maltanar/equine-health-monitor-gdp12/report/Images/pcb_mic.pdf

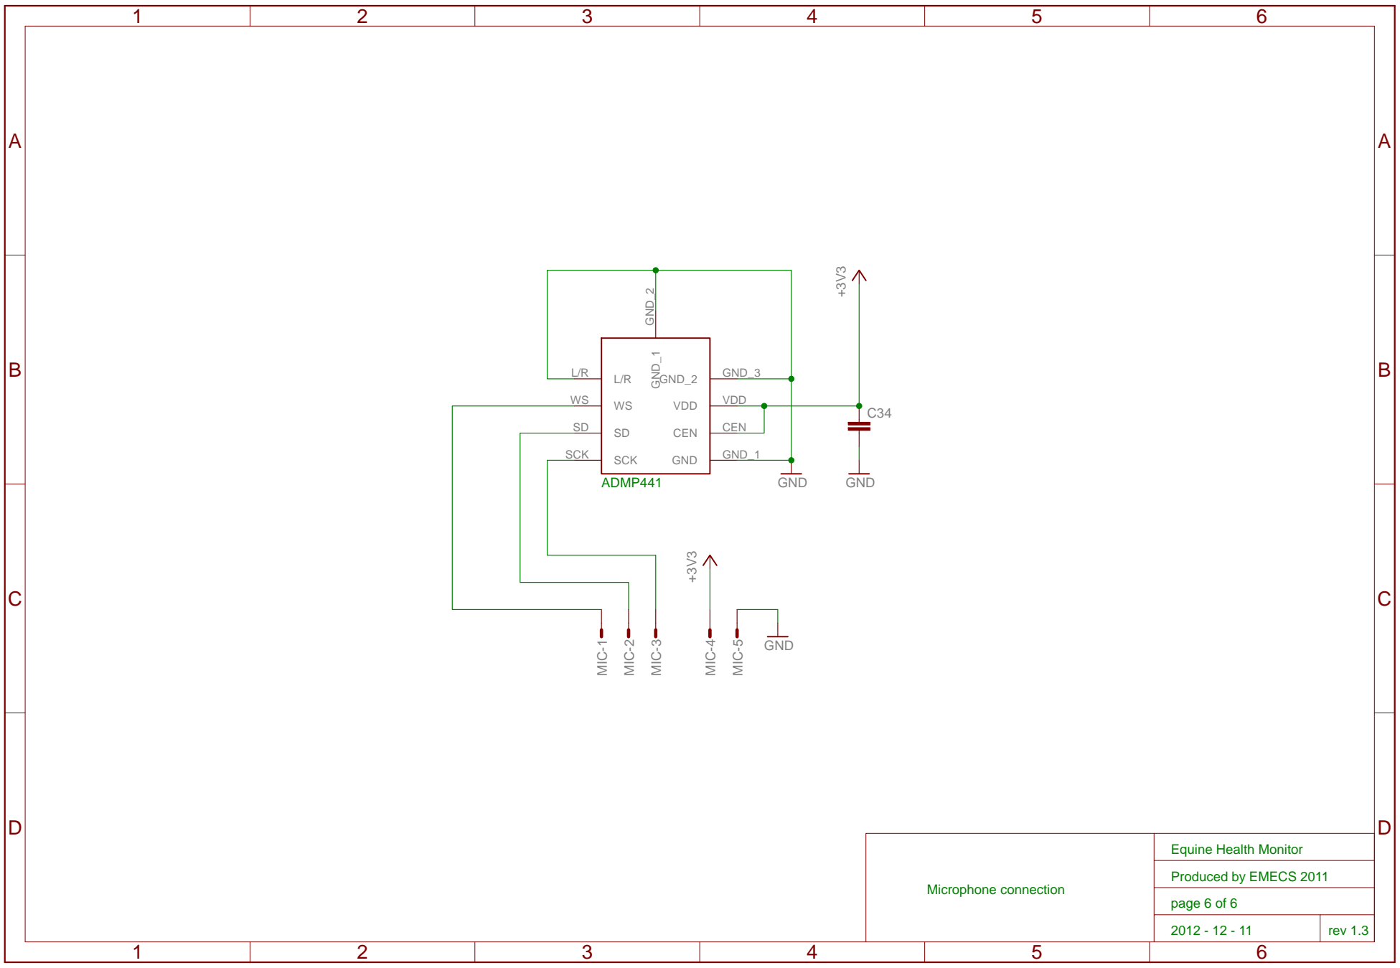
[picture p48: figure]
GND; SCK SCK; GND_1 GND_2 GND_2 GND_3; VDD; CEN; GND_1; MIC-1; MIC-2; MIC-3; MIC-4; MIC-5; ADMP441; Equine Health Monitor; Produced by EMECS 2011; page 6 of 6; rev 1.3; Microphone connection
