maltanar/equine-health-monitor-gdp12/report/Images/battery_charging.pdf

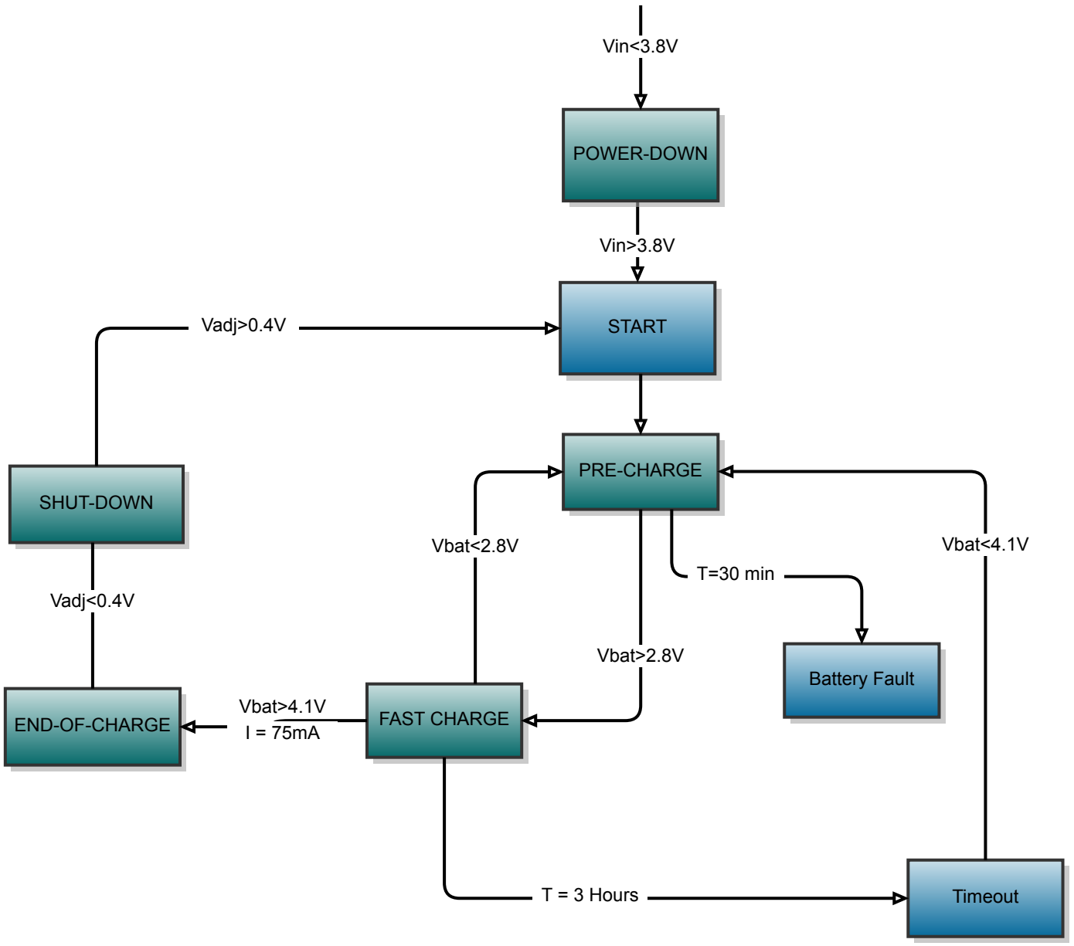
[picture p49: figure]
START; PRE-CHARGE; FAST CHARGE END-OF-CHARGE; Battery Fault; T=30 min; Vin<3.8V Vin>3.8V; SHUT-DOWN; Vbat>2.8V; Vbat>4.1V I = 75mA; Vadj<0.4V; Vbat<2.8V; T = 3 Hours; Timeout; Vbat<4.1V; Vadj>0.4V; POWER-DOWN; Vin<3.8V
