maltanar/equine-health-monitor-gdp12/report/Images/temp_barrier.pdf

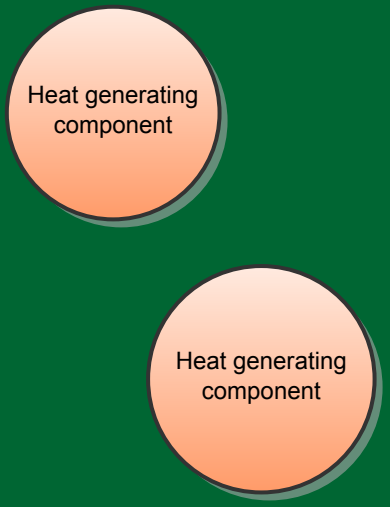
[picture p50: figure]
Heat generating component
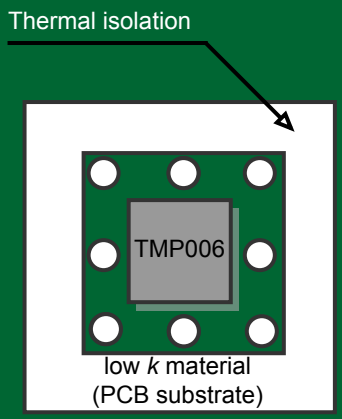
[picture p51: figure]
TMP006; Thermal isolation; low k material (PCB substrate)

high k material (Copper)
