maltanar/equine-health-monitor-gdp12/report/Images/monitoringdevice_dataflow.pdf

configuration messages from base station (set sensor period, turn on/off, configure and read parameters...)

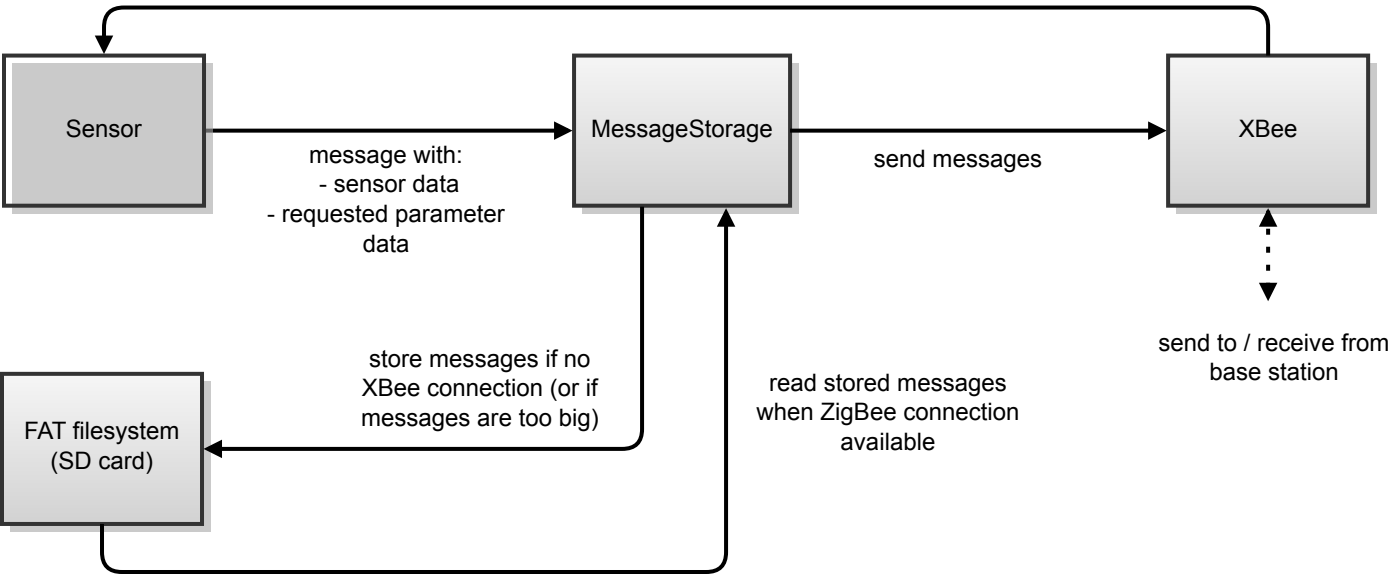
[picture p52: figure]
MessageStorage; FAT filesystem (SD card); Sensor; XBee; message with: - sensor data - requested parameter data; read stored messages when ZigBee connection available; store messages if no XBee connection (or if messages are too big); send to / receive from base station; send messages
