maltanar/equine-health-monitor-gdp12/report/Images/sampling_comparison.pdf

Polling sensor for data | Low energy periodic sampling

while(1)
{
c = readSensor();
if(c != DATA_NOT_READY)
processData(c);
}

while(1)
{
sleepUntilPeriod();
enablePeripheral();
sleepUntilDataReady();
readPeripheral();
}

MCU current

sensor current

phase | A | B | C | D
A
MCU current

sensor current
