maltanar/equine-health-monitor-gdp12/report/Images/Thermal_profile_for_ADXL350.pdf

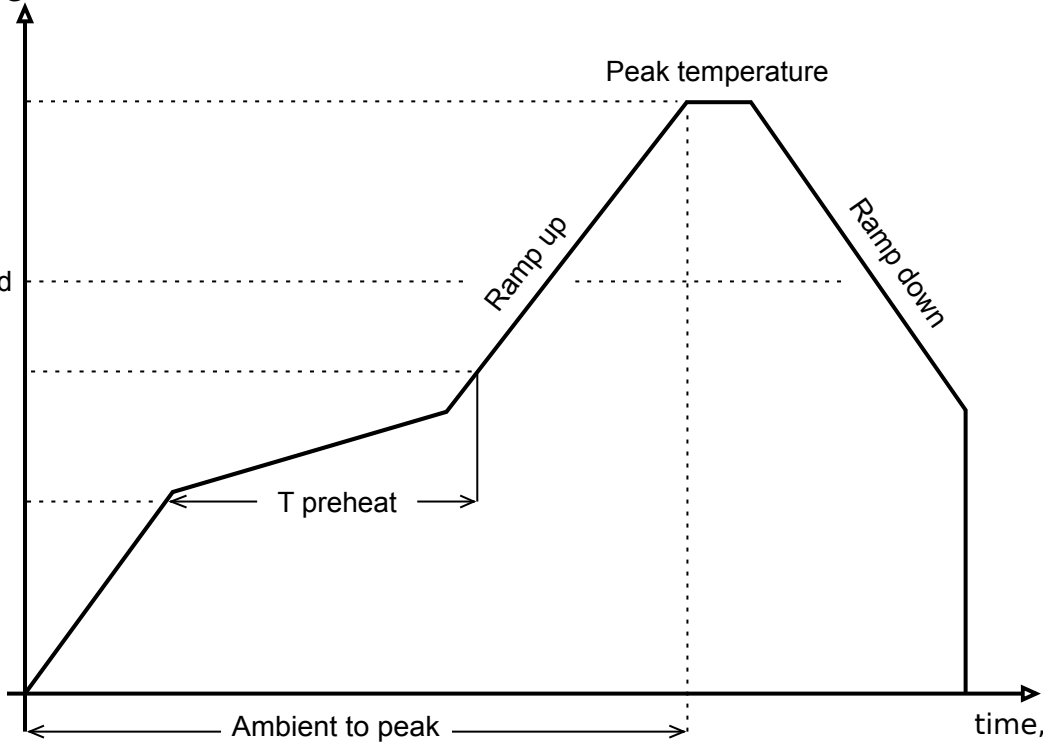
[picture p53: figure]
T preheat; Peak temperature; Ambient to peak; Ramp up; Ramp down

260C

T liquid

150C

100C

8 mins

20C

temp, C

time, min
