maltanar/equine-health-monitor-gdp12/report/Images/Thermal_profile_used.pdf

260C

Peak temperature

# Ambient to peak Ramp up

Cool down

20C

50C

13 mins

temp, C

time, min
