maltanar/equine-health-monitor-gdp12/report/dsl.tex

% redefine the icon used within the itemize environment
\renewcommand{\labelitemi}{$\diamond$}

% a custom environment that can be used to add all kinds of content
% in a centered minipage
\newenvironment{minicenter}[1][0.9]
{\begin{center}\begin{minipage}{#1\textwidth}}
{\end{minipage}\end{center}}

% define custom  environment for embedding LaTeX sourcecode
\lstnewenvironment{lx}[1][numbers=none]
{\hfill\lstset{style=myLaTeX,tabsize=2, #1}\minipage{0.9\textwidth}}
{\endminipage\hfill\null}

% command to print the text in bold and white  
% used for row / column descriptors of tables
\newcommand{\tbldescr}[1]{\textcolor{White}{\textbf{#1}}}

% command to insert a TODO marker
\newcommand{\TODO}[1]{\fcolorbox{Red}{Yellow}{
\texttt{\large
\textbf{\#TODO: #1}
}}}

\newenvironment{myacknowledgements}{%
  \renewcommand*{\abstractname}{Acknowledgments} \abstract}{%
  \endabstract
}

% custom design of the abstract section
\newenvironment{ecsabstract}
{
	\thispagestyle{empty}
	\null\vfil
	\begin{center}
		\setlength{\parskip}{0pt}
		{\normalsize \UNIVERSITY \par}
		\bigskip
		{\underline{ABSTRACT} \par}
		\bigskip
		{\normalsize \faculty \par}
		\bigskip
		{\normalsize {A Group Design Project report submitted as part of}\par
		{the European Masters on Embedded Computing Systems (EMECS)}\par}
		\bigskip
		{\normalsize\bf \mytitle \par}
		\medskip
		{\normalsize by \myauthor, \myauthori, \myauthorii, \myauthoriii \myauthoriv \par}
		\bigskip
	  \end{center}
}{\clearpage}

\newenvironment{test}{\bfseries}{}
