maltanar/equine-health-monitor-gdp12/report/Images/design_challenges.pdf

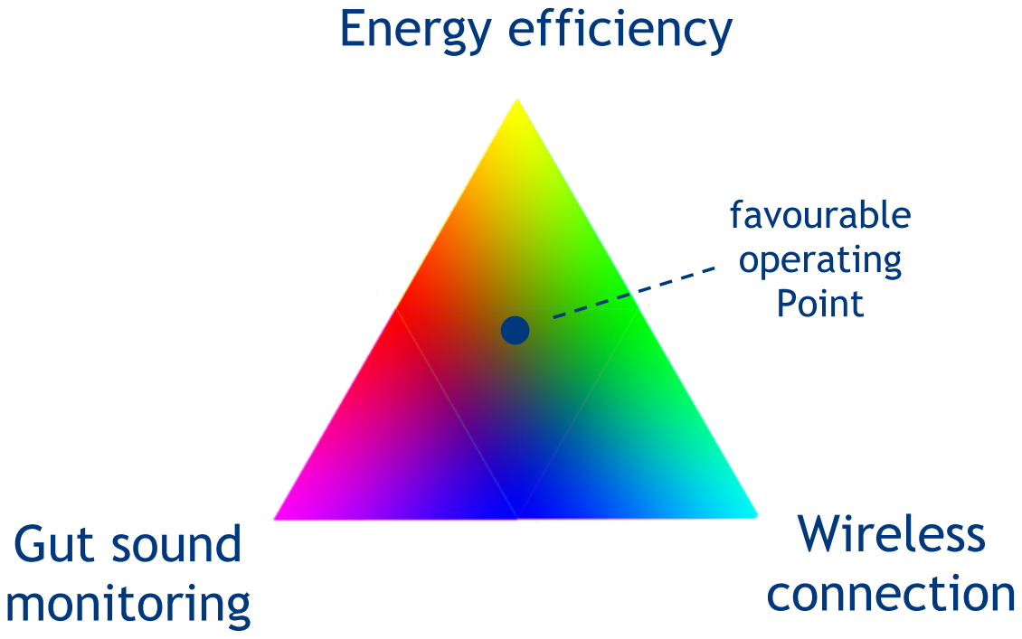
[picture p54: page 1]
