maltanar/equine-health-monitor-gdp12/report/Images/integration.jpg

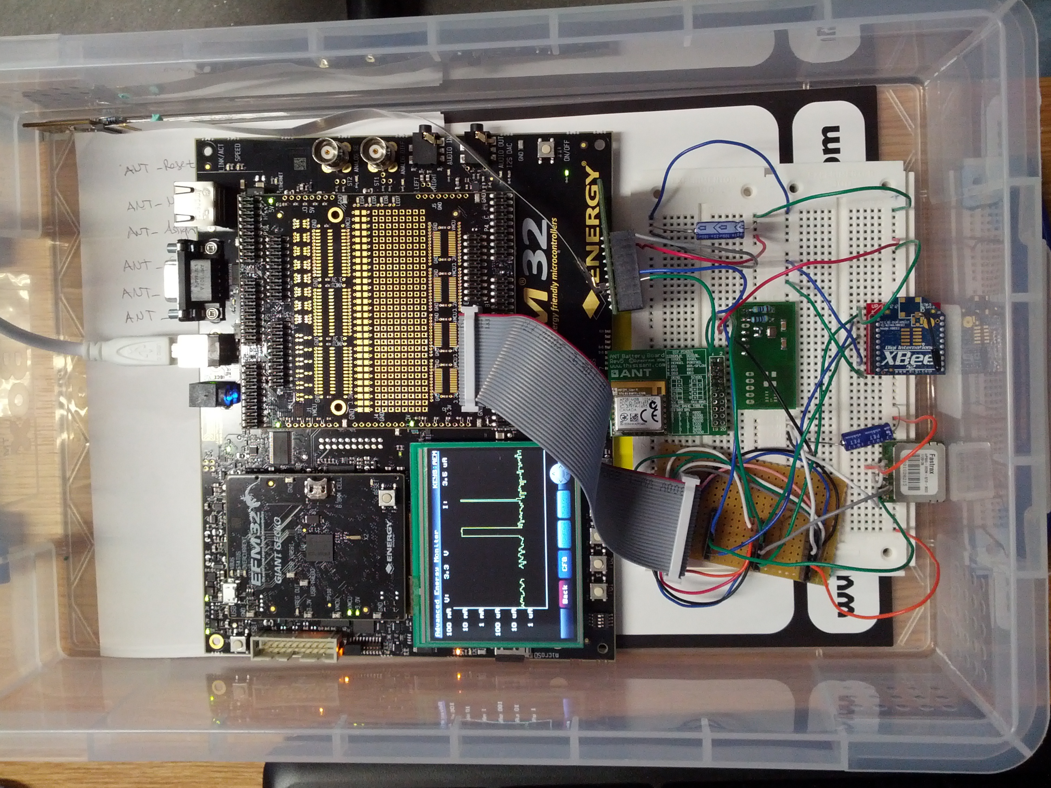
report/Images/integration.jpg
