maltanar/equine-health-monitor-gdp12/report/Images/message_storage_lifecycle.png

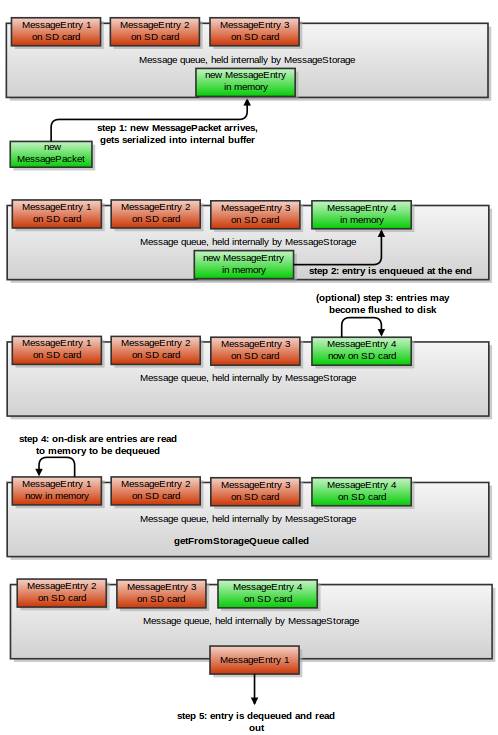
report/Images/message_storage_lifecycle.png
