maltanar/equine-health-monitor-gdp12/report/Images/mic_profile_merged.png

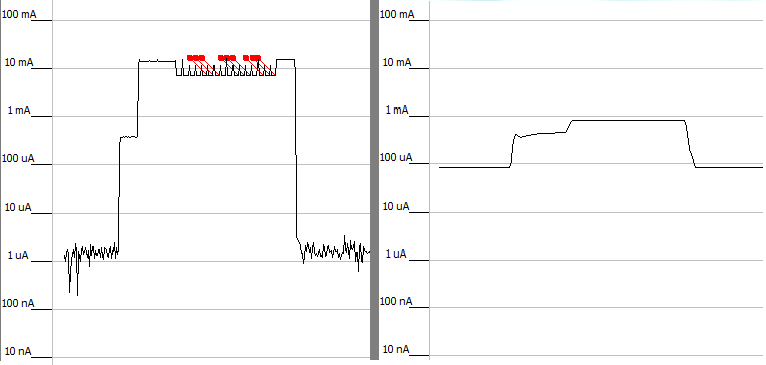
report/Images/mic_profile_merged.png
