maltanar/equine-health-monitor-gdp12/report/Content/results.tex

\chapter{Results}
\label{chap:results}
\TODO{}
