maltanar/equine-health-monitor-gdp12/report/Images/gdp_system_block.pdf

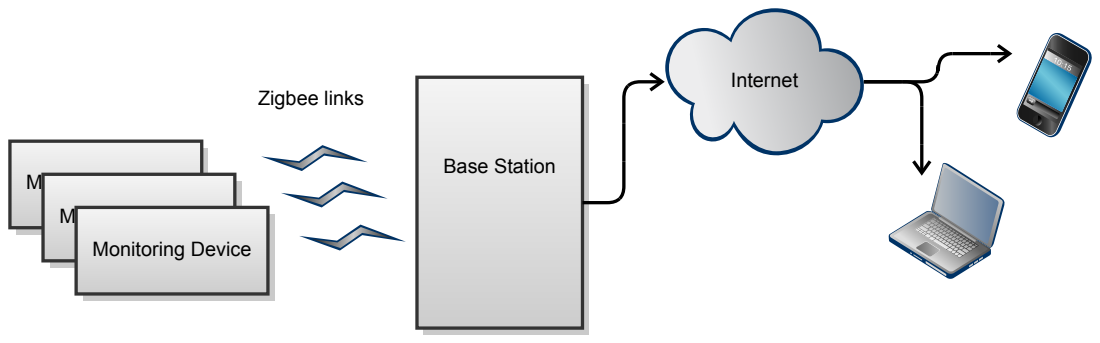
[picture p63: page 1]
Base Station; Internet; Zigbee links; Monitoring Device
