maltanar/equine-health-monitor-gdp12/report/Images/pcb_power_ldo.pdf

A

A

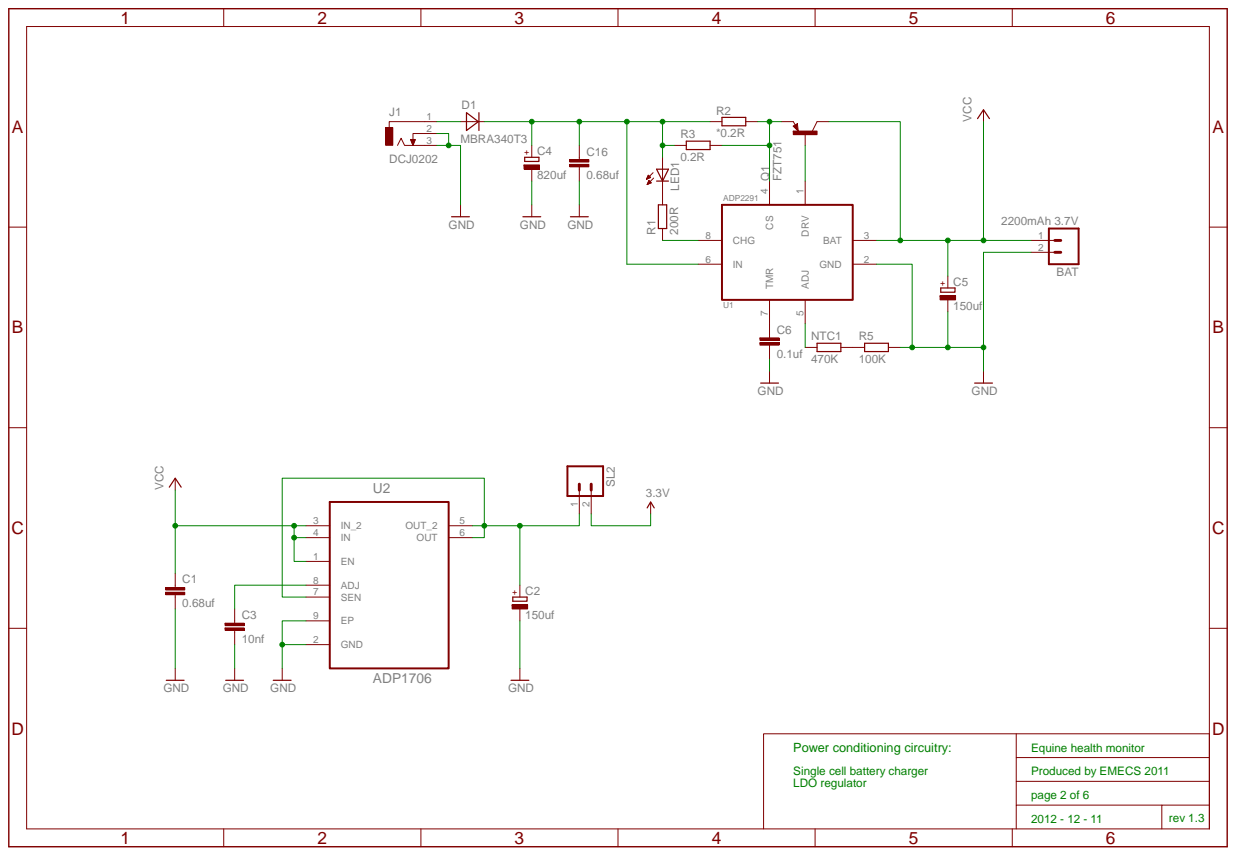
[picture p64: page 1]

Power conditioning circuitry:
Single cell battery charger
LDO regulator
