maltanar/equine-health-monitor-gdp12/report/Images/BaseStationBlockDiagram.pdf

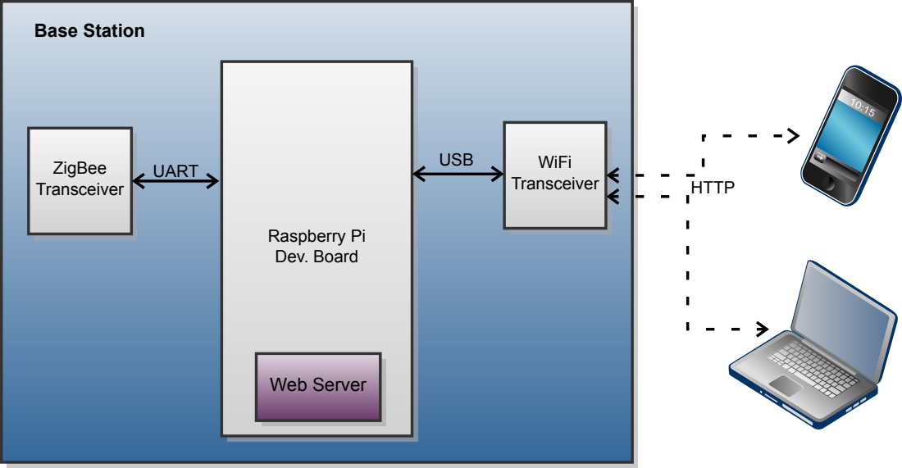
[picture p67: page 1]
Raspberry Pi Dev. Board; ZigBee Transceiver; WiFi Transceiver; UART; USB; HTTP; Base Station; Web Server
