maltanar/equine-health-monitor-gdp12/report/Images/pcb_debug_mic.pdf

A

A

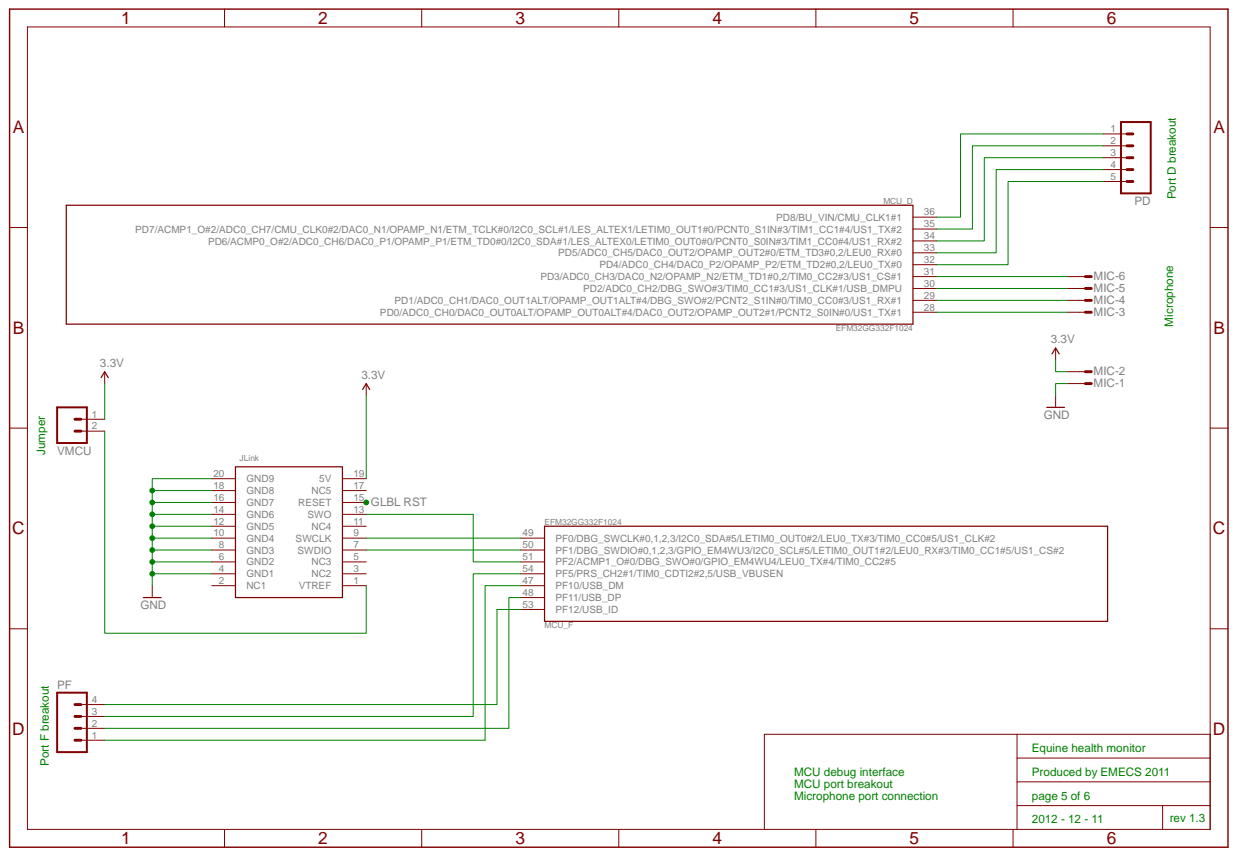
[picture p68: page 1]
GLBL RST; EFM32GG332F1024; GND; PD0/ADC0_CH0/DAC0_OUT0ALT/OPAMP_OUT0ALT#4/DAC0_OUT2/OPAMP_OUT2#1/PCNT2_S0IN#0/US1_TX#1; 28 PD1/ADC0_CH1/DAC0_OUT1ALT/OPAMP_OUT1ALT#4/DBG_SWO#2/PCNT2_S1IN#0/TIM0_CC0#3/US1_RX#1; 29 PD2/ADC0_CH2/DBG_SWO#3/TIM0_CC1#3/US1_CLK#1/USB_DMPU; 30 PD3/ADC0_CH3/DAC0_N2/OPAMP_N2/ETM_TD1#0,2/TIM0_CC2#3/US1_CS#1; 31 PD4/ADC0_CH4/DAC0_P2/OPAMP_P2/ETM_TD2#0,2/LEU0_TX#0; 32 PD5/ADC0_CH5/DAC0_OUT2/OPAMP_OUT2#0/ETM_TD3#0,2/LEU0_RX#0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

Port D breakout Microphone

Port F breakout Jumper

Equine health monitor
Produced by EMECS 2011
page 5 of 6

MCU debug interface
MCU port breakout
Microphone port connection
