maltanar/equine-health-monitor-gdp12/report/Images/pcb_ant.pdf

A

A

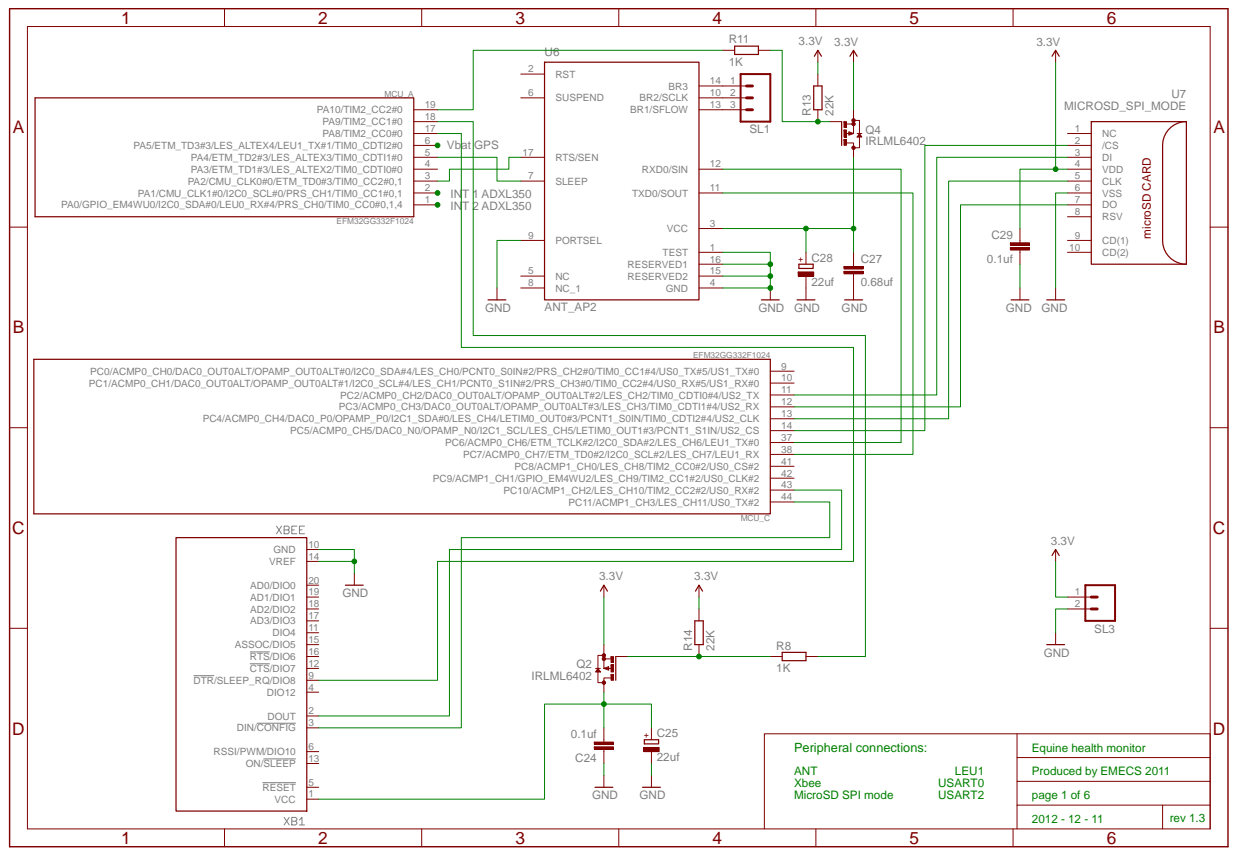
[picture p69: page 1]
