maltanar/equine-health-monitor-gdp12/report/Images/pcb_i2c_gps.pdf

A

A

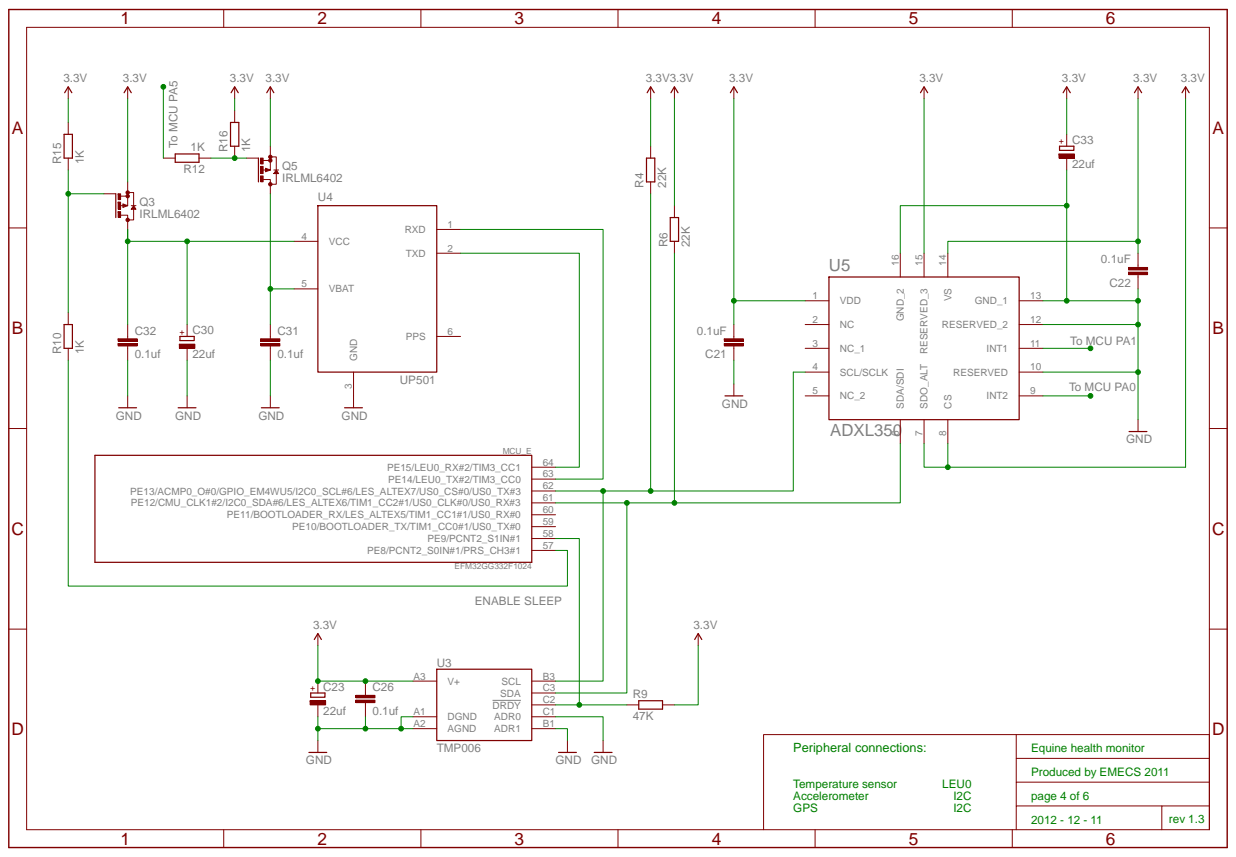
[picture p70: page 1]
