maltanar/equine-health-monitor-gdp12/report/Images/pcb_mcu_osc_reset.pdf

A

A

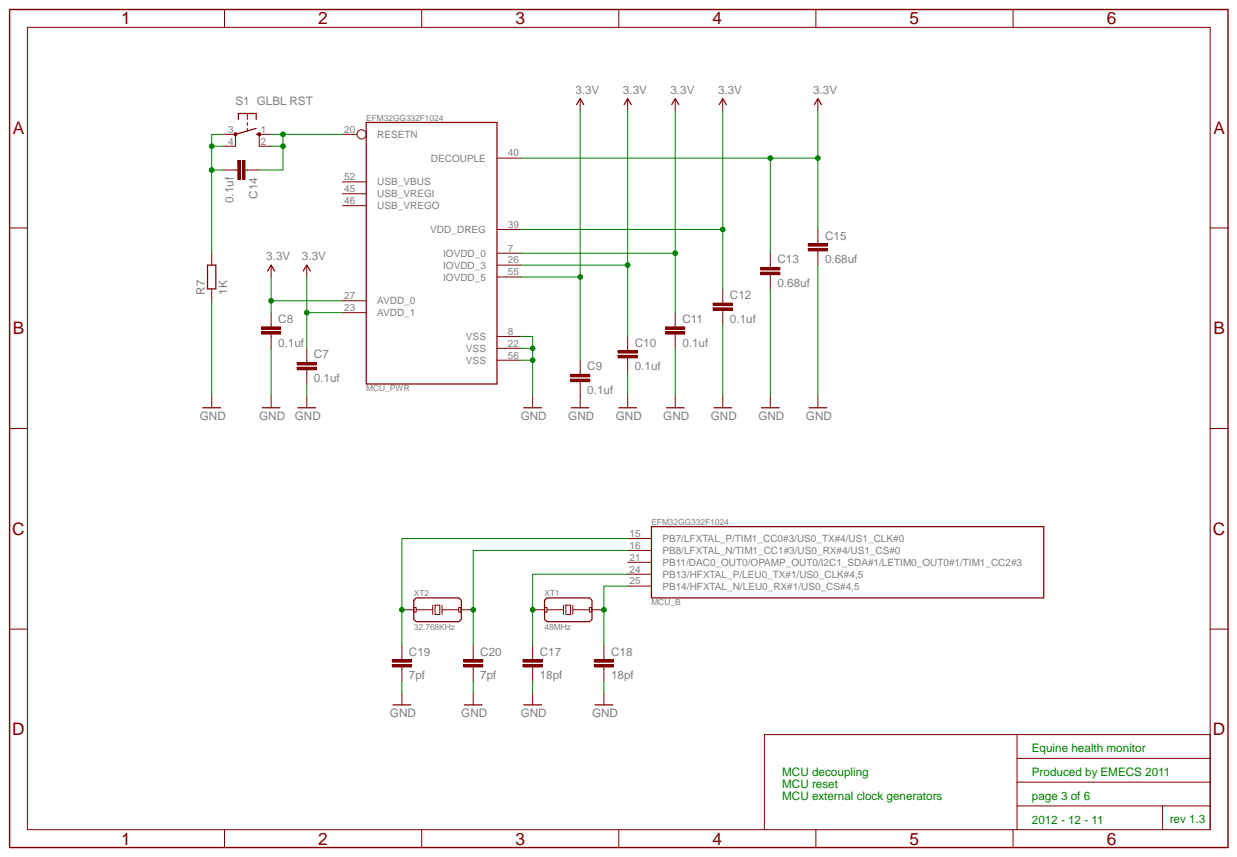
[picture p71: page 1]

MCU decoupling
MCU reset
MCU external clock generators
