maltanar/equine-health-monitor-gdp12/report/Images/dummy.pdf

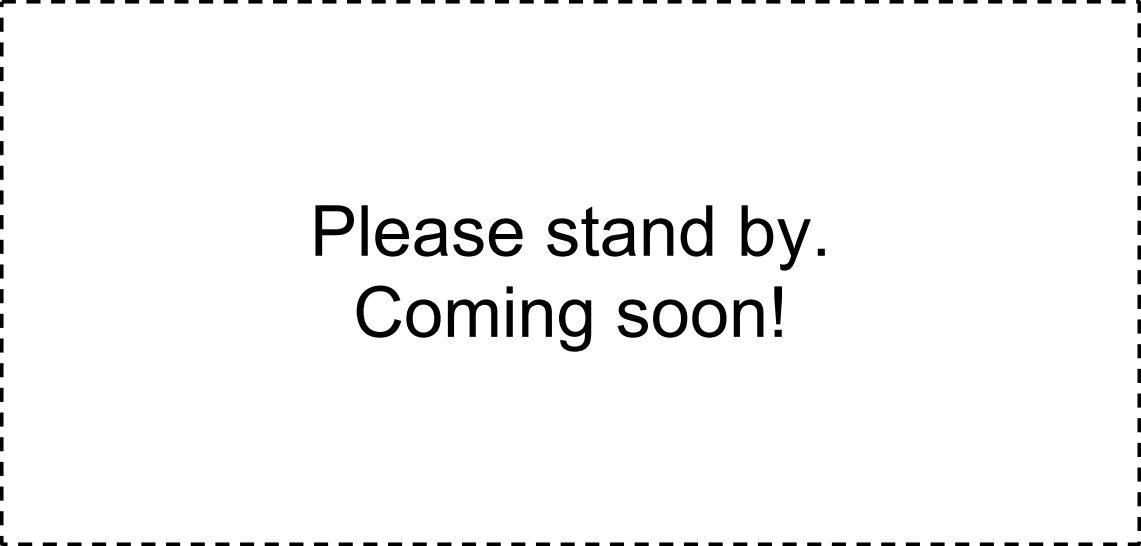
[picture p72: page 1]
