maltanar/equine-health-monitor-gdp12/pcb-monitoringdevice/common/Device/EnergyMicro/EFM32GG/Include/efm32gg_gpio.h

/**************************************************************************//**
 * @file
 * @brief efm32gg_gpio Register and Bit Field definitions
 * @author Energy Micro AS
 * @version 3.0.1
 ******************************************************************************
 * @section License
 * <b>(C) Copyright 2012 Energy Micro AS, http://www.energymicro.com</b>
 ******************************************************************************
 *
 * Permission is granted to anyone to use this software for any purpose,
 * including commercial applications, and to alter it and redistribute it
 * freely, subject to the following restrictions:
 *
 * 1. The origin of this software must not be misrepresented; you must not
 *    claim that you wrote the original software.
 * 2. Altered source versions must be plainly marked as such, and must not be
 *    misrepresented as being the original software.
 * 3. This notice may not be removed or altered from any source distribution.
 *
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
 * Energy Micro AS will not be liable for any consequential, incidental, or
 * special damages, or any other relief, or for any claim by any third party,
 * arising from your use of this Software.
 *
 *****************************************************************************/
/**************************************************************************//**
 * @defgroup EFM32GG_GPIO
 * @{
 * @brief EFM32GG_GPIO Register Declaration
 *****************************************************************************/
typedef struct
{
  GPIO_P_TypeDef P[6];          /**< Port configuration bits */

  uint32_t       RESERVED0[10]; /**< Reserved for future use **/
  __IO uint32_t  EXTIPSELL;     /**< External Interrupt Port Select Low Register  */
  __IO uint32_t  EXTIPSELH;     /**< External Interrupt Port Select High Register  */
  __IO uint32_t  EXTIRISE;      /**< External Interrupt Rising Edge Trigger Register  */
  __IO uint32_t  EXTIFALL;      /**< External Interrupt Falling Edge Trigger Register  */
  __IO uint32_t  IEN;           /**< Interrupt Enable Register  */
  __I uint32_t   IF;            /**< Interrupt Flag Register  */
  __IO uint32_t  IFS;           /**< Interrupt Flag Set Register  */
  __IO uint32_t  IFC;           /**< Interrupt Flag Clear Register  */

  __IO uint32_t  ROUTE;         /**< I/O Routing Register  */
  __IO uint32_t  INSENSE;       /**< Input Sense Register  */
  __IO uint32_t  LOCK;          /**< Configuration Lock Register  */
  __IO uint32_t  CTRL;          /**< GPIO Control Register  */
  __IO uint32_t  CMD;           /**< GPIO Command Register  */
  __IO uint32_t  EM4WUEN;       /**< EM4 Wake-up Enable Register  */
  __IO uint32_t  EM4WUPOL;      /**< EM4 Wake-up Polarity Register  */
  __I uint32_t   EM4WUCAUSE;    /**< EM4 Wake-up Cause Register  */
} GPIO_TypeDef;                 /** @} */

/**************************************************************************//**
 * @defgroup EFM32GG_GPIO_BitFields
 * @{
 *****************************************************************************/

/* Bit fields for GPIO P_CTRL */
#define _GPIO_P_CTRL_RESETVALUE                           0x00000000UL                           /**< Default value for GPIO_P_CTRL */
#define _GPIO_P_CTRL_MASK                                 0x00000003UL                           /**< Mask for GPIO_P_CTRL */
#define _GPIO_P_CTRL_DRIVEMODE_SHIFT                      0                                      /**< Shift value for GPIO_DRIVEMODE */
#define _GPIO_P_CTRL_DRIVEMODE_MASK                       0x3UL                                  /**< Bit mask for GPIO_DRIVEMODE */
#define _GPIO_P_CTRL_DRIVEMODE_DEFAULT                    0x00000000UL                           /**< Mode DEFAULT for GPIO_P_CTRL */
#define _GPIO_P_CTRL_DRIVEMODE_STANDARD                   0x00000000UL                           /**< Mode STANDARD for GPIO_P_CTRL */
#define _GPIO_P_CTRL_DRIVEMODE_LOWEST                     0x00000001UL                           /**< Mode LOWEST for GPIO_P_CTRL */
#define _GPIO_P_CTRL_DRIVEMODE_HIGH                       0x00000002UL                           /**< Mode HIGH for GPIO_P_CTRL */
#define _GPIO_P_CTRL_DRIVEMODE_LOW                        0x00000003UL                           /**< Mode LOW for GPIO_P_CTRL */
#define GPIO_P_CTRL_DRIVEMODE_DEFAULT                     (_GPIO_P_CTRL_DRIVEMODE_DEFAULT << 0)  /**< Shifted mode DEFAULT for GPIO_P_CTRL */
#define GPIO_P_CTRL_DRIVEMODE_STANDARD                    (_GPIO_P_CTRL_DRIVEMODE_STANDARD << 0) /**< Shifted mode STANDARD for GPIO_P_CTRL */
#define GPIO_P_CTRL_DRIVEMODE_LOWEST                      (_GPIO_P_CTRL_DRIVEMODE_LOWEST << 0)   /**< Shifted mode LOWEST for GPIO_P_CTRL */
#define GPIO_P_CTRL_DRIVEMODE_HIGH                        (_GPIO_P_CTRL_DRIVEMODE_HIGH << 0)     /**< Shifted mode HIGH for GPIO_P_CTRL */
#define GPIO_P_CTRL_DRIVEMODE_LOW                         (_GPIO_P_CTRL_DRIVEMODE_LOW << 0)      /**< Shifted mode LOW for GPIO_P_CTRL */

/* Bit fields for GPIO P_MODEL */
#define _GPIO_P_MODEL_RESETVALUE                          0x00000000UL                                          /**< Default value for GPIO_P_MODEL */
#define _GPIO_P_MODEL_MASK                                0xFFFFFFFFUL                                          /**< Mask for GPIO_P_MODEL */
#define _GPIO_P_MODEL_MODE0_SHIFT                         0                                                     /**< Shift value for GPIO_MODE0 */
#define _GPIO_P_MODEL_MODE0_MASK                          0xFUL                                                 /**< Bit mask for GPIO_MODE0 */
#define _GPIO_P_MODEL_MODE0_DEFAULT                       0x00000000UL                                          /**< Mode DEFAULT for GPIO_P_MODEL */
#define _GPIO_P_MODEL_MODE0_DISABLED                      0x00000000UL                                          /**< Mode DISABLED for GPIO_P_MODEL */
#define _GPIO_P_MODEL_MODE0_INPUT                         0x00000001UL                                          /**< Mode INPUT for GPIO_P_MODEL */
#define _GPIO_P_MODEL_MODE0_INPUTPULL                     0x00000002UL                                          /**< Mode INPUTPULL for GPIO_P_MODEL */
#define _GPIO_P_MODEL_MODE0_INPUTPULLFILTER               0x00000003UL                                          /**< Mode INPUTPULLFILTER for GPIO_P_MODEL */
#define _GPIO_P_MODEL_MODE0_PUSHPULL                      0x00000004UL                                          /**< Mode PUSHPULL for GPIO_P_MODEL */
#define _GPIO_P_MODEL_MODE0_PUSHPULLDRIVE                 0x00000005UL                                          /**< Mode PUSHPULLDRIVE for GPIO_P_MODEL */
#define _GPIO_P_MODEL_MODE0_WIREDOR                       0x00000006UL                                          /**< Mode WIREDOR for GPIO_P_MODEL */
#define _GPIO_P_MODEL_MODE0_WIREDORPULLDOWN               0x00000007UL                                          /**< Mode WIREDORPULLDOWN for GPIO_P_MODEL */
#define _GPIO_P_MODEL_MODE0_WIREDAND                      0x00000008UL                                          /**< Mode WIREDAND for GPIO_P_MODEL */
#define _GPIO_P_MODEL_MODE0_WIREDANDFILTER                0x00000009UL                                          /**< Mode WIREDANDFILTER for GPIO_P_MODEL */
#define _GPIO_P_MODEL_MODE0_WIREDANDPULLUP                0x0000000AUL                                          /**< Mode WIREDANDPULLUP for GPIO_P_MODEL */
#define _GPIO_P_MODEL_MODE0_WIREDANDPULLUPFILTER          0x0000000BUL                                          /**< Mode WIREDANDPULLUPFILTER for GPIO_P_MODEL */
#define _GPIO_P_MODEL_MODE0_WIREDANDDRIVE                 0x0000000CUL                                          /**< Mode WIREDANDDRIVE for GPIO_P_MODEL */
#define _GPIO_P_MODEL_MODE0_WIREDANDDRIVEFILTER           0x0000000DUL                                          /**< Mode WIREDANDDRIVEFILTER for GPIO_P_MODEL */
#define _GPIO_P_MODEL_MODE0_WIREDANDDRIVEPULLUP           0x0000000EUL                                          /**< Mode WIREDANDDRIVEPULLUP for GPIO_P_MODEL */
#define _GPIO_P_MODEL_MODE0_WIREDANDDRIVEPULLUPFILTER     0x0000000FUL                                          /**< Mode WIREDANDDRIVEPULLUPFILTER for GPIO_P_MODEL */
#define GPIO_P_MODEL_MODE0_DEFAULT                        (_GPIO_P_MODEL_MODE0_DEFAULT << 0)                    /**< Shifted mode DEFAULT for GPIO_P_MODEL */
#define GPIO_P_MODEL_MODE0_DISABLED                       (_GPIO_P_MODEL_MODE0_DISABLED << 0)                   /**< Shifted mode DISABLED for GPIO_P_MODEL */
#define GPIO_P_MODEL_MODE0_INPUT                          (_GPIO_P_MODEL_MODE0_INPUT << 0)                      /**< Shifted mode INPUT for GPIO_P_MODEL */
#define GPIO_P_MODEL_MODE0_INPUTPULL                      (_GPIO_P_MODEL_MODE0_INPUTPULL << 0)                  /**< Shifted mode INPUTPULL for GPIO_P_MODEL */
#define GPIO_P_MODEL_MODE0_INPUTPULLFILTER                (_GPIO_P_MODEL_MODE0_INPUTPULLFILTER << 0)            /**< Shifted mode INPUTPULLFILTER for GPIO_P_MODEL */
#define GPIO_P_MODEL_MODE0_PUSHPULL                       (_GPIO_P_MODEL_MODE0_PUSHPULL << 0)                   /**< Shifted mode PUSHPULL for GPIO_P_MODEL */
#define GPIO_P_MODEL_MODE0_PUSHPULLDRIVE                  (_GPIO_P_MODEL_MODE0_PUSHPULLDRIVE << 0)              /**< Shifted mode PUSHPULLDRIVE for GPIO_P_MODEL */
#define GPIO_P_MODEL_MODE0_WIREDOR                        (_GPIO_P_MODEL_MODE0_WIREDOR << 0)                    /**< Shifted mode WIREDOR for GPIO_P_MODEL */
#define GPIO_P_MODEL_MODE0_WIREDORPULLDOWN                (_GPIO_P_MODEL_MODE0_WIREDORPULLDOWN << 0)            /**< Shifted mode WIREDORPULLDOWN for GPIO_P_MODEL */
#define GPIO_P_MODEL_MODE0_WIREDAND                       (_GPIO_P_MODEL_MODE0_WIREDAND << 0)                   /**< Shifted mode WIREDAND for GPIO_P_MODEL */
#define GPIO_P_MODEL_MODE0_WIREDANDFILTER                 (_GPIO_P_MODEL_MODE0_WIREDANDFILTER << 0)             /**< Shifted mode WIREDANDFILTER for GPIO_P_MODEL */
#define GPIO_P_MODEL_MODE0_WIREDANDPULLUP                 (_GPIO_P_MODEL_MODE0_WIREDANDPULLUP << 0)             /**< Shifted mode WIREDANDPULLUP for GPIO_P_MODEL */
#define GPIO_P_MODEL_MODE0_WIREDANDPULLUPFILTER           (_GPIO_P_MODEL_MODE0_WIREDANDPULLUPFILTER << 0)       /**< Shifted mode WIREDANDPULLUPFILTER for GPIO_P_MODEL */
#define GPIO_P_MODEL_MODE0_WIREDANDDRIVE                  (_GPIO_P_MODEL_MODE0_WIREDANDDRIVE << 0)              /**< Shifted mode WIREDANDDRIVE for GPIO_P_MODEL */
#define GPIO_P_MODEL_MODE0_WIREDANDDRIVEFILTER            (_GPIO_P_MODEL_MODE0_WIREDANDDRIVEFILTER << 0)        /**< Shifted mode WIREDANDDRIVEFILTER for GPIO_P_MODEL */
#define GPIO_P_MODEL_MODE0_WIREDANDDRIVEPULLUP            (_GPIO_P_MODEL_MODE0_WIREDANDDRIVEPULLUP << 0)        /**< Shifted mode WIREDANDDRIVEPULLUP for GPIO_P_MODEL */
#define GPIO_P_MODEL_MODE0_WIREDANDDRIVEPULLUPFILTER      (_GPIO_P_MODEL_MODE0_WIREDANDDRIVEPULLUPFILTER << 0)  /**< Shifted mode WIREDANDDRIVEPULLUPFILTER for GPIO_P_MODEL */
#define _GPIO_P_MODEL_MODE1_SHIFT                         4                                                     /**< Shift value for GPIO_MODE1 */
#define _GPIO_P_MODEL_MODE1_MASK                          0xF0UL                                                /**< Bit mask for GPIO_MODE1 */
#define _GPIO_P_MODEL_MODE1_DEFAULT                       0x00000000UL                                          /**< Mode DEFAULT for GPIO_P_MODEL */
#define _GPIO_P_MODEL_MODE1_DISABLED                      0x00000000UL                                          /**< Mode DISABLED for GPIO_P_MODEL */
#define _GPIO_P_MODEL_MODE1_INPUT                         0x00000001UL                                          /**< Mode INPUT for GPIO_P_MODEL */
#define _GPIO_P_MODEL_MODE1_INPUTPULL                     0x00000002UL                                          /**< Mode INPUTPULL for GPIO_P_MODEL */
#define _GPIO_P_MODEL_MODE1_INPUTPULLFILTER               0x00000003UL                                          /**< Mode INPUTPULLFILTER for GPIO_P_MODEL */
#define _GPIO_P_MODEL_MODE1_PUSHPULL                      0x00000004UL                                          /**< Mode PUSHPULL for GPIO_P_MODEL */
#define _GPIO_P_MODEL_MODE1_PUSHPULLDRIVE                 0x00000005UL                                          /**< Mode PUSHPULLDRIVE for GPIO_P_MODEL */
#define _GPIO_P_MODEL_MODE1_WIREDOR                       0x00000006UL                                          /**< Mode WIREDOR for GPIO_P_MODEL */
#define _GPIO_P_MODEL_MODE1_WIREDORPULLDOWN               0x00000007UL                                          /**< Mode WIREDORPULLDOWN for GPIO_P_MODEL */
#define _GPIO_P_MODEL_MODE1_WIREDAND                      0x00000008UL                                          /**< Mode WIREDAND for GPIO_P_MODEL */
#define _GPIO_P_MODEL_MODE1_WIREDANDFILTER                0x00000009UL                                          /**< Mode WIREDANDFILTER for GPIO_P_MODEL */
#define _GPIO_P_MODEL_MODE1_WIREDANDPULLUP                0x0000000AUL                                          /**< Mode WIREDANDPULLUP for GPIO_P_MODEL */
#define _GPIO_P_MODEL_MODE1_WIREDANDPULLUPFILTER          0x0000000BUL                                          /**< Mode WIREDANDPULLUPFILTER for GPIO_P_MODEL */
#define _GPIO_P_MODEL_MODE1_WIREDANDDRIVE                 0x0000000CUL                                          /**< Mode WIREDANDDRIVE for GPIO_P_MODEL */
#define _GPIO_P_MODEL_MODE1_WIREDANDDRIVEFILTER           0x0000000DUL                                          /**< Mode WIREDANDDRIVEFILTER for GPIO_P_MODEL */
#define _GPIO_P_MODEL_MODE1_WIREDANDDRIVEPULLUP           0x0000000EUL                                          /**< Mode WIREDANDDRIVEPULLUP for GPIO_P_MODEL */
#define _GPIO_P_MODEL_MODE1_WIREDANDDRIVEPULLUPFILTER     0x0000000FUL                                          /**< Mode WIREDANDDRIVEPULLUPFILTER for GPIO_P_MODEL */
#define GPIO_P_MODEL_MODE1_DEFAULT                        (_GPIO_P_MODEL_MODE1_DEFAULT << 4)                    /**< Shifted mode DEFAULT for GPIO_P_MODEL */
#define GPIO_P_MODEL_MODE1_DISABLED                       (_GPIO_P_MODEL_MODE1_DISABLED << 4)                   /**< Shifted mode DISABLED for GPIO_P_MODEL */
#define GPIO_P_MODEL_MODE1_INPUT                          (_GPIO_P_MODEL_MODE1_INPUT << 4)                      /**< Shifted mode INPUT for GPIO_P_MODEL */
#define GPIO_P_MODEL_MODE1_INPUTPULL                      (_GPIO_P_MODEL_MODE1_INPUTPULL << 4)                  /**< Shifted mode INPUTPULL for GPIO_P_MODEL */
#define GPIO_P_MODEL_MODE1_INPUTPULLFILTER                (_GPIO_P_MODEL_MODE1_INPUTPULLFILTER << 4)            /**< Shifted mode INPUTPULLFILTER for GPIO_P_MODEL */
#define GPIO_P_MODEL_MODE1_PUSHPULL                       (_GPIO_P_MODEL_MODE1_PUSHPULL << 4)                   /**< Shifted mode PUSHPULL for GPIO_P_MODEL */
#define GPIO_P_MODEL_MODE1_PUSHPULLDRIVE                  (_GPIO_P_MODEL_MODE1_PUSHPULLDRIVE << 4)              /**< Shifted mode PUSHPULLDRIVE for GPIO_P_MODEL */
#define GPIO_P_MODEL_MODE1_WIREDOR                        (_GPIO_P_MODEL_MODE1_WIREDOR << 4)                    /**< Shifted mode WIREDOR for GPIO_P_MODEL */
#define GPIO_P_MODEL_MODE1_WIREDORPULLDOWN                (_GPIO_P_MODEL_MODE1_WIREDORPULLDOWN << 4)            /**< Shifted mode WIREDORPULLDOWN for GPIO_P_MODEL */
#define GPIO_P_MODEL_MODE1_WIREDAND                       (_GPIO_P_MODEL_MODE1_WIREDAND << 4)                   /**< Shifted mode WIREDAND for GPIO_P_MODEL */
#define GPIO_P_MODEL_MODE1_WIREDANDFILTER                 (_GPIO_P_MODEL_MODE1_WIREDANDFILTER << 4)             /**< Shifted mode WIREDANDFILTER for GPIO_P_MODEL */
#define GPIO_P_MODEL_MODE1_WIREDANDPULLUP                 (_GPIO_P_MODEL_MODE1_WIREDANDPULLUP << 4)             /**< Shifted mode WIREDANDPULLUP for GPIO_P_MODEL */
#define GPIO_P_MODEL_MODE1_WIREDANDPULLUPFILTER           (_GPIO_P_MODEL_MODE1_WIREDANDPULLUPFILTER << 4)       /**< Shifted mode WIREDANDPULLUPFILTER for GPIO_P_MODEL */
#define GPIO_P_MODEL_MODE1_WIREDANDDRIVE                  (_GPIO_P_MODEL_MODE1_WIREDANDDRIVE << 4)              /**< Shifted mode WIREDANDDRIVE for GPIO_P_MODEL */
#define GPIO_P_MODEL_MODE1_WIREDANDDRIVEFILTER            (_GPIO_P_MODEL_MODE1_WIREDANDDRIVEFILTER << 4)        /**< Shifted mode WIREDANDDRIVEFILTER for GPIO_P_MODEL */
#define GPIO_P_MODEL_MODE1_WIREDANDDRIVEPULLUP            (_GPIO_P_MODEL_MODE1_WIREDANDDRIVEPULLUP << 4)        /**< Shifted mode WIREDANDDRIVEPULLUP for GPIO_P_MODEL */
#define GPIO_P_MODEL_MODE1_WIREDANDDRIVEPULLUPFILTER      (_GPIO_P_MODEL_MODE1_WIREDANDDRIVEPULLUPFILTER << 4)  /**< Shifted mode WIREDANDDRIVEPULLUPFILTER for GPIO_P_MODEL */
#define _GPIO_P_MODEL_MODE2_SHIFT                         8                                                     /**< Shift value for GPIO_MODE2 */
#define _GPIO_P_MODEL_MODE2_MASK                          0xF00UL                                               /**< Bit mask for GPIO_MODE2 */
#define _GPIO_P_MODEL_MODE2_DEFAULT                       0x00000000UL                                          /**< Mode DEFAULT for GPIO_P_MODEL */
#define _GPIO_P_MODEL_MODE2_DISABLED                      0x00000000UL                                          /**< Mode DISABLED for GPIO_P_MODEL */
#define _GPIO_P_MODEL_MODE2_INPUT                         0x00000001UL                                          /**< Mode INPUT for GPIO_P_MODEL */
#define _GPIO_P_MODEL_MODE2_INPUTPULL                     0x00000002UL                                          /**< Mode INPUTPULL for GPIO_P_MODEL */
#define _GPIO_P_MODEL_MODE2_INPUTPULLFILTER               0x00000003UL                                          /**< Mode INPUTPULLFILTER for GPIO_P_MODEL */
#define _GPIO_P_MODEL_MODE2_PUSHPULL                      0x00000004UL                                          /**< Mode PUSHPULL for GPIO_P_MODEL */
#define _GPIO_P_MODEL_MODE2_PUSHPULLDRIVE                 0x00000005UL                                          /**< Mode PUSHPULLDRIVE for GPIO_P_MODEL */
#define _GPIO_P_MODEL_MODE2_WIREDOR                       0x00000006UL                                          /**< Mode WIREDOR for GPIO_P_MODEL */
#define _GPIO_P_MODEL_MODE2_WIREDORPULLDOWN               0x00000007UL                                          /**< Mode WIREDORPULLDOWN for GPIO_P_MODEL */
#define _GPIO_P_MODEL_MODE2_WIREDAND                      0x00000008UL                                          /**< Mode WIREDAND for GPIO_P_MODEL */
#define _GPIO_P_MODEL_MODE2_WIREDANDFILTER                0x00000009UL                                          /**< Mode WIREDANDFILTER for GPIO_P_MODEL */
#define _GPIO_P_MODEL_MODE2_WIREDANDPULLUP                0x0000000AUL                                          /**< Mode WIREDANDPULLUP for GPIO_P_MODEL */
#define _GPIO_P_MODEL_MODE2_WIREDANDPULLUPFILTER          0x0000000BUL                                          /**< Mode WIREDANDPULLUPFILTER for GPIO_P_MODEL */
#define _GPIO_P_MODEL_MODE2_WIREDANDDRIVE                 0x0000000CUL                                          /**< Mode WIREDANDDRIVE for GPIO_P_MODEL */
#define _GPIO_P_MODEL_MODE2_WIREDANDDRIVEFILTER           0x0000000DUL                                          /**< Mode WIREDANDDRIVEFILTER for GPIO_P_MODEL */
#define _GPIO_P_MODEL_MODE2_WIREDANDDRIVEPULLUP           0x0000000EUL                                          /**< Mode WIREDANDDRIVEPULLUP for GPIO_P_MODEL */
#define _GPIO_P_MODEL_MODE2_WIREDANDDRIVEPULLUPFILTER     0x0000000FUL                                          /**< Mode WIREDANDDRIVEPULLUPFILTER for GPIO_P_MODEL */
#define GPIO_P_MODEL_MODE2_DEFAULT                        (_GPIO_P_MODEL_MODE2_DEFAULT << 8)                    /**< Shifted mode DEFAULT for GPIO_P_MODEL */
#define GPIO_P_MODEL_MODE2_DISABLED                       (_GPIO_P_MODEL_MODE2_DISABLED << 8)                   /**< Shifted mode DISABLED for GPIO_P_MODEL */
#define GPIO_P_MODEL_MODE2_INPUT                          (_GPIO_P_MODEL_MODE2_INPUT << 8)                      /**< Shifted mode INPUT for GPIO_P_MODEL */
#define GPIO_P_MODEL_MODE2_INPUTPULL                      (_GPIO_P_MODEL_MODE2_INPUTPULL << 8)                  /**< Shifted mode INPUTPULL for GPIO_P_MODEL */
#define GPIO_P_MODEL_MODE2_INPUTPULLFILTER                (_GPIO_P_MODEL_MODE2_INPUTPULLFILTER << 8)            /**< Shifted mode INPUTPULLFILTER for GPIO_P_MODEL */
#define GPIO_P_MODEL_MODE2_PUSHPULL                       (_GPIO_P_MODEL_MODE2_PUSHPULL << 8)                   /**< Shifted mode PUSHPULL for GPIO_P_MODEL */
#define GPIO_P_MODEL_MODE2_PUSHPULLDRIVE                  (_GPIO_P_MODEL_MODE2_PUSHPULLDRIVE << 8)              /**< Shifted mode PUSHPULLDRIVE for GPIO_P_MODEL */
#define GPIO_P_MODEL_MODE2_WIREDOR                        (_GPIO_P_MODEL_MODE2_WIREDOR << 8)                    /**< Shifted mode WIREDOR for GPIO_P_MODEL */
#define GPIO_P_MODEL_MODE2_WIREDORPULLDOWN                (_GPIO_P_MODEL_MODE2_WIREDORPULLDOWN << 8)            /**< Shifted mode WIREDORPULLDOWN for GPIO_P_MODEL */
#define GPIO_P_MODEL_MODE2_WIREDAND                       (_GPIO_P_MODEL_MODE2_WIREDAND << 8)                   /**< Shifted mode WIREDAND for GPIO_P_MODEL */
#define GPIO_P_MODEL_MODE2_WIREDANDFILTER                 (_GPIO_P_MODEL_MODE2_WIREDANDFILTER << 8)             /**< Shifted mode WIREDANDFILTER for GPIO_P_MODEL */
#define GPIO_P_MODEL_MODE2_WIREDANDPULLUP                 (_GPIO_P_MODEL_MODE2_WIREDANDPULLUP << 8)             /**< Shifted mode WIREDANDPULLUP for GPIO_P_MODEL */
#define GPIO_P_MODEL_MODE2_WIREDANDPULLUPFILTER           (_GPIO_P_MODEL_MODE2_WIREDANDPULLUPFILTER << 8)       /**< Shifted mode WIREDANDPULLUPFILTER for GPIO_P_MODEL */
#define GPIO_P_MODEL_MODE2_WIREDANDDRIVE                  (_GPIO_P_MODEL_MODE2_WIREDANDDRIVE << 8)              /**< Shifted mode WIREDANDDRIVE for GPIO_P_MODEL */
#define GPIO_P_MODEL_MODE2_WIREDANDDRIVEFILTER            (_GPIO_P_MODEL_MODE2_WIREDANDDRIVEFILTER << 8)        /**< Shifted mode WIREDANDDRIVEFILTER for GPIO_P_MODEL */
#define GPIO_P_MODEL_MODE2_WIREDANDDRIVEPULLUP            (_GPIO_P_MODEL_MODE2_WIREDANDDRIVEPULLUP << 8)        /**< Shifted mode WIREDANDDRIVEPULLUP for GPIO_P_MODEL */
#define GPIO_P_MODEL_MODE2_WIREDANDDRIVEPULLUPFILTER      (_GPIO_P_MODEL_MODE2_WIREDANDDRIVEPULLUPFILTER << 8)  /**< Shifted mode WIREDANDDRIVEPULLUPFILTER for GPIO_P_MODEL */
#define _GPIO_P_MODEL_MODE3_SHIFT                         12                                                    /**< Shift value for GPIO_MODE3 */
#define _GPIO_P_MODEL_MODE3_MASK                          0xF000UL                                              /**< Bit mask for GPIO_MODE3 */
#define _GPIO_P_MODEL_MODE3_DEFAULT                       0x00000000UL                                          /**< Mode DEFAULT for GPIO_P_MODEL */
#define _GPIO_P_MODEL_MODE3_DISABLED                      0x00000000UL                                          /**< Mode DISABLED for GPIO_P_MODEL */
#define _GPIO_P_MODEL_MODE3_INPUT                         0x00000001UL                                          /**< Mode INPUT for GPIO_P_MODEL */
#define _GPIO_P_MODEL_MODE3_INPUTPULL                     0x00000002UL                                          /**< Mode INPUTPULL for GPIO_P_MODEL */
#define _GPIO_P_MODEL_MODE3_INPUTPULLFILTER               0x00000003UL                                          /**< Mode INPUTPULLFILTER for GPIO_P_MODEL */
#define _GPIO_P_MODEL_MODE3_PUSHPULL                      0x00000004UL                                          /**< Mode PUSHPULL for GPIO_P_MODEL */
#define _GPIO_P_MODEL_MODE3_PUSHPULLDRIVE                 0x00000005UL                                          /**< Mode PUSHPULLDRIVE for GPIO_P_MODEL */
#define _GPIO_P_MODEL_MODE3_WIREDOR                       0x00000006UL                                          /**< Mode WIREDOR for GPIO_P_MODEL */
#define _GPIO_P_MODEL_MODE3_WIREDORPULLDOWN               0x00000007UL                                          /**< Mode WIREDORPULLDOWN for GPIO_P_MODEL */
#define _GPIO_P_MODEL_MODE3_WIREDAND                      0x00000008UL                                          /**< Mode WIREDAND for GPIO_P_MODEL */
#define _GPIO_P_MODEL_MODE3_WIREDANDFILTER                0x00000009UL                                          /**< Mode WIREDANDFILTER for GPIO_P_MODEL */
#define _GPIO_P_MODEL_MODE3_WIREDANDPULLUP                0x0000000AUL                                          /**< Mode WIREDANDPULLUP for GPIO_P_MODEL */
#define _GPIO_P_MODEL_MODE3_WIREDANDPULLUPFILTER          0x0000000BUL                                          /**< Mode WIREDANDPULLUPFILTER for GPIO_P_MODEL */
#define _GPIO_P_MODEL_MODE3_WIREDANDDRIVE                 0x0000000CUL                                          /**< Mode WIREDANDDRIVE for GPIO_P_MODEL */
#define _GPIO_P_MODEL_MODE3_WIREDANDDRIVEFILTER           0x0000000DUL                                          /**< Mode WIREDANDDRIVEFILTER for GPIO_P_MODEL */
#define _GPIO_P_MODEL_MODE3_WIREDANDDRIVEPULLUP           0x0000000EUL                                          /**< Mode WIREDANDDRIVEPULLUP for GPIO_P_MODEL */
#define _GPIO_P_MODEL_MODE3_WIREDANDDRIVEPULLUPFILTER     0x0000000FUL                                          /**< Mode WIREDANDDRIVEPULLUPFILTER for GPIO_P_MODEL */
#define GPIO_P_MODEL_MODE3_DEFAULT                        (_GPIO_P_MODEL_MODE3_DEFAULT << 12)                   /**< Shifted mode DEFAULT for GPIO_P_MODEL */
#define GPIO_P_MODEL_MODE3_DISABLED                       (_GPIO_P_MODEL_MODE3_DISABLED << 12)                  /**< Shifted mode DISABLED for GPIO_P_MODEL */
#define GPIO_P_MODEL_MODE3_INPUT                          (_GPIO_P_MODEL_MODE3_INPUT << 12)                     /**< Shifted mode INPUT for GPIO_P_MODEL */
#define GPIO_P_MODEL_MODE3_INPUTPULL                      (_GPIO_P_MODEL_MODE3_INPUTPULL << 12)                 /**< Shifted mode INPUTPULL for GPIO_P_MODEL */
#define GPIO_P_MODEL_MODE3_INPUTPULLFILTER                (_GPIO_P_MODEL_MODE3_INPUTPULLFILTER << 12)           /**< Shifted mode INPUTPULLFILTER for GPIO_P_MODEL */
#define GPIO_P_MODEL_MODE3_PUSHPULL                       (_GPIO_P_MODEL_MODE3_PUSHPULL << 12)                  /**< Shifted mode PUSHPULL for GPIO_P_MODEL */
#define GPIO_P_MODEL_MODE3_PUSHPULLDRIVE                  (_GPIO_P_MODEL_MODE3_PUSHPULLDRIVE << 12)             /**< Shifted mode PUSHPULLDRIVE for GPIO_P_MODEL */
#define GPIO_P_MODEL_MODE3_WIREDOR                        (_GPIO_P_MODEL_MODE3_WIREDOR << 12)                   /**< Shifted mode WIREDOR for GPIO_P_MODEL */
#define GPIO_P_MODEL_MODE3_WIREDORPULLDOWN                (_GPIO_P_MODEL_MODE3_WIREDORPULLDOWN << 12)           /**< Shifted mode WIREDORPULLDOWN for GPIO_P_MODEL */
#define GPIO_P_MODEL_MODE3_WIREDAND                       (_GPIO_P_MODEL_MODE3_WIREDAND << 12)                  /**< Shifted mode WIREDAND for GPIO_P_MODEL */
#define GPIO_P_MODEL_MODE3_WIREDANDFILTER                 (_GPIO_P_MODEL_MODE3_WIREDANDFILTER << 12)            /**< Shifted mode WIREDANDFILTER for GPIO_P_MODEL */
#define GPIO_P_MODEL_MODE3_WIREDANDPULLUP                 (_GPIO_P_MODEL_MODE3_WIREDANDPULLUP << 12)            /**< Shifted mode WIREDANDPULLUP for GPIO_P_MODEL */
#define GPIO_P_MODEL_MODE3_WIREDANDPULLUPFILTER           (_GPIO_P_MODEL_MODE3_WIREDANDPULLUPFILTER << 12)      /**< Shifted mode WIREDANDPULLUPFILTER for GPIO_P_MODEL */
#define GPIO_P_MODEL_MODE3_WIREDANDDRIVE                  (_GPIO_P_MODEL_MODE3_WIREDANDDRIVE << 12)             /**< Shifted mode WIREDANDDRIVE for GPIO_P_MODEL */
#define GPIO_P_MODEL_MODE3_WIREDANDDRIVEFILTER            (_GPIO_P_MODEL_MODE3_WIREDANDDRIVEFILTER << 12)       /**< Shifted mode WIREDANDDRIVEFILTER for GPIO_P_MODEL */
#define GPIO_P_MODEL_MODE3_WIREDANDDRIVEPULLUP            (_GPIO_P_MODEL_MODE3_WIREDANDDRIVEPULLUP << 12)       /**< Shifted mode WIREDANDDRIVEPULLUP for GPIO_P_MODEL */
#define GPIO_P_MODEL_MODE3_WIREDANDDRIVEPULLUPFILTER      (_GPIO_P_MODEL_MODE3_WIREDANDDRIVEPULLUPFILTER << 12) /**< Shifted mode WIREDANDDRIVEPULLUPFILTER for GPIO_P_MODEL */
#define _GPIO_P_MODEL_MODE4_SHIFT                         16                                                    /**< Shift value for GPIO_MODE4 */
#define _GPIO_P_MODEL_MODE4_MASK                          0xF0000UL                                             /**< Bit mask for GPIO_MODE4 */
#define _GPIO_P_MODEL_MODE4_DEFAULT                       0x00000000UL                                          /**< Mode DEFAULT for GPIO_P_MODEL */
#define _GPIO_P_MODEL_MODE4_DISABLED                      0x00000000UL                                          /**< Mode DISABLED for GPIO_P_MODEL */
#define _GPIO_P_MODEL_MODE4_INPUT                         0x00000001UL                                          /**< Mode INPUT for GPIO_P_MODEL */
#define _GPIO_P_MODEL_MODE4_INPUTPULL                     0x00000002UL                                          /**< Mode INPUTPULL for GPIO_P_MODEL */
#define _GPIO_P_MODEL_MODE4_INPUTPULLFILTER               0x00000003UL                                          /**< Mode INPUTPULLFILTER for GPIO_P_MODEL */
#define _GPIO_P_MODEL_MODE4_PUSHPULL                      0x00000004UL                                          /**< Mode PUSHPULL for GPIO_P_MODEL */
#define _GPIO_P_MODEL_MODE4_PUSHPULLDRIVE                 0x00000005UL                                          /**< Mode PUSHPULLDRIVE for GPIO_P_MODEL */
#define _GPIO_P_MODEL_MODE4_WIREDOR                       0x00000006UL                                          /**< Mode WIREDOR for GPIO_P_MODEL */
#define _GPIO_P_MODEL_MODE4_WIREDORPULLDOWN               0x00000007UL                                          /**< Mode WIREDORPULLDOWN for GPIO_P_MODEL */
#define _GPIO_P_MODEL_MODE4_WIREDAND                      0x00000008UL                                          /**< Mode WIREDAND for GPIO_P_MODEL */
#define _GPIO_P_MODEL_MODE4_WIREDANDFILTER                0x00000009UL                                          /**< Mode WIREDANDFILTER for GPIO_P_MODEL */
#define _GPIO_P_MODEL_MODE4_WIREDANDPULLUP                0x0000000AUL                                          /**< Mode WIREDANDPULLUP for GPIO_P_MODEL */
#define _GPIO_P_MODEL_MODE4_WIREDANDPULLUPFILTER          0x0000000BUL                                          /**< Mode WIREDANDPULLUPFILTER for GPIO_P_MODEL */
#define _GPIO_P_MODEL_MODE4_WIREDANDDRIVE                 0x0000000CUL                                          /**< Mode WIREDANDDRIVE for GPIO_P_MODEL */
#define _GPIO_P_MODEL_MODE4_WIREDANDDRIVEFILTER           0x0000000DUL                                          /**< Mode WIREDANDDRIVEFILTER for GPIO_P_MODEL */
#define _GPIO_P_MODEL_MODE4_WIREDANDDRIVEPULLUP           0x0000000EUL                                          /**< Mode WIREDANDDRIVEPULLUP for GPIO_P_MODEL */
#define _GPIO_P_MODEL_MODE4_WIREDANDDRIVEPULLUPFILTER     0x0000000FUL                                          /**< Mode WIREDANDDRIVEPULLUPFILTER for GPIO_P_MODEL */
#define GPIO_P_MODEL_MODE4_DEFAULT                        (_GPIO_P_MODEL_MODE4_DEFAULT << 16)                   /**< Shifted mode DEFAULT for GPIO_P_MODEL */
#define GPIO_P_MODEL_MODE4_DISABLED                       (_GPIO_P_MODEL_MODE4_DISABLED << 16)                  /**< Shifted mode DISABLED for GPIO_P_MODEL */
#define GPIO_P_MODEL_MODE4_INPUT                          (_GPIO_P_MODEL_MODE4_INPUT << 16)                     /**< Shifted mode INPUT for GPIO_P_MODEL */
#define GPIO_P_MODEL_MODE4_INPUTPULL                      (_GPIO_P_MODEL_MODE4_INPUTPULL << 16)                 /**< Shifted mode INPUTPULL for GPIO_P_MODEL */
#define GPIO_P_MODEL_MODE4_INPUTPULLFILTER                (_GPIO_P_MODEL_MODE4_INPUTPULLFILTER << 16)           /**< Shifted mode INPUTPULLFILTER for GPIO_P_MODEL */
#define GPIO_P_MODEL_MODE4_PUSHPULL                       (_GPIO_P_MODEL_MODE4_PUSHPULL << 16)                  /**< Shifted mode PUSHPULL for GPIO_P_MODEL */
#define GPIO_P_MODEL_MODE4_PUSHPULLDRIVE                  (_GPIO_P_MODEL_MODE4_PUSHPULLDRIVE << 16)             /**< Shifted mode PUSHPULLDRIVE for GPIO_P_MODEL */
#define GPIO_P_MODEL_MODE4_WIREDOR                        (_GPIO_P_MODEL_MODE4_WIREDOR << 16)                   /**< Shifted mode WIREDOR for GPIO_P_MODEL */
#define GPIO_P_MODEL_MODE4_WIREDORPULLDOWN                (_GPIO_P_MODEL_MODE4_WIREDORPULLDOWN << 16)           /**< Shifted mode WIREDORPULLDOWN for GPIO_P_MODEL */
#define GPIO_P_MODEL_MODE4_WIREDAND                       (_GPIO_P_MODEL_MODE4_WIREDAND << 16)                  /**< Shifted mode WIREDAND for GPIO_P_MODEL */
#define GPIO_P_MODEL_MODE4_WIREDANDFILTER                 (_GPIO_P_MODEL_MODE4_WIREDANDFILTER << 16)            /**< Shifted mode WIREDANDFILTER for GPIO_P_MODEL */
#define GPIO_P_MODEL_MODE4_WIREDANDPULLUP                 (_GPIO_P_MODEL_MODE4_WIREDANDPULLUP << 16)            /**< Shifted mode WIREDANDPULLUP for GPIO_P_MODEL */
#define GPIO_P_MODEL_MODE4_WIREDANDPULLUPFILTER           (_GPIO_P_MODEL_MODE4_WIREDANDPULLUPFILTER << 16)      /**< Shifted mode WIREDANDPULLUPFILTER for GPIO_P_MODEL */
#define GPIO_P_MODEL_MODE4_WIREDANDDRIVE                  (_GPIO_P_MODEL_MODE4_WIREDANDDRIVE << 16)             /**< Shifted mode WIREDANDDRIVE for GPIO_P_MODEL */
#define GPIO_P_MODEL_MODE4_WIREDANDDRIVEFILTER            (_GPIO_P_MODEL_MODE4_WIREDANDDRIVEFILTER << 16)       /**< Shifted mode WIREDANDDRIVEFILTER for GPIO_P_MODEL */
#define GPIO_P_MODEL_MODE4_WIREDANDDRIVEPULLUP            (_GPIO_P_MODEL_MODE4_WIREDANDDRIVEPULLUP << 16)       /**< Shifted mode WIREDANDDRIVEPULLUP for GPIO_P_MODEL */
#define GPIO_P_MODEL_MODE4_WIREDANDDRIVEPULLUPFILTER      (_GPIO_P_MODEL_MODE4_WIREDANDDRIVEPULLUPFILTER << 16) /**< Shifted mode WIREDANDDRIVEPULLUPFILTER for GPIO_P_MODEL */
#define _GPIO_P_MODEL_MODE5_SHIFT                         20                                                    /**< Shift value for GPIO_MODE5 */
#define _GPIO_P_MODEL_MODE5_MASK                          0xF00000UL                                            /**< Bit mask for GPIO_MODE5 */
#define _GPIO_P_MODEL_MODE5_DEFAULT                       0x00000000UL                                          /**< Mode DEFAULT for GPIO_P_MODEL */
#define _GPIO_P_MODEL_MODE5_DISABLED                      0x00000000UL                                          /**< Mode DISABLED for GPIO_P_MODEL */
#define _GPIO_P_MODEL_MODE5_INPUT                         0x00000001UL                                          /**< Mode INPUT for GPIO_P_MODEL */
#define _GPIO_P_MODEL_MODE5_INPUTPULL                     0x00000002UL                                          /**< Mode INPUTPULL for GPIO_P_MODEL */
#define _GPIO_P_MODEL_MODE5_INPUTPULLFILTER               0x00000003UL                                          /**< Mode INPUTPULLFILTER for GPIO_P_MODEL */
#define _GPIO_P_MODEL_MODE5_PUSHPULL                      0x00000004UL                                          /**< Mode PUSHPULL for GPIO_P_MODEL */
#define _GPIO_P_MODEL_MODE5_PUSHPULLDRIVE                 0x00000005UL                                          /**< Mode PUSHPULLDRIVE for GPIO_P_MODEL */
#define _GPIO_P_MODEL_MODE5_WIREDOR                       0x00000006UL                                          /**< Mode WIREDOR for GPIO_P_MODEL */
#define _GPIO_P_MODEL_MODE5_WIREDORPULLDOWN               0x00000007UL                                          /**< Mode WIREDORPULLDOWN for GPIO_P_MODEL */
#define _GPIO_P_MODEL_MODE5_WIREDAND                      0x00000008UL                                          /**< Mode WIREDAND for GPIO_P_MODEL */
#define _GPIO_P_MODEL_MODE5_WIREDANDFILTER                0x00000009UL                                          /**< Mode WIREDANDFILTER for GPIO_P_MODEL */
#define _GPIO_P_MODEL_MODE5_WIREDANDPULLUP                0x0000000AUL                                          /**< Mode WIREDANDPULLUP for GPIO_P_MODEL */
#define _GPIO_P_MODEL_MODE5_WIREDANDPULLUPFILTER          0x0000000BUL                                          /**< Mode WIREDANDPULLUPFILTER for GPIO_P_MODEL */
#define _GPIO_P_MODEL_MODE5_WIREDANDDRIVE                 0x0000000CUL                                          /**< Mode WIREDANDDRIVE for GPIO_P_MODEL */
#define _GPIO_P_MODEL_MODE5_WIREDANDDRIVEFILTER           0x0000000DUL                                          /**< Mode WIREDANDDRIVEFILTER for GPIO_P_MODEL */
#define _GPIO_P_MODEL_MODE5_WIREDANDDRIVEPULLUP           0x0000000EUL                                          /**< Mode WIREDANDDRIVEPULLUP for GPIO_P_MODEL */
#define _GPIO_P_MODEL_MODE5_WIREDANDDRIVEPULLUPFILTER     0x0000000FUL                                          /**< Mode WIREDANDDRIVEPULLUPFILTER for GPIO_P_MODEL */
#define GPIO_P_MODEL_MODE5_DEFAULT                        (_GPIO_P_MODEL_MODE5_DEFAULT << 20)                   /**< Shifted mode DEFAULT for GPIO_P_MODEL */
#define GPIO_P_MODEL_MODE5_DISABLED                       (_GPIO_P_MODEL_MODE5_DISABLED << 20)                  /**< Shifted mode DISABLED for GPIO_P_MODEL */
#define GPIO_P_MODEL_MODE5_INPUT                          (_GPIO_P_MODEL_MODE5_INPUT << 20)                     /**< Shifted mode INPUT for GPIO_P_MODEL */
#define GPIO_P_MODEL_MODE5_INPUTPULL                      (_GPIO_P_MODEL_MODE5_INPUTPULL << 20)                 /**< Shifted mode INPUTPULL for GPIO_P_MODEL */
#define GPIO_P_MODEL_MODE5_INPUTPULLFILTER                (_GPIO_P_MODEL_MODE5_INPUTPULLFILTER << 20)           /**< Shifted mode INPUTPULLFILTER for GPIO_P_MODEL */
#define GPIO_P_MODEL_MODE5_PUSHPULL                       (_GPIO_P_MODEL_MODE5_PUSHPULL << 20)                  /**< Shifted mode PUSHPULL for GPIO_P_MODEL */
#define GPIO_P_MODEL_MODE5_PUSHPULLDRIVE                  (_GPIO_P_MODEL_MODE5_PUSHPULLDRIVE << 20)             /**< Shifted mode PUSHPULLDRIVE for GPIO_P_MODEL */
#define GPIO_P_MODEL_MODE5_WIREDOR                        (_GPIO_P_MODEL_MODE5_WIREDOR << 20)                   /**< Shifted mode WIREDOR for GPIO_P_MODEL */
#define GPIO_P_MODEL_MODE5_WIREDORPULLDOWN                (_GPIO_P_MODEL_MODE5_WIREDORPULLDOWN << 20)           /**< Shifted mode WIREDORPULLDOWN for GPIO_P_MODEL */
#define GPIO_P_MODEL_MODE5_WIREDAND                       (_GPIO_P_MODEL_MODE5_WIREDAND << 20)                  /**< Shifted mode WIREDAND for GPIO_P_MODEL */
#define GPIO_P_MODEL_MODE5_WIREDANDFILTER                 (_GPIO_P_MODEL_MODE5_WIREDANDFILTER << 20)            /**< Shifted mode WIREDANDFILTER for GPIO_P_MODEL */
#define GPIO_P_MODEL_MODE5_WIREDANDPULLUP                 (_GPIO_P_MODEL_MODE5_WIREDANDPULLUP << 20)            /**< Shifted mode WIREDANDPULLUP for GPIO_P_MODEL */
#define GPIO_P_MODEL_MODE5_WIREDANDPULLUPFILTER           (_GPIO_P_MODEL_MODE5_WIREDANDPULLUPFILTER << 20)      /**< Shifted mode WIREDANDPULLUPFILTER for GPIO_P_MODEL */
#define GPIO_P_MODEL_MODE5_WIREDANDDRIVE                  (_GPIO_P_MODEL_MODE5_WIREDANDDRIVE << 20)             /**< Shifted mode WIREDANDDRIVE for GPIO_P_MODEL */
#define GPIO_P_MODEL_MODE5_WIREDANDDRIVEFILTER            (_GPIO_P_MODEL_MODE5_WIREDANDDRIVEFILTER << 20)       /**< Shifted mode WIREDANDDRIVEFILTER for GPIO_P_MODEL */
#define GPIO_P_MODEL_MODE5_WIREDANDDRIVEPULLUP            (_GPIO_P_MODEL_MODE5_WIREDANDDRIVEPULLUP << 20)       /**< Shifted mode WIREDANDDRIVEPULLUP for GPIO_P_MODEL */
#define GPIO_P_MODEL_MODE5_WIREDANDDRIVEPULLUPFILTER      (_GPIO_P_MODEL_MODE5_WIREDANDDRIVEPULLUPFILTER << 20) /**< Shifted mode WIREDANDDRIVEPULLUPFILTER for GPIO_P_MODEL */
#define _GPIO_P_MODEL_MODE6_SHIFT                         24                                                    /**< Shift value for GPIO_MODE6 */
#define _GPIO_P_MODEL_MODE6_MASK                          0xF000000UL                                           /**< Bit mask for GPIO_MODE6 */
#define _GPIO_P_MODEL_MODE6_DEFAULT                       0x00000000UL                                          /**< Mode DEFAULT for GPIO_P_MODEL */
#define _GPIO_P_MODEL_MODE6_DISABLED                      0x00000000UL                                          /**< Mode DISABLED for GPIO_P_MODEL */
#define _GPIO_P_MODEL_MODE6_INPUT                         0x00000001UL                                          /**< Mode INPUT for GPIO_P_MODEL */
#define _GPIO_P_MODEL_MODE6_INPUTPULL                     0x00000002UL                                          /**< Mode INPUTPULL for GPIO_P_MODEL */
#define _GPIO_P_MODEL_MODE6_INPUTPULLFILTER               0x00000003UL                                          /**< Mode INPUTPULLFILTER for GPIO_P_MODEL */
#define _GPIO_P_MODEL_MODE6_PUSHPULL                      0x00000004UL                                          /**< Mode PUSHPULL for GPIO_P_MODEL */
#define _GPIO_P_MODEL_MODE6_PUSHPULLDRIVE                 0x00000005UL                                          /**< Mode PUSHPULLDRIVE for GPIO_P_MODEL */
#define _GPIO_P_MODEL_MODE6_WIREDOR                       0x00000006UL                                          /**< Mode WIREDOR for GPIO_P_MODEL */
#define _GPIO_P_MODEL_MODE6_WIREDORPULLDOWN               0x00000007UL                                          /**< Mode WIREDORPULLDOWN for GPIO_P_MODEL */
#define _GPIO_P_MODEL_MODE6_WIREDAND                      0x00000008UL                                          /**< Mode WIREDAND for GPIO_P_MODEL */
#define _GPIO_P_MODEL_MODE6_WIREDANDFILTER                0x00000009UL                                          /**< Mode WIREDANDFILTER for GPIO_P_MODEL */
#define _GPIO_P_MODEL_MODE6_WIREDANDPULLUP                0x0000000AUL                                          /**< Mode WIREDANDPULLUP for GPIO_P_MODEL */
#define _GPIO_P_MODEL_MODE6_WIREDANDPULLUPFILTER          0x0000000BUL                                          /**< Mode WIREDANDPULLUPFILTER for GPIO_P_MODEL */
#define _GPIO_P_MODEL_MODE6_WIREDANDDRIVE                 0x0000000CUL                                          /**< Mode WIREDANDDRIVE for GPIO_P_MODEL */
#define _GPIO_P_MODEL_MODE6_WIREDANDDRIVEFILTER           0x0000000DUL                                          /**< Mode WIREDANDDRIVEFILTER for GPIO_P_MODEL */
#define _GPIO_P_MODEL_MODE6_WIREDANDDRIVEPULLUP           0x0000000EUL                                          /**< Mode WIREDANDDRIVEPULLUP for GPIO_P_MODEL */
#define _GPIO_P_MODEL_MODE6_WIREDANDDRIVEPULLUPFILTER     0x0000000FUL                                          /**< Mode WIREDANDDRIVEPULLUPFILTER for GPIO_P_MODEL */
#define GPIO_P_MODEL_MODE6_DEFAULT                        (_GPIO_P_MODEL_MODE6_DEFAULT << 24)                   /**< Shifted mode DEFAULT for GPIO_P_MODEL */
#define GPIO_P_MODEL_MODE6_DISABLED                       (_GPIO_P_MODEL_MODE6_DISABLED << 24)                  /**< Shifted mode DISABLED for GPIO_P_MODEL */
#define GPIO_P_MODEL_MODE6_INPUT                          (_GPIO_P_MODEL_MODE6_INPUT << 24)                     /**< Shifted mode INPUT for GPIO_P_MODEL */
#define GPIO_P_MODEL_MODE6_INPUTPULL                      (_GPIO_P_MODEL_MODE6_INPUTPULL << 24)                 /**< Shifted mode INPUTPULL for GPIO_P_MODEL */
#define GPIO_P_MODEL_MODE6_INPUTPULLFILTER                (_GPIO_P_MODEL_MODE6_INPUTPULLFILTER << 24)           /**< Shifted mode INPUTPULLFILTER for GPIO_P_MODEL */
#define GPIO_P_MODEL_MODE6_PUSHPULL                       (_GPIO_P_MODEL_MODE6_PUSHPULL << 24)                  /**< Shifted mode PUSHPULL for GPIO_P_MODEL */
#define GPIO_P_MODEL_MODE6_PUSHPULLDRIVE                  (_GPIO_P_MODEL_MODE6_PUSHPULLDRIVE << 24)             /**< Shifted mode PUSHPULLDRIVE for GPIO_P_MODEL */
#define GPIO_P_MODEL_MODE6_WIREDOR                        (_GPIO_P_MODEL_MODE6_WIREDOR << 24)                   /**< Shifted mode WIREDOR for GPIO_P_MODEL */
#define GPIO_P_MODEL_MODE6_WIREDORPULLDOWN                (_GPIO_P_MODEL_MODE6_WIREDORPULLDOWN << 24)           /**< Shifted mode WIREDORPULLDOWN for GPIO_P_MODEL */
#define GPIO_P_MODEL_MODE6_WIREDAND                       (_GPIO_P_MODEL_MODE6_WIREDAND << 24)                  /**< Shifted mode WIREDAND for GPIO_P_MODEL */
#define GPIO_P_MODEL_MODE6_WIREDANDFILTER                 (_GPIO_P_MODEL_MODE6_WIREDANDFILTER << 24)            /**< Shifted mode WIREDANDFILTER for GPIO_P_MODEL */
#define GPIO_P_MODEL_MODE6_WIREDANDPULLUP                 (_GPIO_P_MODEL_MODE6_WIREDANDPULLUP << 24)            /**< Shifted mode WIREDANDPULLUP for GPIO_P_MODEL */
#define GPIO_P_MODEL_MODE6_WIREDANDPULLUPFILTER           (_GPIO_P_MODEL_MODE6_WIREDANDPULLUPFILTER << 24)      /**< Shifted mode WIREDANDPULLUPFILTER for GPIO_P_MODEL */
#define GPIO_P_MODEL_MODE6_WIREDANDDRIVE                  (_GPIO_P_MODEL_MODE6_WIREDANDDRIVE << 24)             /**< Shifted mode WIREDANDDRIVE for GPIO_P_MODEL */
#define GPIO_P_MODEL_MODE6_WIREDANDDRIVEFILTER            (_GPIO_P_MODEL_MODE6_WIREDANDDRIVEFILTER << 24)       /**< Shifted mode WIREDANDDRIVEFILTER for GPIO_P_MODEL */
#define GPIO_P_MODEL_MODE6_WIREDANDDRIVEPULLUP            (_GPIO_P_MODEL_MODE6_WIREDANDDRIVEPULLUP << 24)       /**< Shifted mode WIREDANDDRIVEPULLUP for GPIO_P_MODEL */
#define GPIO_P_MODEL_MODE6_WIREDANDDRIVEPULLUPFILTER      (_GPIO_P_MODEL_MODE6_WIREDANDDRIVEPULLUPFILTER << 24) /**< Shifted mode WIREDANDDRIVEPULLUPFILTER for GPIO_P_MODEL */
#define _GPIO_P_MODEL_MODE7_SHIFT                         28                                                    /**< Shift value for GPIO_MODE7 */
#define _GPIO_P_MODEL_MODE7_MASK                          0xF0000000UL                                          /**< Bit mask for GPIO_MODE7 */
#define _GPIO_P_MODEL_MODE7_DEFAULT                       0x00000000UL                                          /**< Mode DEFAULT for GPIO_P_MODEL */
#define _GPIO_P_MODEL_MODE7_DISABLED                      0x00000000UL                                          /**< Mode DISABLED for GPIO_P_MODEL */
#define _GPIO_P_MODEL_MODE7_INPUT                         0x00000001UL                                          /**< Mode INPUT for GPIO_P_MODEL */
#define _GPIO_P_MODEL_MODE7_INPUTPULL                     0x00000002UL                                          /**< Mode INPUTPULL for GPIO_P_MODEL */
#define _GPIO_P_MODEL_MODE7_INPUTPULLFILTER               0x00000003UL                                          /**< Mode INPUTPULLFILTER for GPIO_P_MODEL */
#define _GPIO_P_MODEL_MODE7_PUSHPULL                      0x00000004UL                                          /**< Mode PUSHPULL for GPIO_P_MODEL */
#define _GPIO_P_MODEL_MODE7_PUSHPULLDRIVE                 0x00000005UL                                          /**< Mode PUSHPULLDRIVE for GPIO_P_MODEL */
#define _GPIO_P_MODEL_MODE7_WIREDOR                       0x00000006UL                                          /**< Mode WIREDOR for GPIO_P_MODEL */
#define _GPIO_P_MODEL_MODE7_WIREDORPULLDOWN               0x00000007UL                                          /**< Mode WIREDORPULLDOWN for GPIO_P_MODEL */
#define _GPIO_P_MODEL_MODE7_WIREDAND                      0x00000008UL                                          /**< Mode WIREDAND for GPIO_P_MODEL */
#define _GPIO_P_MODEL_MODE7_WIREDANDFILTER                0x00000009UL                                          /**< Mode WIREDANDFILTER for GPIO_P_MODEL */
#define _GPIO_P_MODEL_MODE7_WIREDANDPULLUP                0x0000000AUL                                          /**< Mode WIREDANDPULLUP for GPIO_P_MODEL */
#define _GPIO_P_MODEL_MODE7_WIREDANDPULLUPFILTER          0x0000000BUL                                          /**< Mode WIREDANDPULLUPFILTER for GPIO_P_MODEL */
#define _GPIO_P_MODEL_MODE7_WIREDANDDRIVE                 0x0000000CUL                                          /**< Mode WIREDANDDRIVE for GPIO_P_MODEL */
#define _GPIO_P_MODEL_MODE7_WIREDANDDRIVEFILTER           0x0000000DUL                                          /**< Mode WIREDANDDRIVEFILTER for GPIO_P_MODEL */
#define _GPIO_P_MODEL_MODE7_WIREDANDDRIVEPULLUP           0x0000000EUL                                          /**< Mode WIREDANDDRIVEPULLUP for GPIO_P_MODEL */
#define _GPIO_P_MODEL_MODE7_WIREDANDDRIVEPULLUPFILTER     0x0000000FUL                                          /**< Mode WIREDANDDRIVEPULLUPFILTER for GPIO_P_MODEL */
#define GPIO_P_MODEL_MODE7_DEFAULT                        (_GPIO_P_MODEL_MODE7_DEFAULT << 28)                   /**< Shifted mode DEFAULT for GPIO_P_MODEL */
#define GPIO_P_MODEL_MODE7_DISABLED                       (_GPIO_P_MODEL_MODE7_DISABLED << 28)                  /**< Shifted mode DISABLED for GPIO_P_MODEL */
#define GPIO_P_MODEL_MODE7_INPUT                          (_GPIO_P_MODEL_MODE7_INPUT << 28)                     /**< Shifted mode INPUT for GPIO_P_MODEL */
#define GPIO_P_MODEL_MODE7_INPUTPULL                      (_GPIO_P_MODEL_MODE7_INPUTPULL << 28)                 /**< Shifted mode INPUTPULL for GPIO_P_MODEL */
#define GPIO_P_MODEL_MODE7_INPUTPULLFILTER                (_GPIO_P_MODEL_MODE7_INPUTPULLFILTER << 28)           /**< Shifted mode INPUTPULLFILTER for GPIO_P_MODEL */
#define GPIO_P_MODEL_MODE7_PUSHPULL                       (_GPIO_P_MODEL_MODE7_PUSHPULL << 28)                  /**< Shifted mode PUSHPULL for GPIO_P_MODEL */
#define GPIO_P_MODEL_MODE7_PUSHPULLDRIVE                  (_GPIO_P_MODEL_MODE7_PUSHPULLDRIVE << 28)             /**< Shifted mode PUSHPULLDRIVE for GPIO_P_MODEL */
#define GPIO_P_MODEL_MODE7_WIREDOR                        (_GPIO_P_MODEL_MODE7_WIREDOR << 28)                   /**< Shifted mode WIREDOR for GPIO_P_MODEL */
#define GPIO_P_MODEL_MODE7_WIREDORPULLDOWN                (_GPIO_P_MODEL_MODE7_WIREDORPULLDOWN << 28)           /**< Shifted mode WIREDORPULLDOWN for GPIO_P_MODEL */
#define GPIO_P_MODEL_MODE7_WIREDAND                       (_GPIO_P_MODEL_MODE7_WIREDAND << 28)                  /**< Shifted mode WIREDAND for GPIO_P_MODEL */
#define GPIO_P_MODEL_MODE7_WIREDANDFILTER                 (_GPIO_P_MODEL_MODE7_WIREDANDFILTER << 28)            /**< Shifted mode WIREDANDFILTER for GPIO_P_MODEL */
#define GPIO_P_MODEL_MODE7_WIREDANDPULLUP                 (_GPIO_P_MODEL_MODE7_WIREDANDPULLUP << 28)            /**< Shifted mode WIREDANDPULLUP for GPIO_P_MODEL */
#define GPIO_P_MODEL_MODE7_WIREDANDPULLUPFILTER           (_GPIO_P_MODEL_MODE7_WIREDANDPULLUPFILTER << 28)      /**< Shifted mode WIREDANDPULLUPFILTER for GPIO_P_MODEL */
#define GPIO_P_MODEL_MODE7_WIREDANDDRIVE                  (_GPIO_P_MODEL_MODE7_WIREDANDDRIVE << 28)             /**< Shifted mode WIREDANDDRIVE for GPIO_P_MODEL */
#define GPIO_P_MODEL_MODE7_WIREDANDDRIVEFILTER            (_GPIO_P_MODEL_MODE7_WIREDANDDRIVEFILTER << 28)       /**< Shifted mode WIREDANDDRIVEFILTER for GPIO_P_MODEL */
#define GPIO_P_MODEL_MODE7_WIREDANDDRIVEPULLUP            (_GPIO_P_MODEL_MODE7_WIREDANDDRIVEPULLUP << 28)       /**< Shifted mode WIREDANDDRIVEPULLUP for GPIO_P_MODEL */
#define GPIO_P_MODEL_MODE7_WIREDANDDRIVEPULLUPFILTER      (_GPIO_P_MODEL_MODE7_WIREDANDDRIVEPULLUPFILTER << 28) /**< Shifted mode WIREDANDDRIVEPULLUPFILTER for GPIO_P_MODEL */

/* Bit fields for GPIO P_MODEH */
#define _GPIO_P_MODEH_RESETVALUE                          0x00000000UL                                           /**< Default value for GPIO_P_MODEH */
#define _GPIO_P_MODEH_MASK                                0xFFFFFFFFUL                                           /**< Mask for GPIO_P_MODEH */
#define _GPIO_P_MODEH_MODE8_SHIFT                         0                                                      /**< Shift value for GPIO_MODE8 */
#define _GPIO_P_MODEH_MODE8_MASK                          0xFUL                                                  /**< Bit mask for GPIO_MODE8 */
#define _GPIO_P_MODEH_MODE8_DEFAULT                       0x00000000UL                                           /**< Mode DEFAULT for GPIO_P_MODEH */
#define _GPIO_P_MODEH_MODE8_DISABLED                      0x00000000UL                                           /**< Mode DISABLED for GPIO_P_MODEH */
#define _GPIO_P_MODEH_MODE8_INPUT                         0x00000001UL                                           /**< Mode INPUT for GPIO_P_MODEH */
#define _GPIO_P_MODEH_MODE8_INPUTPULL                     0x00000002UL                                           /**< Mode INPUTPULL for GPIO_P_MODEH */
#define _GPIO_P_MODEH_MODE8_INPUTPULLFILTER               0x00000003UL                                           /**< Mode INPUTPULLFILTER for GPIO_P_MODEH */
#define _GPIO_P_MODEH_MODE8_PUSHPULL                      0x00000004UL                                           /**< Mode PUSHPULL for GPIO_P_MODEH */
#define _GPIO_P_MODEH_MODE8_PUSHPULLDRIVE                 0x00000005UL                                           /**< Mode PUSHPULLDRIVE for GPIO_P_MODEH */
#define _GPIO_P_MODEH_MODE8_WIREDOR                       0x00000006UL                                           /**< Mode WIREDOR for GPIO_P_MODEH */
#define _GPIO_P_MODEH_MODE8_WIREDORPULLDOWN               0x00000007UL                                           /**< Mode WIREDORPULLDOWN for GPIO_P_MODEH */
#define _GPIO_P_MODEH_MODE8_WIREDAND                      0x00000008UL                                           /**< Mode WIREDAND for GPIO_P_MODEH */
#define _GPIO_P_MODEH_MODE8_WIREDANDFILTER                0x00000009UL                                           /**< Mode WIREDANDFILTER for GPIO_P_MODEH */
#define _GPIO_P_MODEH_MODE8_WIREDANDPULLUP                0x0000000AUL                                           /**< Mode WIREDANDPULLUP for GPIO_P_MODEH */
#define _GPIO_P_MODEH_MODE8_WIREDANDPULLUPFILTER          0x0000000BUL                                           /**< Mode WIREDANDPULLUPFILTER for GPIO_P_MODEH */
#define _GPIO_P_MODEH_MODE8_WIREDANDDRIVE                 0x0000000CUL                                           /**< Mode WIREDANDDRIVE for GPIO_P_MODEH */
#define _GPIO_P_MODEH_MODE8_WIREDANDDRIVEFILTER           0x0000000DUL                                           /**< Mode WIREDANDDRIVEFILTER for GPIO_P_MODEH */
#define _GPIO_P_MODEH_MODE8_WIREDANDDRIVEPULLUP           0x0000000EUL                                           /**< Mode WIREDANDDRIVEPULLUP for GPIO_P_MODEH */
#define _GPIO_P_MODEH_MODE8_WIREDANDDRIVEPULLUPFILTER     0x0000000FUL                                           /**< Mode WIREDANDDRIVEPULLUPFILTER for GPIO_P_MODEH */
#define GPIO_P_MODEH_MODE8_DEFAULT                        (_GPIO_P_MODEH_MODE8_DEFAULT << 0)                     /**< Shifted mode DEFAULT for GPIO_P_MODEH */
#define GPIO_P_MODEH_MODE8_DISABLED                       (_GPIO_P_MODEH_MODE8_DISABLED << 0)                    /**< Shifted mode DISABLED for GPIO_P_MODEH */
#define GPIO_P_MODEH_MODE8_INPUT                          (_GPIO_P_MODEH_MODE8_INPUT << 0)                       /**< Shifted mode INPUT for GPIO_P_MODEH */
#define GPIO_P_MODEH_MODE8_INPUTPULL                      (_GPIO_P_MODEH_MODE8_INPUTPULL << 0)                   /**< Shifted mode INPUTPULL for GPIO_P_MODEH */
#define GPIO_P_MODEH_MODE8_INPUTPULLFILTER                (_GPIO_P_MODEH_MODE8_INPUTPULLFILTER << 0)             /**< Shifted mode INPUTPULLFILTER for GPIO_P_MODEH */
#define GPIO_P_MODEH_MODE8_PUSHPULL                       (_GPIO_P_MODEH_MODE8_PUSHPULL << 0)                    /**< Shifted mode PUSHPULL for GPIO_P_MODEH */
#define GPIO_P_MODEH_MODE8_PUSHPULLDRIVE                  (_GPIO_P_MODEH_MODE8_PUSHPULLDRIVE << 0)               /**< Shifted mode PUSHPULLDRIVE for GPIO_P_MODEH */
#define GPIO_P_MODEH_MODE8_WIREDOR                        (_GPIO_P_MODEH_MODE8_WIREDOR << 0)                     /**< Shifted mode WIREDOR for GPIO_P_MODEH */
#define GPIO_P_MODEH_MODE8_WIREDORPULLDOWN                (_GPIO_P_MODEH_MODE8_WIREDORPULLDOWN << 0)             /**< Shifted mode WIREDORPULLDOWN for GPIO_P_MODEH */
#define GPIO_P_MODEH_MODE8_WIREDAND                       (_GPIO_P_MODEH_MODE8_WIREDAND << 0)                    /**< Shifted mode WIREDAND for GPIO_P_MODEH */
#define GPIO_P_MODEH_MODE8_WIREDANDFILTER                 (_GPIO_P_MODEH_MODE8_WIREDANDFILTER << 0)              /**< Shifted mode WIREDANDFILTER for GPIO_P_MODEH */
#define GPIO_P_MODEH_MODE8_WIREDANDPULLUP                 (_GPIO_P_MODEH_MODE8_WIREDANDPULLUP << 0)              /**< Shifted mode WIREDANDPULLUP for GPIO_P_MODEH */
#define GPIO_P_MODEH_MODE8_WIREDANDPULLUPFILTER           (_GPIO_P_MODEH_MODE8_WIREDANDPULLUPFILTER << 0)        /**< Shifted mode WIREDANDPULLUPFILTER for GPIO_P_MODEH */
#define GPIO_P_MODEH_MODE8_WIREDANDDRIVE                  (_GPIO_P_MODEH_MODE8_WIREDANDDRIVE << 0)               /**< Shifted mode WIREDANDDRIVE for GPIO_P_MODEH */
#define GPIO_P_MODEH_MODE8_WIREDANDDRIVEFILTER            (_GPIO_P_MODEH_MODE8_WIREDANDDRIVEFILTER << 0)         /**< Shifted mode WIREDANDDRIVEFILTER for GPIO_P_MODEH */
#define GPIO_P_MODEH_MODE8_WIREDANDDRIVEPULLUP            (_GPIO_P_MODEH_MODE8_WIREDANDDRIVEPULLUP << 0)         /**< Shifted mode WIREDANDDRIVEPULLUP for GPIO_P_MODEH */
#define GPIO_P_MODEH_MODE8_WIREDANDDRIVEPULLUPFILTER      (_GPIO_P_MODEH_MODE8_WIREDANDDRIVEPULLUPFILTER << 0)   /**< Shifted mode WIREDANDDRIVEPULLUPFILTER for GPIO_P_MODEH */
#define _GPIO_P_MODEH_MODE9_SHIFT                         4                                                      /**< Shift value for GPIO_MODE9 */
#define _GPIO_P_MODEH_MODE9_MASK                          0xF0UL                                                 /**< Bit mask for GPIO_MODE9 */
#define _GPIO_P_MODEH_MODE9_DEFAULT                       0x00000000UL                                           /**< Mode DEFAULT for GPIO_P_MODEH */
#define _GPIO_P_MODEH_MODE9_DISABLED                      0x00000000UL                                           /**< Mode DISABLED for GPIO_P_MODEH */
#define _GPIO_P_MODEH_MODE9_INPUT                         0x00000001UL                                           /**< Mode INPUT for GPIO_P_MODEH */
#define _GPIO_P_MODEH_MODE9_INPUTPULL                     0x00000002UL                                           /**< Mode INPUTPULL for GPIO_P_MODEH */
#define _GPIO_P_MODEH_MODE9_INPUTPULLFILTER               0x00000003UL                                           /**< Mode INPUTPULLFILTER for GPIO_P_MODEH */
#define _GPIO_P_MODEH_MODE9_PUSHPULL                      0x00000004UL                                           /**< Mode PUSHPULL for GPIO_P_MODEH */
#define _GPIO_P_MODEH_MODE9_PUSHPULLDRIVE                 0x00000005UL                                           /**< Mode PUSHPULLDRIVE for GPIO_P_MODEH */
#define _GPIO_P_MODEH_MODE9_WIREDOR                       0x00000006UL                                           /**< Mode WIREDOR for GPIO_P_MODEH */
#define _GPIO_P_MODEH_MODE9_WIREDORPULLDOWN               0x00000007UL                                           /**< Mode WIREDORPULLDOWN for GPIO_P_MODEH */
#define _GPIO_P_MODEH_MODE9_WIREDAND                      0x00000008UL                                           /**< Mode WIREDAND for GPIO_P_MODEH */
#define _GPIO_P_MODEH_MODE9_WIREDANDFILTER                0x00000009UL                                           /**< Mode WIREDANDFILTER for GPIO_P_MODEH */
#define _GPIO_P_MODEH_MODE9_WIREDANDPULLUP                0x0000000AUL                                           /**< Mode WIREDANDPULLUP for GPIO_P_MODEH */
#define _GPIO_P_MODEH_MODE9_WIREDANDPULLUPFILTER          0x0000000BUL                                           /**< Mode WIREDANDPULLUPFILTER for GPIO_P_MODEH */
#define _GPIO_P_MODEH_MODE9_WIREDANDDRIVE                 0x0000000CUL                                           /**< Mode WIREDANDDRIVE for GPIO_P_MODEH */
#define _GPIO_P_MODEH_MODE9_WIREDANDDRIVEFILTER           0x0000000DUL                                           /**< Mode WIREDANDDRIVEFILTER for GPIO_P_MODEH */
#define _GPIO_P_MODEH_MODE9_WIREDANDDRIVEPULLUP           0x0000000EUL                                           /**< Mode WIREDANDDRIVEPULLUP for GPIO_P_MODEH */
#define _GPIO_P_MODEH_MODE9_WIREDANDDRIVEPULLUPFILTER     0x0000000FUL                                           /**< Mode WIREDANDDRIVEPULLUPFILTER for GPIO_P_MODEH */
#define GPIO_P_MODEH_MODE9_DEFAULT                        (_GPIO_P_MODEH_MODE9_DEFAULT << 4)                     /**< Shifted mode DEFAULT for GPIO_P_MODEH */
#define GPIO_P_MODEH_MODE9_DISABLED                       (_GPIO_P_MODEH_MODE9_DISABLED << 4)                    /**< Shifted mode DISABLED for GPIO_P_MODEH */
#define GPIO_P_MODEH_MODE9_INPUT                          (_GPIO_P_MODEH_MODE9_INPUT << 4)                       /**< Shifted mode INPUT for GPIO_P_MODEH */
#define GPIO_P_MODEH_MODE9_INPUTPULL                      (_GPIO_P_MODEH_MODE9_INPUTPULL << 4)                   /**< Shifted mode INPUTPULL for GPIO_P_MODEH */
#define GPIO_P_MODEH_MODE9_INPUTPULLFILTER                (_GPIO_P_MODEH_MODE9_INPUTPULLFILTER << 4)             /**< Shifted mode INPUTPULLFILTER for GPIO_P_MODEH */
#define GPIO_P_MODEH_MODE9_PUSHPULL                       (_GPIO_P_MODEH_MODE9_PUSHPULL << 4)                    /**< Shifted mode PUSHPULL for GPIO_P_MODEH */
#define GPIO_P_MODEH_MODE9_PUSHPULLDRIVE                  (_GPIO_P_MODEH_MODE9_PUSHPULLDRIVE << 4)               /**< Shifted mode PUSHPULLDRIVE for GPIO_P_MODEH */
#define GPIO_P_MODEH_MODE9_WIREDOR                        (_GPIO_P_MODEH_MODE9_WIREDOR << 4)                     /**< Shifted mode WIREDOR for GPIO_P_MODEH */
#define GPIO_P_MODEH_MODE9_WIREDORPULLDOWN                (_GPIO_P_MODEH_MODE9_WIREDORPULLDOWN << 4)             /**< Shifted mode WIREDORPULLDOWN for GPIO_P_MODEH */
#define GPIO_P_MODEH_MODE9_WIREDAND                       (_GPIO_P_MODEH_MODE9_WIREDAND << 4)                    /**< Shifted mode WIREDAND for GPIO_P_MODEH */
#define GPIO_P_MODEH_MODE9_WIREDANDFILTER                 (_GPIO_P_MODEH_MODE9_WIREDANDFILTER << 4)              /**< Shifted mode WIREDANDFILTER for GPIO_P_MODEH */
#define GPIO_P_MODEH_MODE9_WIREDANDPULLUP                 (_GPIO_P_MODEH_MODE9_WIREDANDPULLUP << 4)              /**< Shifted mode WIREDANDPULLUP for GPIO_P_MODEH */
#define GPIO_P_MODEH_MODE9_WIREDANDPULLUPFILTER           (_GPIO_P_MODEH_MODE9_WIREDANDPULLUPFILTER << 4)        /**< Shifted mode WIREDANDPULLUPFILTER for GPIO_P_MODEH */
#define GPIO_P_MODEH_MODE9_WIREDANDDRIVE                  (_GPIO_P_MODEH_MODE9_WIREDANDDRIVE << 4)               /**< Shifted mode WIREDANDDRIVE for GPIO_P_MODEH */
#define GPIO_P_MODEH_MODE9_WIREDANDDRIVEFILTER            (_GPIO_P_MODEH_MODE9_WIREDANDDRIVEFILTER << 4)         /**< Shifted mode WIREDANDDRIVEFILTER for GPIO_P_MODEH */
#define GPIO_P_MODEH_MODE9_WIREDANDDRIVEPULLUP            (_GPIO_P_MODEH_MODE9_WIREDANDDRIVEPULLUP << 4)         /**< Shifted mode WIREDANDDRIVEPULLUP for GPIO_P_MODEH */
#define GPIO_P_MODEH_MODE9_WIREDANDDRIVEPULLUPFILTER      (_GPIO_P_MODEH_MODE9_WIREDANDDRIVEPULLUPFILTER << 4)   /**< Shifted mode WIREDANDDRIVEPULLUPFILTER for GPIO_P_MODEH */
#define _GPIO_P_MODEH_MODE10_SHIFT                        8                                                      /**< Shift value for GPIO_MODE10 */
#define _GPIO_P_MODEH_MODE10_MASK                         0xF00UL                                                /**< Bit mask for GPIO_MODE10 */
#define _GPIO_P_MODEH_MODE10_DEFAULT                      0x00000000UL                                           /**< Mode DEFAULT for GPIO_P_MODEH */
#define _GPIO_P_MODEH_MODE10_DISABLED                     0x00000000UL                                           /**< Mode DISABLED for GPIO_P_MODEH */
#define _GPIO_P_MODEH_MODE10_INPUT                        0x00000001UL                                           /**< Mode INPUT for GPIO_P_MODEH */
#define _GPIO_P_MODEH_MODE10_INPUTPULL                    0x00000002UL                                           /**< Mode INPUTPULL for GPIO_P_MODEH */
#define _GPIO_P_MODEH_MODE10_INPUTPULLFILTER              0x00000003UL                                           /**< Mode INPUTPULLFILTER for GPIO_P_MODEH */
#define _GPIO_P_MODEH_MODE10_PUSHPULL                     0x00000004UL                                           /**< Mode PUSHPULL for GPIO_P_MODEH */
#define _GPIO_P_MODEH_MODE10_PUSHPULLDRIVE                0x00000005UL                                           /**< Mode PUSHPULLDRIVE for GPIO_P_MODEH */
#define _GPIO_P_MODEH_MODE10_WIREDOR                      0x00000006UL                                           /**< Mode WIREDOR for GPIO_P_MODEH */
#define _GPIO_P_MODEH_MODE10_WIREDORPULLDOWN              0x00000007UL                                           /**< Mode WIREDORPULLDOWN for GPIO_P_MODEH */
#define _GPIO_P_MODEH_MODE10_WIREDAND                     0x00000008UL                                           /**< Mode WIREDAND for GPIO_P_MODEH */
#define _GPIO_P_MODEH_MODE10_WIREDANDFILTER               0x00000009UL                                           /**< Mode WIREDANDFILTER for GPIO_P_MODEH */
#define _GPIO_P_MODEH_MODE10_WIREDANDPULLUP               0x0000000AUL                                           /**< Mode WIREDANDPULLUP for GPIO_P_MODEH */
#define _GPIO_P_MODEH_MODE10_WIREDANDPULLUPFILTER         0x0000000BUL                                           /**< Mode WIREDANDPULLUPFILTER for GPIO_P_MODEH */
#define _GPIO_P_MODEH_MODE10_WIREDANDDRIVE                0x0000000CUL                                           /**< Mode WIREDANDDRIVE for GPIO_P_MODEH */
#define _GPIO_P_MODEH_MODE10_WIREDANDDRIVEFILTER          0x0000000DUL                                           /**< Mode WIREDANDDRIVEFILTER for GPIO_P_MODEH */
#define _GPIO_P_MODEH_MODE10_WIREDANDDRIVEPULLUP          0x0000000EUL                                           /**< Mode WIREDANDDRIVEPULLUP for GPIO_P_MODEH */
#define _GPIO_P_MODEH_MODE10_WIREDANDDRIVEPULLUPFILTER    0x0000000FUL                                           /**< Mode WIREDANDDRIVEPULLUPFILTER for GPIO_P_MODEH */
#define GPIO_P_MODEH_MODE10_DEFAULT                       (_GPIO_P_MODEH_MODE10_DEFAULT << 8)                    /**< Shifted mode DEFAULT for GPIO_P_MODEH */
#define GPIO_P_MODEH_MODE10_DISABLED                      (_GPIO_P_MODEH_MODE10_DISABLED << 8)                   /**< Shifted mode DISABLED for GPIO_P_MODEH */
#define GPIO_P_MODEH_MODE10_INPUT                         (_GPIO_P_MODEH_MODE10_INPUT << 8)                      /**< Shifted mode INPUT for GPIO_P_MODEH */
#define GPIO_P_MODEH_MODE10_INPUTPULL                     (_GPIO_P_MODEH_MODE10_INPUTPULL << 8)                  /**< Shifted mode INPUTPULL for GPIO_P_MODEH */
#define GPIO_P_MODEH_MODE10_INPUTPULLFILTER               (_GPIO_P_MODEH_MODE10_INPUTPULLFILTER << 8)            /**< Shifted mode INPUTPULLFILTER for GPIO_P_MODEH */
#define GPIO_P_MODEH_MODE10_PUSHPULL                      (_GPIO_P_MODEH_MODE10_PUSHPULL << 8)                   /**< Shifted mode PUSHPULL for GPIO_P_MODEH */
#define GPIO_P_MODEH_MODE10_PUSHPULLDRIVE                 (_GPIO_P_MODEH_MODE10_PUSHPULLDRIVE << 8)              /**< Shifted mode PUSHPULLDRIVE for GPIO_P_MODEH */
#define GPIO_P_MODEH_MODE10_WIREDOR                       (_GPIO_P_MODEH_MODE10_WIREDOR << 8)                    /**< Shifted mode WIREDOR for GPIO_P_MODEH */
#define GPIO_P_MODEH_MODE10_WIREDORPULLDOWN               (_GPIO_P_MODEH_MODE10_WIREDORPULLDOWN << 8)            /**< Shifted mode WIREDORPULLDOWN for GPIO_P_MODEH */
#define GPIO_P_MODEH_MODE10_WIREDAND                      (_GPIO_P_MODEH_MODE10_WIREDAND << 8)                   /**< Shifted mode WIREDAND for GPIO_P_MODEH */
#define GPIO_P_MODEH_MODE10_WIREDANDFILTER                (_GPIO_P_MODEH_MODE10_WIREDANDFILTER << 8)             /**< Shifted mode WIREDANDFILTER for GPIO_P_MODEH */
#define GPIO_P_MODEH_MODE10_WIREDANDPULLUP                (_GPIO_P_MODEH_MODE10_WIREDANDPULLUP << 8)             /**< Shifted mode WIREDANDPULLUP for GPIO_P_MODEH */
#define GPIO_P_MODEH_MODE10_WIREDANDPULLUPFILTER          (_GPIO_P_MODEH_MODE10_WIREDANDPULLUPFILTER << 8)       /**< Shifted mode WIREDANDPULLUPFILTER for GPIO_P_MODEH */
#define GPIO_P_MODEH_MODE10_WIREDANDDRIVE                 (_GPIO_P_MODEH_MODE10_WIREDANDDRIVE << 8)              /**< Shifted mode WIREDANDDRIVE for GPIO_P_MODEH */
#define GPIO_P_MODEH_MODE10_WIREDANDDRIVEFILTER           (_GPIO_P_MODEH_MODE10_WIREDANDDRIVEFILTER << 8)        /**< Shifted mode WIREDANDDRIVEFILTER for GPIO_P_MODEH */
#define GPIO_P_MODEH_MODE10_WIREDANDDRIVEPULLUP           (_GPIO_P_MODEH_MODE10_WIREDANDDRIVEPULLUP << 8)        /**< Shifted mode WIREDANDDRIVEPULLUP for GPIO_P_MODEH */
#define GPIO_P_MODEH_MODE10_WIREDANDDRIVEPULLUPFILTER     (_GPIO_P_MODEH_MODE10_WIREDANDDRIVEPULLUPFILTER << 8)  /**< Shifted mode WIREDANDDRIVEPULLUPFILTER for GPIO_P_MODEH */
#define _GPIO_P_MODEH_MODE11_SHIFT                        12                                                     /**< Shift value for GPIO_MODE11 */
#define _GPIO_P_MODEH_MODE11_MASK                         0xF000UL                                               /**< Bit mask for GPIO_MODE11 */
#define _GPIO_P_MODEH_MODE11_DEFAULT                      0x00000000UL                                           /**< Mode DEFAULT for GPIO_P_MODEH */
#define _GPIO_P_MODEH_MODE11_DISABLED                     0x00000000UL                                           /**< Mode DISABLED for GPIO_P_MODEH */
#define _GPIO_P_MODEH_MODE11_INPUT                        0x00000001UL                                           /**< Mode INPUT for GPIO_P_MODEH */
#define _GPIO_P_MODEH_MODE11_INPUTPULL                    0x00000002UL                                           /**< Mode INPUTPULL for GPIO_P_MODEH */
#define _GPIO_P_MODEH_MODE11_INPUTPULLFILTER              0x00000003UL                                           /**< Mode INPUTPULLFILTER for GPIO_P_MODEH */
#define _GPIO_P_MODEH_MODE11_PUSHPULL                     0x00000004UL                                           /**< Mode PUSHPULL for GPIO_P_MODEH */
#define _GPIO_P_MODEH_MODE11_PUSHPULLDRIVE                0x00000005UL                                           /**< Mode PUSHPULLDRIVE for GPIO_P_MODEH */
#define _GPIO_P_MODEH_MODE11_WIREDOR                      0x00000006UL                                           /**< Mode WIREDOR for GPIO_P_MODEH */
#define _GPIO_P_MODEH_MODE11_WIREDORPULLDOWN              0x00000007UL                                           /**< Mode WIREDORPULLDOWN for GPIO_P_MODEH */
#define _GPIO_P_MODEH_MODE11_WIREDAND                     0x00000008UL                                           /**< Mode WIREDAND for GPIO_P_MODEH */
#define _GPIO_P_MODEH_MODE11_WIREDANDFILTER               0x00000009UL                                           /**< Mode WIREDANDFILTER for GPIO_P_MODEH */
#define _GPIO_P_MODEH_MODE11_WIREDANDPULLUP               0x0000000AUL                                           /**< Mode WIREDANDPULLUP for GPIO_P_MODEH */
#define _GPIO_P_MODEH_MODE11_WIREDANDPULLUPFILTER         0x0000000BUL                                           /**< Mode WIREDANDPULLUPFILTER for GPIO_P_MODEH */
#define _GPIO_P_MODEH_MODE11_WIREDANDDRIVE                0x0000000CUL                                           /**< Mode WIREDANDDRIVE for GPIO_P_MODEH */
#define _GPIO_P_MODEH_MODE11_WIREDANDDRIVEFILTER          0x0000000DUL                                           /**< Mode WIREDANDDRIVEFILTER for GPIO_P_MODEH */
#define _GPIO_P_MODEH_MODE11_WIREDANDDRIVEPULLUP          0x0000000EUL                                           /**< Mode WIREDANDDRIVEPULLUP for GPIO_P_MODEH */
#define _GPIO_P_MODEH_MODE11_WIREDANDDRIVEPULLUPFILTER    0x0000000FUL                                           /**< Mode WIREDANDDRIVEPULLUPFILTER for GPIO_P_MODEH */
#define GPIO_P_MODEH_MODE11_DEFAULT                       (_GPIO_P_MODEH_MODE11_DEFAULT << 12)                   /**< Shifted mode DEFAULT for GPIO_P_MODEH */
#define GPIO_P_MODEH_MODE11_DISABLED                      (_GPIO_P_MODEH_MODE11_DISABLED << 12)                  /**< Shifted mode DISABLED for GPIO_P_MODEH */
#define GPIO_P_MODEH_MODE11_INPUT                         (_GPIO_P_MODEH_MODE11_INPUT << 12)                     /**< Shifted mode INPUT for GPIO_P_MODEH */
#define GPIO_P_MODEH_MODE11_INPUTPULL                     (_GPIO_P_MODEH_MODE11_INPUTPULL << 12)                 /**< Shifted mode INPUTPULL for GPIO_P_MODEH */
#define GPIO_P_MODEH_MODE11_INPUTPULLFILTER               (_GPIO_P_MODEH_MODE11_INPUTPULLFILTER << 12)           /**< Shifted mode INPUTPULLFILTER for GPIO_P_MODEH */
#define GPIO_P_MODEH_MODE11_PUSHPULL                      (_GPIO_P_MODEH_MODE11_PUSHPULL << 12)                  /**< Shifted mode PUSHPULL for GPIO_P_MODEH */
#define GPIO_P_MODEH_MODE11_PUSHPULLDRIVE                 (_GPIO_P_MODEH_MODE11_PUSHPULLDRIVE << 12)             /**< Shifted mode PUSHPULLDRIVE for GPIO_P_MODEH */
#define GPIO_P_MODEH_MODE11_WIREDOR                       (_GPIO_P_MODEH_MODE11_WIREDOR << 12)                   /**< Shifted mode WIREDOR for GPIO_P_MODEH */
#define GPIO_P_MODEH_MODE11_WIREDORPULLDOWN               (_GPIO_P_MODEH_MODE11_WIREDORPULLDOWN << 12)           /**< Shifted mode WIREDORPULLDOWN for GPIO_P_MODEH */
#define GPIO_P_MODEH_MODE11_WIREDAND                      (_GPIO_P_MODEH_MODE11_WIREDAND << 12)                  /**< Shifted mode WIREDAND for GPIO_P_MODEH */
#define GPIO_P_MODEH_MODE11_WIREDANDFILTER                (_GPIO_P_MODEH_MODE11_WIREDANDFILTER << 12)            /**< Shifted mode WIREDANDFILTER for GPIO_P_MODEH */
#define GPIO_P_MODEH_MODE11_WIREDANDPULLUP                (_GPIO_P_MODEH_MODE11_WIREDANDPULLUP << 12)            /**< Shifted mode WIREDANDPULLUP for GPIO_P_MODEH */
#define GPIO_P_MODEH_MODE11_WIREDANDPULLUPFILTER          (_GPIO_P_MODEH_MODE11_WIREDANDPULLUPFILTER << 12)      /**< Shifted mode WIREDANDPULLUPFILTER for GPIO_P_MODEH */
#define GPIO_P_MODEH_MODE11_WIREDANDDRIVE                 (_GPIO_P_MODEH_MODE11_WIREDANDDRIVE << 12)             /**< Shifted mode WIREDANDDRIVE for GPIO_P_MODEH */
#define GPIO_P_MODEH_MODE11_WIREDANDDRIVEFILTER           (_GPIO_P_MODEH_MODE11_WIREDANDDRIVEFILTER << 12)       /**< Shifted mode WIREDANDDRIVEFILTER for GPIO_P_MODEH */
#define GPIO_P_MODEH_MODE11_WIREDANDDRIVEPULLUP           (_GPIO_P_MODEH_MODE11_WIREDANDDRIVEPULLUP << 12)       /**< Shifted mode WIREDANDDRIVEPULLUP for GPIO_P_MODEH */
#define GPIO_P_MODEH_MODE11_WIREDANDDRIVEPULLUPFILTER     (_GPIO_P_MODEH_MODE11_WIREDANDDRIVEPULLUPFILTER << 12) /**< Shifted mode WIREDANDDRIVEPULLUPFILTER for GPIO_P_MODEH */
#define _GPIO_P_MODEH_MODE12_SHIFT                        16                                                     /**< Shift value for GPIO_MODE12 */
#define _GPIO_P_MODEH_MODE12_MASK                         0xF0000UL                                              /**< Bit mask for GPIO_MODE12 */
#define _GPIO_P_MODEH_MODE12_DEFAULT                      0x00000000UL                                           /**< Mode DEFAULT for GPIO_P_MODEH */
#define _GPIO_P_MODEH_MODE12_DISABLED                     0x00000000UL                                           /**< Mode DISABLED for GPIO_P_MODEH */
#define _GPIO_P_MODEH_MODE12_INPUT                        0x00000001UL                                           /**< Mode INPUT for GPIO_P_MODEH */
#define _GPIO_P_MODEH_MODE12_INPUTPULL                    0x00000002UL                                           /**< Mode INPUTPULL for GPIO_P_MODEH */
#define _GPIO_P_MODEH_MODE12_INPUTPULLFILTER              0x00000003UL                                           /**< Mode INPUTPULLFILTER for GPIO_P_MODEH */
#define _GPIO_P_MODEH_MODE12_PUSHPULL                     0x00000004UL                                           /**< Mode PUSHPULL for GPIO_P_MODEH */
#define _GPIO_P_MODEH_MODE12_PUSHPULLDRIVE                0x00000005UL                                           /**< Mode PUSHPULLDRIVE for GPIO_P_MODEH */
#define _GPIO_P_MODEH_MODE12_WIREDOR                      0x00000006UL                                           /**< Mode WIREDOR for GPIO_P_MODEH */
#define _GPIO_P_MODEH_MODE12_WIREDORPULLDOWN              0x00000007UL                                           /**< Mode WIREDORPULLDOWN for GPIO_P_MODEH */
#define _GPIO_P_MODEH_MODE12_WIREDAND                     0x00000008UL                                           /**< Mode WIREDAND for GPIO_P_MODEH */
#define _GPIO_P_MODEH_MODE12_WIREDANDFILTER               0x00000009UL                                           /**< Mode WIREDANDFILTER for GPIO_P_MODEH */
#define _GPIO_P_MODEH_MODE12_WIREDANDPULLUP               0x0000000AUL                                           /**< Mode WIREDANDPULLUP for GPIO_P_MODEH */
#define _GPIO_P_MODEH_MODE12_WIREDANDPULLUPFILTER         0x0000000BUL                                           /**< Mode WIREDANDPULLUPFILTER for GPIO_P_MODEH */
#define _GPIO_P_MODEH_MODE12_WIREDANDDRIVE                0x0000000CUL                                           /**< Mode WIREDANDDRIVE for GPIO_P_MODEH */
#define _GPIO_P_MODEH_MODE12_WIREDANDDRIVEFILTER          0x0000000DUL                                           /**< Mode WIREDANDDRIVEFILTER for GPIO_P_MODEH */
#define _GPIO_P_MODEH_MODE12_WIREDANDDRIVEPULLUP          0x0000000EUL                                           /**< Mode WIREDANDDRIVEPULLUP for GPIO_P_MODEH */
#define _GPIO_P_MODEH_MODE12_WIREDANDDRIVEPULLUPFILTER    0x0000000FUL                                           /**< Mode WIREDANDDRIVEPULLUPFILTER for GPIO_P_MODEH */
#define GPIO_P_MODEH_MODE12_DEFAULT                       (_GPIO_P_MODEH_MODE12_DEFAULT << 16)                   /**< Shifted mode DEFAULT for GPIO_P_MODEH */
#define GPIO_P_MODEH_MODE12_DISABLED                      (_GPIO_P_MODEH_MODE12_DISABLED << 16)                  /**< Shifted mode DISABLED for GPIO_P_MODEH */
#define GPIO_P_MODEH_MODE12_INPUT                         (_GPIO_P_MODEH_MODE12_INPUT << 16)                     /**< Shifted mode INPUT for GPIO_P_MODEH */
#define GPIO_P_MODEH_MODE12_INPUTPULL                     (_GPIO_P_MODEH_MODE12_INPUTPULL << 16)                 /**< Shifted mode INPUTPULL for GPIO_P_MODEH */
#define GPIO_P_MODEH_MODE12_INPUTPULLFILTER               (_GPIO_P_MODEH_MODE12_INPUTPULLFILTER << 16)           /**< Shifted mode INPUTPULLFILTER for GPIO_P_MODEH */
#define GPIO_P_MODEH_MODE12_PUSHPULL                      (_GPIO_P_MODEH_MODE12_PUSHPULL << 16)                  /**< Shifted mode PUSHPULL for GPIO_P_MODEH */
#define GPIO_P_MODEH_MODE12_PUSHPULLDRIVE                 (_GPIO_P_MODEH_MODE12_PUSHPULLDRIVE << 16)             /**< Shifted mode PUSHPULLDRIVE for GPIO_P_MODEH */
#define GPIO_P_MODEH_MODE12_WIREDOR                       (_GPIO_P_MODEH_MODE12_WIREDOR << 16)                   /**< Shifted mode WIREDOR for GPIO_P_MODEH */
#define GPIO_P_MODEH_MODE12_WIREDORPULLDOWN               (_GPIO_P_MODEH_MODE12_WIREDORPULLDOWN << 16)           /**< Shifted mode WIREDORPULLDOWN for GPIO_P_MODEH */
#define GPIO_P_MODEH_MODE12_WIREDAND                      (_GPIO_P_MODEH_MODE12_WIREDAND << 16)                  /**< Shifted mode WIREDAND for GPIO_P_MODEH */
#define GPIO_P_MODEH_MODE12_WIREDANDFILTER                (_GPIO_P_MODEH_MODE12_WIREDANDFILTER << 16)            /**< Shifted mode WIREDANDFILTER for GPIO_P_MODEH */
#define GPIO_P_MODEH_MODE12_WIREDANDPULLUP                (_GPIO_P_MODEH_MODE12_WIREDANDPULLUP << 16)            /**< Shifted mode WIREDANDPULLUP for GPIO_P_MODEH */
#define GPIO_P_MODEH_MODE12_WIREDANDPULLUPFILTER          (_GPIO_P_MODEH_MODE12_WIREDANDPULLUPFILTER << 16)      /**< Shifted mode WIREDANDPULLUPFILTER for GPIO_P_MODEH */
#define GPIO_P_MODEH_MODE12_WIREDANDDRIVE                 (_GPIO_P_MODEH_MODE12_WIREDANDDRIVE << 16)             /**< Shifted mode WIREDANDDRIVE for GPIO_P_MODEH */
#define GPIO_P_MODEH_MODE12_WIREDANDDRIVEFILTER           (_GPIO_P_MODEH_MODE12_WIREDANDDRIVEFILTER << 16)       /**< Shifted mode WIREDANDDRIVEFILTER for GPIO_P_MODEH */
#define GPIO_P_MODEH_MODE12_WIREDANDDRIVEPULLUP           (_GPIO_P_MODEH_MODE12_WIREDANDDRIVEPULLUP << 16)       /**< Shifted mode WIREDANDDRIVEPULLUP for GPIO_P_MODEH */
#define GPIO_P_MODEH_MODE12_WIREDANDDRIVEPULLUPFILTER     (_GPIO_P_MODEH_MODE12_WIREDANDDRIVEPULLUPFILTER << 16) /**< Shifted mode WIREDANDDRIVEPULLUPFILTER for GPIO_P_MODEH */
#define _GPIO_P_MODEH_MODE13_SHIFT                        20                                                     /**< Shift value for GPIO_MODE13 */
#define _GPIO_P_MODEH_MODE13_MASK                         0xF00000UL                                             /**< Bit mask for GPIO_MODE13 */
#define _GPIO_P_MODEH_MODE13_DEFAULT                      0x00000000UL                                           /**< Mode DEFAULT for GPIO_P_MODEH */
#define _GPIO_P_MODEH_MODE13_DISABLED                     0x00000000UL                                           /**< Mode DISABLED for GPIO_P_MODEH */
#define _GPIO_P_MODEH_MODE13_INPUT                        0x00000001UL                                           /**< Mode INPUT for GPIO_P_MODEH */
#define _GPIO_P_MODEH_MODE13_INPUTPULL                    0x00000002UL                                           /**< Mode INPUTPULL for GPIO_P_MODEH */
#define _GPIO_P_MODEH_MODE13_INPUTPULLFILTER              0x00000003UL                                           /**< Mode INPUTPULLFILTER for GPIO_P_MODEH */
#define _GPIO_P_MODEH_MODE13_PUSHPULL                     0x00000004UL                                           /**< Mode PUSHPULL for GPIO_P_MODEH */
#define _GPIO_P_MODEH_MODE13_PUSHPULLDRIVE                0x00000005UL                                           /**< Mode PUSHPULLDRIVE for GPIO_P_MODEH */
#define _GPIO_P_MODEH_MODE13_WIREDOR                      0x00000006UL                                           /**< Mode WIREDOR for GPIO_P_MODEH */
#define _GPIO_P_MODEH_MODE13_WIREDORPULLDOWN              0x00000007UL                                           /**< Mode WIREDORPULLDOWN for GPIO_P_MODEH */
#define _GPIO_P_MODEH_MODE13_WIREDAND                     0x00000008UL                                           /**< Mode WIREDAND for GPIO_P_MODEH */
#define _GPIO_P_MODEH_MODE13_WIREDANDFILTER               0x00000009UL                                           /**< Mode WIREDANDFILTER for GPIO_P_MODEH */
#define _GPIO_P_MODEH_MODE13_WIREDANDPULLUP               0x0000000AUL                                           /**< Mode WIREDANDPULLUP for GPIO_P_MODEH */
#define _GPIO_P_MODEH_MODE13_WIREDANDPULLUPFILTER         0x0000000BUL                                           /**< Mode WIREDANDPULLUPFILTER for GPIO_P_MODEH */
#define _GPIO_P_MODEH_MODE13_WIREDANDDRIVE                0x0000000CUL                                           /**< Mode WIREDANDDRIVE for GPIO_P_MODEH */
#define _GPIO_P_MODEH_MODE13_WIREDANDDRIVEFILTER          0x0000000DUL                                           /**< Mode WIREDANDDRIVEFILTER for GPIO_P_MODEH */
#define _GPIO_P_MODEH_MODE13_WIREDANDDRIVEPULLUP          0x0000000EUL                                           /**< Mode WIREDANDDRIVEPULLUP for GPIO_P_MODEH */
#define _GPIO_P_MODEH_MODE13_WIREDANDDRIVEPULLUPFILTER    0x0000000FUL                                           /**< Mode WIREDANDDRIVEPULLUPFILTER for GPIO_P_MODEH */
#define GPIO_P_MODEH_MODE13_DEFAULT                       (_GPIO_P_MODEH_MODE13_DEFAULT << 20)                   /**< Shifted mode DEFAULT for GPIO_P_MODEH */
#define GPIO_P_MODEH_MODE13_DISABLED                      (_GPIO_P_MODEH_MODE13_DISABLED << 20)                  /**< Shifted mode DISABLED for GPIO_P_MODEH */
#define GPIO_P_MODEH_MODE13_INPUT                         (_GPIO_P_MODEH_MODE13_INPUT << 20)                     /**< Shifted mode INPUT for GPIO_P_MODEH */
#define GPIO_P_MODEH_MODE13_INPUTPULL                     (_GPIO_P_MODEH_MODE13_INPUTPULL << 20)                 /**< Shifted mode INPUTPULL for GPIO_P_MODEH */
#define GPIO_P_MODEH_MODE13_INPUTPULLFILTER               (_GPIO_P_MODEH_MODE13_INPUTPULLFILTER << 20)           /**< Shifted mode INPUTPULLFILTER for GPIO_P_MODEH */
#define GPIO_P_MODEH_MODE13_PUSHPULL                      (_GPIO_P_MODEH_MODE13_PUSHPULL << 20)                  /**< Shifted mode PUSHPULL for GPIO_P_MODEH */
#define GPIO_P_MODEH_MODE13_PUSHPULLDRIVE                 (_GPIO_P_MODEH_MODE13_PUSHPULLDRIVE << 20)             /**< Shifted mode PUSHPULLDRIVE for GPIO_P_MODEH */
#define GPIO_P_MODEH_MODE13_WIREDOR                       (_GPIO_P_MODEH_MODE13_WIREDOR << 20)                   /**< Shifted mode WIREDOR for GPIO_P_MODEH */
#define GPIO_P_MODEH_MODE13_WIREDORPULLDOWN               (_GPIO_P_MODEH_MODE13_WIREDORPULLDOWN << 20)           /**< Shifted mode WIREDORPULLDOWN for GPIO_P_MODEH */
#define GPIO_P_MODEH_MODE13_WIREDAND                      (_GPIO_P_MODEH_MODE13_WIREDAND << 20)                  /**< Shifted mode WIREDAND for GPIO_P_MODEH */
#define GPIO_P_MODEH_MODE13_WIREDANDFILTER                (_GPIO_P_MODEH_MODE13_WIREDANDFILTER << 20)            /**< Shifted mode WIREDANDFILTER for GPIO_P_MODEH */
#define GPIO_P_MODEH_MODE13_WIREDANDPULLUP                (_GPIO_P_MODEH_MODE13_WIREDANDPULLUP << 20)            /**< Shifted mode WIREDANDPULLUP for GPIO_P_MODEH */
#define GPIO_P_MODEH_MODE13_WIREDANDPULLUPFILTER          (_GPIO_P_MODEH_MODE13_WIREDANDPULLUPFILTER << 20)      /**< Shifted mode WIREDANDPULLUPFILTER for GPIO_P_MODEH */
#define GPIO_P_MODEH_MODE13_WIREDANDDRIVE                 (_GPIO_P_MODEH_MODE13_WIREDANDDRIVE << 20)             /**< Shifted mode WIREDANDDRIVE for GPIO_P_MODEH */
#define GPIO_P_MODEH_MODE13_WIREDANDDRIVEFILTER           (_GPIO_P_MODEH_MODE13_WIREDANDDRIVEFILTER << 20)       /**< Shifted mode WIREDANDDRIVEFILTER for GPIO_P_MODEH */
#define GPIO_P_MODEH_MODE13_WIREDANDDRIVEPULLUP           (_GPIO_P_MODEH_MODE13_WIREDANDDRIVEPULLUP << 20)       /**< Shifted mode WIREDANDDRIVEPULLUP for GPIO_P_MODEH */
#define GPIO_P_MODEH_MODE13_WIREDANDDRIVEPULLUPFILTER     (_GPIO_P_MODEH_MODE13_WIREDANDDRIVEPULLUPFILTER << 20) /**< Shifted mode WIREDANDDRIVEPULLUPFILTER for GPIO_P_MODEH */
#define _GPIO_P_MODEH_MODE14_SHIFT                        24                                                     /**< Shift value for GPIO_MODE14 */
#define _GPIO_P_MODEH_MODE14_MASK                         0xF000000UL                                            /**< Bit mask for GPIO_MODE14 */
#define _GPIO_P_MODEH_MODE14_DEFAULT                      0x00000000UL                                           /**< Mode DEFAULT for GPIO_P_MODEH */
#define _GPIO_P_MODEH_MODE14_DISABLED                     0x00000000UL                                           /**< Mode DISABLED for GPIO_P_MODEH */
#define _GPIO_P_MODEH_MODE14_INPUT                        0x00000001UL                                           /**< Mode INPUT for GPIO_P_MODEH */
#define _GPIO_P_MODEH_MODE14_INPUTPULL                    0x00000002UL                                           /**< Mode INPUTPULL for GPIO_P_MODEH */
#define _GPIO_P_MODEH_MODE14_INPUTPULLFILTER              0x00000003UL                                           /**< Mode INPUTPULLFILTER for GPIO_P_MODEH */
#define _GPIO_P_MODEH_MODE14_PUSHPULL                     0x00000004UL                                           /**< Mode PUSHPULL for GPIO_P_MODEH */
#define _GPIO_P_MODEH_MODE14_PUSHPULLDRIVE                0x00000005UL                                           /**< Mode PUSHPULLDRIVE for GPIO_P_MODEH */
#define _GPIO_P_MODEH_MODE14_WIREDOR                      0x00000006UL                                           /**< Mode WIREDOR for GPIO_P_MODEH */
#define _GPIO_P_MODEH_MODE14_WIREDORPULLDOWN              0x00000007UL                                           /**< Mode WIREDORPULLDOWN for GPIO_P_MODEH */
#define _GPIO_P_MODEH_MODE14_WIREDAND                     0x00000008UL                                           /**< Mode WIREDAND for GPIO_P_MODEH */
#define _GPIO_P_MODEH_MODE14_WIREDANDFILTER               0x00000009UL                                           /**< Mode WIREDANDFILTER for GPIO_P_MODEH */
#define _GPIO_P_MODEH_MODE14_WIREDANDPULLUP               0x0000000AUL                                           /**< Mode WIREDANDPULLUP for GPIO_P_MODEH */
#define _GPIO_P_MODEH_MODE14_WIREDANDPULLUPFILTER         0x0000000BUL                                           /**< Mode WIREDANDPULLUPFILTER for GPIO_P_MODEH */
#define _GPIO_P_MODEH_MODE14_WIREDANDDRIVE                0x0000000CUL                                           /**< Mode WIREDANDDRIVE for GPIO_P_MODEH */
#define _GPIO_P_MODEH_MODE14_WIREDANDDRIVEFILTER          0x0000000DUL                                           /**< Mode WIREDANDDRIVEFILTER for GPIO_P_MODEH */
#define _GPIO_P_MODEH_MODE14_WIREDANDDRIVEPULLUP          0x0000000EUL                                           /**< Mode WIREDANDDRIVEPULLUP for GPIO_P_MODEH */
#define _GPIO_P_MODEH_MODE14_WIREDANDDRIVEPULLUPFILTER    0x0000000FUL                                           /**< Mode WIREDANDDRIVEPULLUPFILTER for GPIO_P_MODEH */
#define GPIO_P_MODEH_MODE14_DEFAULT                       (_GPIO_P_MODEH_MODE14_DEFAULT << 24)                   /**< Shifted mode DEFAULT for GPIO_P_MODEH */
#define GPIO_P_MODEH_MODE14_DISABLED                      (_GPIO_P_MODEH_MODE14_DISABLED << 24)                  /**< Shifted mode DISABLED for GPIO_P_MODEH */
#define GPIO_P_MODEH_MODE14_INPUT                         (_GPIO_P_MODEH_MODE14_INPUT << 24)                     /**< Shifted mode INPUT for GPIO_P_MODEH */
#define GPIO_P_MODEH_MODE14_INPUTPULL                     (_GPIO_P_MODEH_MODE14_INPUTPULL << 24)                 /**< Shifted mode INPUTPULL for GPIO_P_MODEH */
#define GPIO_P_MODEH_MODE14_INPUTPULLFILTER               (_GPIO_P_MODEH_MODE14_INPUTPULLFILTER << 24)           /**< Shifted mode INPUTPULLFILTER for GPIO_P_MODEH */
#define GPIO_P_MODEH_MODE14_PUSHPULL                      (_GPIO_P_MODEH_MODE14_PUSHPULL << 24)                  /**< Shifted mode PUSHPULL for GPIO_P_MODEH */
#define GPIO_P_MODEH_MODE14_PUSHPULLDRIVE                 (_GPIO_P_MODEH_MODE14_PUSHPULLDRIVE << 24)             /**< Shifted mode PUSHPULLDRIVE for GPIO_P_MODEH */
#define GPIO_P_MODEH_MODE14_WIREDOR                       (_GPIO_P_MODEH_MODE14_WIREDOR << 24)                   /**< Shifted mode WIREDOR for GPIO_P_MODEH */
#define GPIO_P_MODEH_MODE14_WIREDORPULLDOWN               (_GPIO_P_MODEH_MODE14_WIREDORPULLDOWN << 24)           /**< Shifted mode WIREDORPULLDOWN for GPIO_P_MODEH */
#define GPIO_P_MODEH_MODE14_WIREDAND                      (_GPIO_P_MODEH_MODE14_WIREDAND << 24)                  /**< Shifted mode WIREDAND for GPIO_P_MODEH */
#define GPIO_P_MODEH_MODE14_WIREDANDFILTER                (_GPIO_P_MODEH_MODE14_WIREDANDFILTER << 24)            /**< Shifted mode WIREDANDFILTER for GPIO_P_MODEH */
#define GPIO_P_MODEH_MODE14_WIREDANDPULLUP                (_GPIO_P_MODEH_MODE14_WIREDANDPULLUP << 24)            /**< Shifted mode WIREDANDPULLUP for GPIO_P_MODEH */
#define GPIO_P_MODEH_MODE14_WIREDANDPULLUPFILTER          (_GPIO_P_MODEH_MODE14_WIREDANDPULLUPFILTER << 24)      /**< Shifted mode WIREDANDPULLUPFILTER for GPIO_P_MODEH */
#define GPIO_P_MODEH_MODE14_WIREDANDDRIVE                 (_GPIO_P_MODEH_MODE14_WIREDANDDRIVE << 24)             /**< Shifted mode WIREDANDDRIVE for GPIO_P_MODEH */
#define GPIO_P_MODEH_MODE14_WIREDANDDRIVEFILTER           (_GPIO_P_MODEH_MODE14_WIREDANDDRIVEFILTER << 24)       /**< Shifted mode WIREDANDDRIVEFILTER for GPIO_P_MODEH */
#define GPIO_P_MODEH_MODE14_WIREDANDDRIVEPULLUP           (_GPIO_P_MODEH_MODE14_WIREDANDDRIVEPULLUP << 24)       /**< Shifted mode WIREDANDDRIVEPULLUP for GPIO_P_MODEH */
#define GPIO_P_MODEH_MODE14_WIREDANDDRIVEPULLUPFILTER     (_GPIO_P_MODEH_MODE14_WIREDANDDRIVEPULLUPFILTER << 24) /**< Shifted mode WIREDANDDRIVEPULLUPFILTER for GPIO_P_MODEH */
#define _GPIO_P_MODEH_MODE15_SHIFT                        28                                                     /**< Shift value for GPIO_MODE15 */
#define _GPIO_P_MODEH_MODE15_MASK                         0xF0000000UL                                           /**< Bit mask for GPIO_MODE15 */
#define _GPIO_P_MODEH_MODE15_DEFAULT                      0x00000000UL                                           /**< Mode DEFAULT for GPIO_P_MODEH */
#define _GPIO_P_MODEH_MODE15_DISABLED                     0x00000000UL                                           /**< Mode DISABLED for GPIO_P_MODEH */
#define _GPIO_P_MODEH_MODE15_INPUT                        0x00000001UL                                           /**< Mode INPUT for GPIO_P_MODEH */
#define _GPIO_P_MODEH_MODE15_INPUTPULL                    0x00000002UL                                           /**< Mode INPUTPULL for GPIO_P_MODEH */
#define _GPIO_P_MODEH_MODE15_INPUTPULLFILTER              0x00000003UL                                           /**< Mode INPUTPULLFILTER for GPIO_P_MODEH */
#define _GPIO_P_MODEH_MODE15_PUSHPULL                     0x00000004UL                                           /**< Mode PUSHPULL for GPIO_P_MODEH */
#define _GPIO_P_MODEH_MODE15_PUSHPULLDRIVE                0x00000005UL                                           /**< Mode PUSHPULLDRIVE for GPIO_P_MODEH */
#define _GPIO_P_MODEH_MODE15_WIREDOR                      0x00000006UL                                           /**< Mode WIREDOR for GPIO_P_MODEH */
#define _GPIO_P_MODEH_MODE15_WIREDORPULLDOWN              0x00000007UL                                           /**< Mode WIREDORPULLDOWN for GPIO_P_MODEH */
#define _GPIO_P_MODEH_MODE15_WIREDAND                     0x00000008UL                                           /**< Mode WIREDAND for GPIO_P_MODEH */
#define _GPIO_P_MODEH_MODE15_WIREDANDFILTER               0x00000009UL                                           /**< Mode WIREDANDFILTER for GPIO_P_MODEH */
#define _GPIO_P_MODEH_MODE15_WIREDANDPULLUP               0x0000000AUL                                           /**< Mode WIREDANDPULLUP for GPIO_P_MODEH */
#define _GPIO_P_MODEH_MODE15_WIREDANDPULLUPFILTER         0x0000000BUL                                           /**< Mode WIREDANDPULLUPFILTER for GPIO_P_MODEH */
#define _GPIO_P_MODEH_MODE15_WIREDANDDRIVE                0x0000000CUL                                           /**< Mode WIREDANDDRIVE for GPIO_P_MODEH */
#define _GPIO_P_MODEH_MODE15_WIREDANDDRIVEFILTER          0x0000000DUL                                           /**< Mode WIREDANDDRIVEFILTER for GPIO_P_MODEH */
#define _GPIO_P_MODEH_MODE15_WIREDANDDRIVEPULLUP          0x0000000EUL                                           /**< Mode WIREDANDDRIVEPULLUP for GPIO_P_MODEH */
#define _GPIO_P_MODEH_MODE15_WIREDANDDRIVEPULLUPFILTER    0x0000000FUL                                           /**< Mode WIREDANDDRIVEPULLUPFILTER for GPIO_P_MODEH */
#define GPIO_P_MODEH_MODE15_DEFAULT                       (_GPIO_P_MODEH_MODE15_DEFAULT << 28)                   /**< Shifted mode DEFAULT for GPIO_P_MODEH */
#define GPIO_P_MODEH_MODE15_DISABLED                      (_GPIO_P_MODEH_MODE15_DISABLED << 28)                  /**< Shifted mode DISABLED for GPIO_P_MODEH */
#define GPIO_P_MODEH_MODE15_INPUT                         (_GPIO_P_MODEH_MODE15_INPUT << 28)                     /**< Shifted mode INPUT for GPIO_P_MODEH */
#define GPIO_P_MODEH_MODE15_INPUTPULL                     (_GPIO_P_MODEH_MODE15_INPUTPULL << 28)                 /**< Shifted mode INPUTPULL for GPIO_P_MODEH */
#define GPIO_P_MODEH_MODE15_INPUTPULLFILTER               (_GPIO_P_MODEH_MODE15_INPUTPULLFILTER << 28)           /**< Shifted mode INPUTPULLFILTER for GPIO_P_MODEH */
#define GPIO_P_MODEH_MODE15_PUSHPULL                      (_GPIO_P_MODEH_MODE15_PUSHPULL << 28)                  /**< Shifted mode PUSHPULL for GPIO_P_MODEH */
#define GPIO_P_MODEH_MODE15_PUSHPULLDRIVE                 (_GPIO_P_MODEH_MODE15_PUSHPULLDRIVE << 28)             /**< Shifted mode PUSHPULLDRIVE for GPIO_P_MODEH */
#define GPIO_P_MODEH_MODE15_WIREDOR                       (_GPIO_P_MODEH_MODE15_WIREDOR << 28)                   /**< Shifted mode WIREDOR for GPIO_P_MODEH */
#define GPIO_P_MODEH_MODE15_WIREDORPULLDOWN               (_GPIO_P_MODEH_MODE15_WIREDORPULLDOWN << 28)           /**< Shifted mode WIREDORPULLDOWN for GPIO_P_MODEH */
#define GPIO_P_MODEH_MODE15_WIREDAND                      (_GPIO_P_MODEH_MODE15_WIREDAND << 28)                  /**< Shifted mode WIREDAND for GPIO_P_MODEH */
#define GPIO_P_MODEH_MODE15_WIREDANDFILTER                (_GPIO_P_MODEH_MODE15_WIREDANDFILTER << 28)            /**< Shifted mode WIREDANDFILTER for GPIO_P_MODEH */
#define GPIO_P_MODEH_MODE15_WIREDANDPULLUP                (_GPIO_P_MODEH_MODE15_WIREDANDPULLUP << 28)            /**< Shifted mode WIREDANDPULLUP for GPIO_P_MODEH */
#define GPIO_P_MODEH_MODE15_WIREDANDPULLUPFILTER          (_GPIO_P_MODEH_MODE15_WIREDANDPULLUPFILTER << 28)      /**< Shifted mode WIREDANDPULLUPFILTER for GPIO_P_MODEH */
#define GPIO_P_MODEH_MODE15_WIREDANDDRIVE                 (_GPIO_P_MODEH_MODE15_WIREDANDDRIVE << 28)             /**< Shifted mode WIREDANDDRIVE for GPIO_P_MODEH */
#define GPIO_P_MODEH_MODE15_WIREDANDDRIVEFILTER           (_GPIO_P_MODEH_MODE15_WIREDANDDRIVEFILTER << 28)       /**< Shifted mode WIREDANDDRIVEFILTER for GPIO_P_MODEH */
#define GPIO_P_MODEH_MODE15_WIREDANDDRIVEPULLUP           (_GPIO_P_MODEH_MODE15_WIREDANDDRIVEPULLUP << 28)       /**< Shifted mode WIREDANDDRIVEPULLUP for GPIO_P_MODEH */
#define GPIO_P_MODEH_MODE15_WIREDANDDRIVEPULLUPFILTER     (_GPIO_P_MODEH_MODE15_WIREDANDDRIVEPULLUPFILTER << 28) /**< Shifted mode WIREDANDDRIVEPULLUPFILTER for GPIO_P_MODEH */

/* Bit fields for GPIO P_DOUT */
#define _GPIO_P_DOUT_RESETVALUE                           0x00000000UL                     /**< Default value for GPIO_P_DOUT */
#define _GPIO_P_DOUT_MASK                                 0x0000FFFFUL                     /**< Mask for GPIO_P_DOUT */
#define _GPIO_P_DOUT_DOUT_SHIFT                           0                                /**< Shift value for GPIO_DOUT */
#define _GPIO_P_DOUT_DOUT_MASK                            0xFFFFUL                         /**< Bit mask for GPIO_DOUT */
#define _GPIO_P_DOUT_DOUT_DEFAULT                         0x00000000UL                     /**< Mode DEFAULT for GPIO_P_DOUT */
#define GPIO_P_DOUT_DOUT_DEFAULT                          (_GPIO_P_DOUT_DOUT_DEFAULT << 0) /**< Shifted mode DEFAULT for GPIO_P_DOUT */

/* Bit fields for GPIO P_DOUTSET */
#define _GPIO_P_DOUTSET_RESETVALUE                        0x00000000UL                           /**< Default value for GPIO_P_DOUTSET */
#define _GPIO_P_DOUTSET_MASK                              0x0000FFFFUL                           /**< Mask for GPIO_P_DOUTSET */
#define _GPIO_P_DOUTSET_DOUTSET_SHIFT                     0                                      /**< Shift value for GPIO_DOUTSET */
#define _GPIO_P_DOUTSET_DOUTSET_MASK                      0xFFFFUL                               /**< Bit mask for GPIO_DOUTSET */
#define _GPIO_P_DOUTSET_DOUTSET_DEFAULT                   0x00000000UL                           /**< Mode DEFAULT for GPIO_P_DOUTSET */
#define GPIO_P_DOUTSET_DOUTSET_DEFAULT                    (_GPIO_P_DOUTSET_DOUTSET_DEFAULT << 0) /**< Shifted mode DEFAULT for GPIO_P_DOUTSET */

/* Bit fields for GPIO P_DOUTCLR */
#define _GPIO_P_DOUTCLR_RESETVALUE                        0x00000000UL                           /**< Default value for GPIO_P_DOUTCLR */
#define _GPIO_P_DOUTCLR_MASK                              0x0000FFFFUL                           /**< Mask for GPIO_P_DOUTCLR */
#define _GPIO_P_DOUTCLR_DOUTCLR_SHIFT                     0                                      /**< Shift value for GPIO_DOUTCLR */
#define _GPIO_P_DOUTCLR_DOUTCLR_MASK                      0xFFFFUL                               /**< Bit mask for GPIO_DOUTCLR */
#define _GPIO_P_DOUTCLR_DOUTCLR_DEFAULT                   0x00000000UL                           /**< Mode DEFAULT for GPIO_P_DOUTCLR */
#define GPIO_P_DOUTCLR_DOUTCLR_DEFAULT                    (_GPIO_P_DOUTCLR_DOUTCLR_DEFAULT << 0) /**< Shifted mode DEFAULT for GPIO_P_DOUTCLR */

/* Bit fields for GPIO P_DOUTTGL */
#define _GPIO_P_DOUTTGL_RESETVALUE                        0x00000000UL                           /**< Default value for GPIO_P_DOUTTGL */
#define _GPIO_P_DOUTTGL_MASK                              0x0000FFFFUL                           /**< Mask for GPIO_P_DOUTTGL */
#define _GPIO_P_DOUTTGL_DOUTTGL_SHIFT                     0                                      /**< Shift value for GPIO_DOUTTGL */
#define _GPIO_P_DOUTTGL_DOUTTGL_MASK                      0xFFFFUL                               /**< Bit mask for GPIO_DOUTTGL */
#define _GPIO_P_DOUTTGL_DOUTTGL_DEFAULT                   0x00000000UL                           /**< Mode DEFAULT for GPIO_P_DOUTTGL */
#define GPIO_P_DOUTTGL_DOUTTGL_DEFAULT                    (_GPIO_P_DOUTTGL_DOUTTGL_DEFAULT << 0) /**< Shifted mode DEFAULT for GPIO_P_DOUTTGL */

/* Bit fields for GPIO P_DIN */
#define _GPIO_P_DIN_RESETVALUE                            0x00000000UL                   /**< Default value for GPIO_P_DIN */
#define _GPIO_P_DIN_MASK                                  0x0000FFFFUL                   /**< Mask for GPIO_P_DIN */
#define _GPIO_P_DIN_DIN_SHIFT                             0                              /**< Shift value for GPIO_DIN */
#define _GPIO_P_DIN_DIN_MASK                              0xFFFFUL                       /**< Bit mask for GPIO_DIN */
#define _GPIO_P_DIN_DIN_DEFAULT                           0x00000000UL                   /**< Mode DEFAULT for GPIO_P_DIN */
#define GPIO_P_DIN_DIN_DEFAULT                            (_GPIO_P_DIN_DIN_DEFAULT << 0) /**< Shifted mode DEFAULT for GPIO_P_DIN */

/* Bit fields for GPIO P_PINLOCKN */
#define _GPIO_P_PINLOCKN_RESETVALUE                       0x0000FFFFUL                             /**< Default value for GPIO_P_PINLOCKN */
#define _GPIO_P_PINLOCKN_MASK                             0x0000FFFFUL                             /**< Mask for GPIO_P_PINLOCKN */
#define _GPIO_P_PINLOCKN_PINLOCKN_SHIFT                   0                                        /**< Shift value for GPIO_PINLOCKN */
#define _GPIO_P_PINLOCKN_PINLOCKN_MASK                    0xFFFFUL                                 /**< Bit mask for GPIO_PINLOCKN */
#define _GPIO_P_PINLOCKN_PINLOCKN_DEFAULT                 0x0000FFFFUL                             /**< Mode DEFAULT for GPIO_P_PINLOCKN */
#define GPIO_P_PINLOCKN_PINLOCKN_DEFAULT                  (_GPIO_P_PINLOCKN_PINLOCKN_DEFAULT << 0) /**< Shifted mode DEFAULT for GPIO_P_PINLOCKN */
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
