maltanar/equine-health-monitor-gdp12/STK3300-TinyGecko/common/EFM32TG/Include/efm32tg108f16.h

/**************************************************************************//**
 * @file
 * @brief CMSIS Cortex-M3 Peripheral Access Layer Header File
 *        for EFM EFM32TG108F16
 * @author Energy Micro AS
 * @version 3.0.1
 ******************************************************************************
 * @section License
 * <b>(C) Copyright 2012 Energy Micro AS, http://www.energymicro.com</b>
 ******************************************************************************
 *
 * Permission is granted to anyone to use this software for any purpose,
 * including commercial applications, and to alter it and redistribute it
 * freely, subject to the following restrictions:
 *
 * 1. The origin of this software must not be misrepresented; you must not
 *    claim that you wrote the original software.
 * 2. Altered source versions must be plainly marked as such, and must not be
 *    misrepresented as being the original software.
 * 3. This notice may not be removed or altered from any source distribution.
 *
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
 * Energy Micro AS will not be liable for any consequential, incidental, or
 * special damages, or any other relief, or for any claim by any third party,
 * arising from your use of this Software.
 *
 *****************************************************************************/

#ifndef __EFM32TG108F16_H
#define __EFM32TG108F16_H

#ifdef __cplusplus
extern "C" {
#endif

/**************************************************************************//**
 * @addtogroup Parts
 * @{
 *****************************************************************************/

/**************************************************************************//**
 * @defgroup EFM32TG108F16 EFM32TG108F16
 * @{
 *****************************************************************************/

/** Interrupt Number Definition */
typedef enum IRQn
{
/******  Cortex-M3 Processor Exceptions Numbers *******************************************/
  NonMaskableInt_IRQn   = -14,              /*!< 2 Non Maskable Interrupt                 */
  HardFault_IRQn        = -13,              /*!< 3 Cortex-M3 Hard Fault Interrupt         */
  MemoryManagement_IRQn = -12,              /*!< 4 Cortex-M3 Memory Management Interrupt  */
  BusFault_IRQn         = -11,              /*!< 5 Cortex-M3 Bus Fault Interrupt          */
  UsageFault_IRQn       = -10,              /*!< 6 Cortex-M3 Usage Fault Interrupt        */
  SVCall_IRQn           = -5,               /*!< 11 Cortex-M3 SV Call Interrupt           */
  DebugMonitor_IRQn     = -4,               /*!< 12 Cortex-M3 Debug Monitor Interrupt     */
  PendSV_IRQn           = -2,               /*!< 14 Cortex-M3 Pend SV Interrupt           */
  SysTick_IRQn          = -1,               /*!< 15 Cortex-M3 System Tick Interrupt       */

/******  EFM32G Peripheral Interrupt Numbers **********************************************/
  DMA_IRQn              = 0,  /*!< 16+0 EFM32 DMA Interrupt */
  GPIO_EVEN_IRQn        = 1,  /*!< 16+1 EFM32 GPIO_EVEN Interrupt */
  TIMER0_IRQn           = 2,  /*!< 16+2 EFM32 TIMER0 Interrupt */
  ACMP0_IRQn            = 5,  /*!< 16+5 EFM32 ACMP0 Interrupt */
  I2C0_IRQn             = 8,  /*!< 16+8 EFM32 I2C0 Interrupt */
  GPIO_ODD_IRQn         = 9,  /*!< 16+9 EFM32 GPIO_ODD Interrupt */
  TIMER1_IRQn           = 10, /*!< 16+10 EFM32 TIMER1 Interrupt */
  USART1_RX_IRQn        = 11, /*!< 16+11 EFM32 USART1_RX Interrupt */
  USART1_TX_IRQn        = 12, /*!< 16+12 EFM32 USART1_TX Interrupt */
  LESENSE_IRQn          = 13, /*!< 16+13 EFM32 LESENSE Interrupt */
  LEUART0_IRQn          = 14, /*!< 16+14 EFM32 LEUART0 Interrupt */
  LETIMER0_IRQn         = 15, /*!< 16+15 EFM32 LETIMER0 Interrupt */
  PCNT0_IRQn            = 16, /*!< 16+16 EFM32 PCNT0 Interrupt */
  RTC_IRQn              = 17, /*!< 16+17 EFM32 RTC Interrupt */
  CMU_IRQn              = 18, /*!< 16+18 EFM32 CMU Interrupt */
  VCMP_IRQn             = 19, /*!< 16+19 EFM32 VCMP Interrupt */
  MSC_IRQn              = 21, /*!< 16+21 EFM32 MSC Interrupt */
} IRQn_Type;

/**************************************************************************//**
 * @defgroup EFM32TG108F16_Core EFM32TG108F16 Core
 * @{
 * @brief Processor and Core Peripheral Section
 *****************************************************************************/
#define __MPU_PRESENT             0 /**< MPU not present */
#define __NVIC_PRIO_BITS          3 /**< NVIC interrupt priority bits */
#define __Vendor_SysTickConfig    0 /**< Is 1 if different SysTick counter is used */

/** @} End of group EFM32TG108F16_Core */

/**************************************************************************//**
* @defgroup EFM32TG108F16_Part EFM32TG108F16 Part
* @{
******************************************************************************/

/** Part family */
#define _EFM32_TINY_FAMILY    1 /**< Tiny Gecko EFM32TG MCU Family */

/* If part number is not defined as compiler option, define it */
#if !defined(EFM32TG108F16)
#define EFM32TG108F16    1 /**< Tiny Gecko Part  */
#endif

/** Configure part number */
#define PART_NUMBER          "EFM32TG108F16" /**< Part Number */

/** Memory Base addresses and limits */
#define AES_MEM_BASE         ((uint32_t) 0x400E0000UL)  /**< AES base address  */
#define AES_MEM_SIZE         ((uint32_t) 0x400UL)       /**< AES available address space  */
#define AES_MEM_END          ((uint32_t) 0x400E03FFUL)  /**< AES end address  */
#define AES_MEM_BITS         ((uint32_t) 0x10UL)        /**< AES used bits  */
#define PER_MEM_BASE         ((uint32_t) 0x40000000UL)  /**< PER base address  */
#define PER_MEM_SIZE         ((uint32_t) 0xE0000UL)     /**< PER available address space  */
#define PER_MEM_END          ((uint32_t) 0x400DFFFFUL)  /**< PER end address  */
#define PER_MEM_BITS         ((uint32_t) 0x20UL)        /**< PER used bits  */
#define RAM_MEM_BASE         ((uint32_t) 0x20000000UL)  /**< RAM base address  */
#define RAM_MEM_SIZE         ((uint32_t) 0x40000UL)     /**< RAM available address space  */
#define RAM_MEM_END          ((uint32_t) 0x2003FFFFUL)  /**< RAM end address  */
#define RAM_MEM_BITS         ((uint32_t) 0x18UL)        /**< RAM used bits  */
#define RAM_CODE_MEM_BASE    ((uint32_t) 0x10000000UL)  /**< RAM_CODE base address  */
#define RAM_CODE_MEM_SIZE    ((uint32_t) 0x4000UL)      /**< RAM_CODE available address space  */
#define RAM_CODE_MEM_END     ((uint32_t) 0x10003FFFUL)  /**< RAM_CODE end address  */
#define RAM_CODE_MEM_BITS    ((uint32_t) 0x14UL)        /**< RAM_CODE used bits  */
#define FLASH_MEM_BASE       ((uint32_t) 0x0UL)         /**< FLASH base address  */
#define FLASH_MEM_SIZE       ((uint32_t) 0x10000000UL)  /**< FLASH available address space  */
#define FLASH_MEM_END        ((uint32_t) 0xFFFFFFFUL)   /**< FLASH end address  */
#define FLASH_MEM_BITS       ((uint32_t) 0x28UL)        /**< FLASH used bits  */

/** Bit banding area */
#define BITBAND_PER_BASE     ((uint32_t) 0x42000000UL) /**< Peripheral Address Space bit-band area */
#define BITBAND_RAM_BASE     ((uint32_t) 0x22000000UL) /**< SRAM Address Space bit-band area */

/** Flash and SRAM limits for EFM32TG108F16 */
#define FLASH_BASE           (0x00000000UL) /**< Flash Base Address */
#define FLASH_SIZE           (0x00004000UL) /**< Available Flash Memory */
#define SRAM_BASE            (0x20000000UL) /**< SRAM Base Address */
#define SRAM_SIZE            (0x00001000UL) /**< Available SRAM Memory */
#define __CM3_REV            0x201          /**< Cortex-M3 Core revision r2p1 */
#define PRS_CHAN_COUNT       8              /**< Number of PRS channels */
#define DMA_CHAN_COUNT       8              /**< Number of DMA channels */

/** AF channels connect the different on-chip peripherals with the af-mux */
#define AFCHAN_MAX           63
#define AFCHANLOC_MAX        7
/** Analog AF channels */
#define AFACHAN_MAX          47

/* Part number capabilities */

#define TIMER_PRESENT         /**< TIMER is available in this part */
#define TIMER_COUNT         2 /**< 2 TIMERs available  */
#define USART_PRESENT         /**< USART is available in this part */
#define USART_COUNT         1 /**< 1 USARTs available  */
#define LEUART_PRESENT        /**< LEUART is available in this part */
#define LEUART_COUNT        1 /**< 1 LEUARTs available  */
#define LETIMER_PRESENT       /**< LETIMER is available in this part */
#define LETIMER_COUNT       1 /**< 1 LETIMERs available  */
#define PCNT_PRESENT          /**< PCNT is available in this part */
#define PCNT_COUNT          1 /**< 1 PCNTs available  */
#define I2C_PRESENT           /**< I2C is available in this part */
#define I2C_COUNT           1 /**< 1 I2Cs available  */
#define ACMP_PRESENT          /**< ACMP is available in this part */
#define ACMP_COUNT          2 /**< 2 ACMPs available  */
#define LE_PRESENT
#define LE_COUNT            1
#define MSC_PRESENT
#define MSC_COUNT           1
#define EMU_PRESENT
#define EMU_COUNT           1
#define RMU_PRESENT
#define RMU_COUNT           1
#define CMU_PRESENT
#define CMU_COUNT           1
#define LESENSE_PRESENT
#define LESENSE_COUNT       1
#define GPIO_PRESENT
#define GPIO_COUNT          1
#define PRS_PRESENT
#define PRS_COUNT           1
#define DMA_PRESENT
#define DMA_COUNT           1
#define VCMP_PRESENT
#define VCMP_COUNT          1
#define RTC_PRESENT
#define RTC_COUNT           1
#define HFXTAL_PRESENT
#define HFXTAL_COUNT        1
#define LFXTAL_PRESENT
#define LFXTAL_COUNT        1
#define WDOG_PRESENT
#define WDOG_COUNT          1
#define DBG_PRESENT
#define DBG_COUNT           1
#define BOOTLOADER_PRESENT
#define BOOTLOADER_COUNT    1

#include "core_cm3.h"       /* Cortex-M3 processor and core peripherals */
#include "system_efm32tg.h" /* System Header */

/** @} End of group EFM32TG108F16_Part */

/**************************************************************************//**
 * @defgroup EFM32TG108F16_Peripheral_TypeDefs EFM32TG108F16 Peripheral TypeDefs
 * @{
 * @brief Device Specific Peripheral Register Structures
 *****************************************************************************/

#include "efm32tg_msc.h"
#include "efm32tg_emu.h"
#include "efm32tg_rmu.h"

/**************************************************************************//**
 * @defgroup EFM32TG108F16_CMU EFM32TG108F16 CMU
 * @brief EFM32TG108F16_CMU Register Declaration
 * @{
 *****************************************************************************/
typedef struct
{
  __IO uint32_t CTRL;         /**< CMU Control Register  */
  __IO uint32_t HFCORECLKDIV; /**< High Frequency Core Clock Division Register  */
  __IO uint32_t HFPERCLKDIV;  /**< High Frequency Peripheral Clock Division Register  */
  __IO uint32_t HFRCOCTRL;    /**< HFRCO Control Register  */
  __IO uint32_t LFRCOCTRL;    /**< LFRCO Control Register  */
  __IO uint32_t AUXHFRCOCTRL; /**< AUXHFRCO Control Register  */
  __IO uint32_t CALCTRL;      /**< Calibration Control Register  */
  __IO uint32_t CALCNT;       /**< Calibration Counter Register  */
  __IO uint32_t OSCENCMD;     /**< Oscillator Enable/Disable Command Register  */
  __IO uint32_t CMD;          /**< Command Register  */
  __IO uint32_t LFCLKSEL;     /**< Low Frequency Clock Select Register  */
  __I uint32_t  STATUS;       /**< Status Register  */
  __I uint32_t  IF;           /**< Interrupt Flag Register  */
  __IO uint32_t IFS;          /**< Interrupt Flag Set Register  */
  __IO uint32_t IFC;          /**< Interrupt Flag Clear Register  */
  __IO uint32_t IEN;          /**< Interrupt Enable Register  */
  __IO uint32_t HFCORECLKEN0; /**< High Frequency Core Clock Enable Register 0  */
  __IO uint32_t HFPERCLKEN0;  /**< High Frequency Peripheral Clock Enable Register 0  */
  uint32_t      RESERVED0[2]; /**< Reserved for future use **/
  __I uint32_t  SYNCBUSY;     /**< Synchronization Busy Register  */
  __IO uint32_t FREEZE;       /**< Freeze Register  */
  __IO uint32_t LFACLKEN0;    /**< Low Frequency A Clock Enable Register 0  (Async Reg)  */
  uint32_t      RESERVED1[1]; /**< Reserved for future use **/
  __IO uint32_t LFBCLKEN0;    /**< Low Frequency B Clock Enable Register 0 (Async Reg)  */
  uint32_t      RESERVED2[1]; /**< Reserved for future use **/
  __IO uint32_t LFAPRESC0;    /**< Low Frequency A Prescaler Register 0 (Async Reg)  */
  uint32_t      RESERVED3[1]; /**< Reserved for future use **/
  __IO uint32_t LFBPRESC0;    /**< Low Frequency B Prescaler Register 0  (Async Reg)  */
  uint32_t      RESERVED4[1]; /**< Reserved for future use **/
  __IO uint32_t PCNTCTRL;     /**< PCNT Control Register  */

  uint32_t      RESERVED5[1]; /**< Reserved for future use **/
  __IO uint32_t ROUTE;        /**< I/O Routing Register  */
  __IO uint32_t LOCK;         /**< Configuration Lock Register  */
} CMU_TypeDef;                /** @} */

#include "efm32tg_lesense_st.h"
#include "efm32tg_lesense_buf.h"
#include "efm32tg_lesense_ch.h"
#include "efm32tg_lesense.h"
#include "efm32tg_gpio_p.h"
#include "efm32tg_gpio.h"
#include "efm32tg_prs_ch.h"

/**************************************************************************//**
 * @defgroup EFM32TG108F16_PRS EFM32TG108F16 PRS
 * @brief EFM32TG108F16_PRS Register Declaration
 * @{
 *****************************************************************************/
typedef struct
{
  __IO uint32_t  SWPULSE;      /**< Software Pulse Register  */
  __IO uint32_t  SWLEVEL;      /**< Software Level Register  */
  __IO uint32_t  ROUTE;        /**< I/O Routing Register  */

  uint32_t       RESERVED0[1]; /**< Reserved registers */

  PRS_CH_TypeDef CH[8];        /**< Channel registers */
} PRS_TypeDef;                 /** @} */

#include "efm32tg_dma_ch.h"

/**************************************************************************//**
 * @defgroup EFM32TG108F16_DMA EFM32TG108F16 DMA
 * @brief EFM32TG108F16_DMA Register Declaration
 * @{
 *****************************************************************************/
typedef struct
{
  __I uint32_t   STATUS;         /**< DMA Status Registers  */
  __O uint32_t   CONFIG;         /**< DMA Configuration Register  */
  __IO uint32_t  CTRLBASE;       /**< Channel Control Data Base Pointer Register  */
  __I uint32_t   ALTCTRLBASE;    /**< Channel Alternate Control Data Base Pointer Register  */
  __I uint32_t   CHWAITSTATUS;   /**< Channel Wait on Request Status Register  */
  __O uint32_t   CHSWREQ;        /**< Channel Software Request Register  */
  __IO uint32_t  CHUSEBURSTS;    /**< Channel Useburst Set Register  */
  __O uint32_t   CHUSEBURSTC;    /**< Channel Useburst Clear Register  */
  __IO uint32_t  CHREQMASKS;     /**< Channel Request Mask Set Register  */
  __O uint32_t   CHREQMASKC;     /**< Channel Request Mask Clear Register  */
  __IO uint32_t  CHENS;          /**< Channel Enable Set Register  */
  __O uint32_t   CHENC;          /**< Channel Enable Clear Register  */
  __IO uint32_t  CHALTS;         /**< Channel Alternate Set Register  */
  __O uint32_t   CHALTC;         /**< Channel Alternate Clear Register  */
  __IO uint32_t  CHPRIS;         /**< Channel Priority Set Register  */
  __O uint32_t   CHPRIC;         /**< Channel Priority Clear Register  */
  uint32_t       RESERVED0[3];   /**< Reserved for future use **/
  __IO uint32_t  ERRORC;         /**< Bus Error Clear Register  */
  uint32_t       RESERVED1[880]; /**< Reserved for future use **/
  __I uint32_t   CHREQSTATUS;    /**< Channel Request Status  */
  uint32_t       RESERVED2[1];   /**< Reserved for future use **/
  __I uint32_t   CHSREQSTATUS;   /**< Channel Single Request Status  */

  uint32_t       RESERVED3[121]; /**< Reserved for future use **/
  __I uint32_t   IF;             /**< Interrupt Flag Register  */
  __IO uint32_t  IFS;            /**< Interrupt Flag Set Register  */
  __IO uint32_t  IFC;            /**< Interrupt Flag Clear Register  */
  __IO uint32_t  IEN;            /**< Interrupt Enable register  */

  uint32_t       RESERVED4[60];  /**< Reserved registers */

  DMA_CH_TypeDef CH[8];          /**< Channel registers */
} DMA_TypeDef;                   /** @} */

#include "efm32tg_timer_cc.h"
#include "efm32tg_timer.h"
#include "efm32tg_usart.h"
#include "efm32tg_leuart.h"
#include "efm32tg_letimer.h"
#include "efm32tg_pcnt.h"
#include "efm32tg_i2c.h"
#include "efm32tg_acmp.h"
#include "efm32tg_vcmp.h"
#include "efm32tg_rtc.h"
#include "efm32tg_wdog.h"
#include "efm32tg_dma_descriptor.h"
#include "efm32tg_devinfo.h"
#include "efm32tg_romtable.h"
#include "efm32tg_calibrate.h"

/** @} End of group EFM32TG108F16_Peripheral_TypeDefs */

/**************************************************************************//**
 * @defgroup EFM32TG108F16_Peripheral_Base EFM32TG108F16 Peripheral Memory Map
 * @{
 *****************************************************************************/

#define MSC_BASE          (0x400C0000UL) /**< MSC base address  */
#define EMU_BASE          (0x400C6000UL) /**< EMU base address  */
#define RMU_BASE          (0x400CA000UL) /**< RMU base address  */
#define CMU_BASE          (0x400C8000UL) /**< CMU base address  */
#define LESENSE_BASE      (0x4008C000UL) /**< LESENSE base address  */
#define GPIO_BASE         (0x40006000UL) /**< GPIO base address  */
#define PRS_BASE          (0x400CC000UL) /**< PRS base address  */
#define DMA_BASE          (0x400C2000UL) /**< DMA base address  */
#define TIMER0_BASE       (0x40010000UL) /**< TIMER0 base address  */
#define TIMER1_BASE       (0x40010400UL) /**< TIMER1 base address  */
#define USART1_BASE       (0x4000C400UL) /**< USART1 base address  */
#define LEUART0_BASE      (0x40084000UL) /**< LEUART0 base address  */
#define LETIMER0_BASE     (0x40082000UL) /**< LETIMER0 base address  */
#define PCNT0_BASE        (0x40086000UL) /**< PCNT0 base address  */
#define I2C0_BASE         (0x4000A000UL) /**< I2C0 base address  */
#define ACMP0_BASE        (0x40001000UL) /**< ACMP0 base address  */
#define ACMP1_BASE        (0x40001400UL) /**< ACMP1 base address  */
#define VCMP_BASE         (0x40000000UL) /**< VCMP base address  */
#define RTC_BASE          (0x40080000UL) /**< RTC base address  */
#define WDOG_BASE         (0x40088000UL) /**< WDOG base address  */
#define CALIBRATE_BASE    (0x0FE08000UL) /**< CALIBRATE base address */
#define DEVINFO_BASE      (0x0FE081B0UL) /**< DEVINFO base address */
#define ROMTABLE_BASE     (0xE00FFFD0UL) /**< ROMTABLE base address */

/** @} End of group EFM32TG108F16_Peripheral_Base */

/**************************************************************************//**
 * @defgroup EFM32TG108F16_Peripheral_Declaration  EFM32TG108F16 Peripheral Declarations
 * @{
 *****************************************************************************/

#define MSC          ((MSC_TypeDef *) MSC_BASE)             /**< MSC base pointer */
#define EMU          ((EMU_TypeDef *) EMU_BASE)             /**< EMU base pointer */
#define RMU          ((RMU_TypeDef *) RMU_BASE)             /**< RMU base pointer */
#define CMU          ((CMU_TypeDef *) CMU_BASE)             /**< CMU base pointer */
#define LESENSE      ((LESENSE_TypeDef *) LESENSE_BASE)     /**< LESENSE base pointer */
#define GPIO         ((GPIO_TypeDef *) GPIO_BASE)           /**< GPIO base pointer */
#define PRS          ((PRS_TypeDef *) PRS_BASE)             /**< PRS base pointer */
#define DMA          ((DMA_TypeDef *) DMA_BASE)             /**< DMA base pointer */
#define TIMER0       ((TIMER_TypeDef *) TIMER0_BASE)        /**< TIMER0 base pointer */
#define TIMER1       ((TIMER_TypeDef *) TIMER1_BASE)        /**< TIMER1 base pointer */
#define USART1       ((USART_TypeDef *) USART1_BASE)        /**< USART1 base pointer */
#define LEUART0      ((LEUART_TypeDef *) LEUART0_BASE)      /**< LEUART0 base pointer */
#define LETIMER0     ((LETIMER_TypeDef *) LETIMER0_BASE)    /**< LETIMER0 base pointer */
#define PCNT0        ((PCNT_TypeDef *) PCNT0_BASE)          /**< PCNT0 base pointer */
#define I2C0         ((I2C_TypeDef *) I2C0_BASE)            /**< I2C0 base pointer */
#define ACMP0        ((ACMP_TypeDef *) ACMP0_BASE)          /**< ACMP0 base pointer */
#define ACMP1        ((ACMP_TypeDef *) ACMP1_BASE)          /**< ACMP1 base pointer */
#define VCMP         ((VCMP_TypeDef *) VCMP_BASE)           /**< VCMP base pointer */
#define RTC          ((RTC_TypeDef *) RTC_BASE)             /**< RTC base pointer */
#define WDOG         ((WDOG_TypeDef *) WDOG_BASE)           /**< WDOG base pointer */
#define CALIBRATE    ((CALIBRATE_TypeDef *) CALIBRATE_BASE) /**< CALIBRATE base pointer */
#define DEVINFO      ((DEVINFO_TypeDef *) DEVINFO_BASE)     /**< DEVINFO base pointer */
#define ROMTABLE     ((ROMTABLE_TypeDef *) ROMTABLE_BASE)   /**< ROMTABLE base pointer */

/** @} End of group EFM32TG108F16_Peripheral_Declaration */

/**************************************************************************//**
 * @defgroup EFM32TG108F16_BitFields EFM32TG108F16 Bit Fields
 * @{
 *****************************************************************************/

/**************************************************************************//**
 * @addtogroup EFM32TG108F16_PRS_Signals
 * @{
 * @brief PRS Signal names
 *****************************************************************************/

#define PRS_VCMP_OUT             ((1 << 16) + 0)  /**< PRS Voltage comparator output */
#define PRS_ACMP0_OUT            ((2 << 16) + 0)  /**< PRS Analog comparator output */
#define PRS_ACMP1_OUT            ((3 << 16) + 0)  /**< PRS Analog comparator output */
#define PRS_USART1_TXC           ((17 << 16) + 1) /**< PRS USART 1 TX complete */
#define PRS_USART1_RXDATAV       ((17 << 16) + 2) /**< PRS USART 1 RX Data Valid */
#define PRS_TIMER0_UF            ((28 << 16) + 0) /**< PRS Timer 0 Underflow */
#define PRS_TIMER0_OF            ((28 << 16) + 1) /**< PRS Timer 0 Overflow */
#define PRS_TIMER0_CC0           ((28 << 16) + 2) /**< PRS Timer 0 Compare/Capture 0 */
#define PRS_TIMER0_CC1           ((28 << 16) + 3) /**< PRS Timer 0 Compare/Capture 1 */
#define PRS_TIMER0_CC2           ((28 << 16) + 4) /**< PRS Timer 0 Compare/Capture 2 */
#define PRS_TIMER1_UF            ((29 << 16) + 0) /**< PRS Timer 1 Underflow */
#define PRS_TIMER1_OF            ((29 << 16) + 1) /**< PRS Timer 1 Overflow */
#define PRS_TIMER1_CC0           ((29 << 16) + 2) /**< PRS Timer 1 Compare/Capture 0 */
#define PRS_TIMER1_CC1           ((29 << 16) + 3) /**< PRS Timer 1 Compare/Capture 1 */
#define PRS_TIMER1_CC2           ((29 << 16) + 4) /**< PRS Timer 1 Compare/Capture 2 */
#define PRS_RTC_OF               ((40 << 16) + 0) /**< PRS RTC Overflow */
#define PRS_RTC_COMP0            ((40 << 16) + 1) /**< PRS RTC Compare 0 */
#define PRS_RTC_COMP1            ((40 << 16) + 2) /**< PRS RTC Compare 1 */
#define PRS_GPIO_PIN0            ((48 << 16) + 0) /**< PRS GPIO pin 0 */
#define PRS_GPIO_PIN1            ((48 << 16) + 1) /**< PRS GPIO pin 1 */
#define PRS_GPIO_PIN2            ((48 << 16) + 2) /**< PRS GPIO pin 2 */
#define PRS_GPIO_PIN3            ((48 << 16) + 3) /**< PRS GPIO pin 3 */
#define PRS_GPIO_PIN4            ((48 << 16) + 4) /**< PRS GPIO pin 4 */
#define PRS_GPIO_PIN5            ((48 << 16) + 5) /**< PRS GPIO pin 5 */
#define PRS_GPIO_PIN6            ((48 << 16) + 6) /**< PRS GPIO pin 6 */
#define PRS_GPIO_PIN7            ((48 << 16) + 7) /**< PRS GPIO pin 7 */
#define PRS_GPIO_PIN8            ((49 << 16) + 0) /**< PRS GPIO pin 8 */
#define PRS_GPIO_PIN9            ((49 << 16) + 1) /**< PRS GPIO pin 9 */
#define PRS_GPIO_PIN10           ((49 << 16) + 2) /**< PRS GPIO pin 10 */
#define PRS_GPIO_PIN11           ((49 << 16) + 3) /**< PRS GPIO pin 11 */
#define PRS_GPIO_PIN12           ((49 << 16) + 4) /**< PRS GPIO pin 12 */
#define PRS_GPIO_PIN13           ((49 << 16) + 5) /**< PRS GPIO pin 13 */
#define PRS_GPIO_PIN14           ((49 << 16) + 6) /**< PRS GPIO pin 14 */
#define PRS_GPIO_PIN15           ((49 << 16) + 7) /**< PRS GPIO pin 15 */
#define PRS_LETIMER0_CH0         ((52 << 16) + 0) /**< PRS LETIMER CH0 Out */
#define PRS_LETIMER0_CH1         ((52 << 16) + 1) /**< PRS LETIMER CH1 Out */
#define PRS_LESENSE_SCANRES0     ((57 << 16) + 0) /**< PRS LESENSE SCANRES register, bit 0 */
#define PRS_LESENSE_SCANRES1     ((57 << 16) + 1) /**< PRS LESENSE SCANRES register, bit 1 */
#define PRS_LESENSE_SCANRES2     ((57 << 16) + 2) /**< PRS LESENSE SCANRES register, bit 2 */
#define PRS_LESENSE_SCANRES3     ((57 << 16) + 3) /**< PRS LESENSE SCANRES register, bit 3 */
#define PRS_LESENSE_SCANRES4     ((57 << 16) + 4) /**< PRS LESENSE SCANRES register, bit 4 */
#define PRS_LESENSE_SCANRES5     ((57 << 16) + 5) /**< PRS LESENSE SCANRES register, bit 5 */
#define PRS_LESENSE_SCANRES6     ((57 << 16) + 6) /**< PRS LESENSE SCANRES register, bit 6 */
#define PRS_LESENSE_SCANRES7     ((57 << 16) + 7) /**< PRS LESENSE SCANRES register, bit 7 */
#define PRS_LESENSE_SCANRES8     ((58 << 16) + 0) /**< PRS LESENSE SCANRES register, bit 8 */
#define PRS_LESENSE_SCANRES9     ((58 << 16) + 1) /**< PRS LESENSE SCANRES register, bit 9 */
#define PRS_LESENSE_SCANRES10    ((58 << 16) + 2) /**< PRS LESENSE SCANRES register, bit 10 */
#define PRS_LESENSE_SCANRES11    ((58 << 16) + 3) /**< PRS LESENSE SCANRES register, bit 11 */
#define PRS_LESENSE_SCANRES12    ((58 << 16) + 4) /**< PRS LESENSE SCANRES register, bit 12 */
#define PRS_LESENSE_SCANRES13    ((58 << 16) + 5) /**< PRS LESENSE SCANRES register, bit 13 */
#define PRS_LESENSE_SCANRES14    ((58 << 16) + 6) /**< PRS LESENSE SCANRES register, bit 14 */
#define PRS_LESENSE_SCANRES15    ((58 << 16) + 7) /**< PRS LESENSE SCANRES register, bit 15 */
#define PRS_LESENSE_DEC0         ((59 << 16) + 0) /**< PRS LESENSE Decoder PRS out 0 */
#define PRS_LESENSE_DEC1         ((59 << 16) + 1) /**< PRS LESENSE Decoder PRS out 1 */
#define PRS_LESENSE_DEC2         ((59 << 16) + 2) /**< PRS LESENSE Decoder PRS out 2 */

/** @} End of group EFM32TG108F16_PRS */

#include "efm32tg_dmareq.h"
#include "efm32tg_dmactrl.h"

/**************************************************************************//**
 * @defgroup EFM32TG108F16_CMU_BitFields  EFM32TG108F16_CMU Bit Fields
 * @{
 *****************************************************************************/

/* Bit fields for CMU CTRL */
#define _CMU_CTRL_RESETVALUE                       0x000C262CUL                             /**< Default value for CMU_CTRL */
#define _CMU_CTRL_MASK                             0x13FE3EEFUL                             /**< Mask for CMU_CTRL */
#define _CMU_CTRL_HFXOMODE_SHIFT                   0                                        /**< Shift value for CMU_HFXOMODE */
#define _CMU_CTRL_HFXOMODE_MASK                    0x3UL                                    /**< Bit mask for CMU_HFXOMODE */
#define _CMU_CTRL_HFXOMODE_DEFAULT                 0x00000000UL                             /**< Mode DEFAULT for CMU_CTRL */
#define _CMU_CTRL_HFXOMODE_XTAL                    0x00000000UL                             /**< Mode XTAL for CMU_CTRL */
#define _CMU_CTRL_HFXOMODE_BUFEXTCLK               0x00000001UL                             /**< Mode BUFEXTCLK for CMU_CTRL */
#define _CMU_CTRL_HFXOMODE_DIGEXTCLK               0x00000002UL                             /**< Mode DIGEXTCLK for CMU_CTRL */
#define CMU_CTRL_HFXOMODE_DEFAULT                  (_CMU_CTRL_HFXOMODE_DEFAULT << 0)        /**< Shifted mode DEFAULT for CMU_CTRL */
#define CMU_CTRL_HFXOMODE_XTAL                     (_CMU_CTRL_HFXOMODE_XTAL << 0)           /**< Shifted mode XTAL for CMU_CTRL */
#define CMU_CTRL_HFXOMODE_BUFEXTCLK                (_CMU_CTRL_HFXOMODE_BUFEXTCLK << 0)      /**< Shifted mode BUFEXTCLK for CMU_CTRL */
#define CMU_CTRL_HFXOMODE_DIGEXTCLK                (_CMU_CTRL_HFXOMODE_DIGEXTCLK << 0)      /**< Shifted mode DIGEXTCLK for CMU_CTRL */
#define _CMU_CTRL_HFXOBOOST_SHIFT                  2                                        /**< Shift value for CMU_HFXOBOOST */
#define _CMU_CTRL_HFXOBOOST_MASK                   0xCUL                                    /**< Bit mask for CMU_HFXOBOOST */
#define _CMU_CTRL_HFXOBOOST_50PCENT                0x00000000UL                             /**< Mode 50PCENT for CMU_CTRL */
#define _CMU_CTRL_HFXOBOOST_70PCENT                0x00000001UL                             /**< Mode 70PCENT for CMU_CTRL */
#define _CMU_CTRL_HFXOBOOST_80PCENT                0x00000002UL                             /**< Mode 80PCENT for CMU_CTRL */
#define _CMU_CTRL_HFXOBOOST_DEFAULT                0x00000003UL                             /**< Mode DEFAULT for CMU_CTRL */
#define _CMU_CTRL_HFXOBOOST_100PCENT               0x00000003UL                             /**< Mode 100PCENT for CMU_CTRL */
#define CMU_CTRL_HFXOBOOST_50PCENT                 (_CMU_CTRL_HFXOBOOST_50PCENT << 2)       /**< Shifted mode 50PCENT for CMU_CTRL */
#define CMU_CTRL_HFXOBOOST_70PCENT                 (_CMU_CTRL_HFXOBOOST_70PCENT << 2)       /**< Shifted mode 70PCENT for CMU_CTRL */
#define CMU_CTRL_HFXOBOOST_80PCENT                 (_CMU_CTRL_HFXOBOOST_80PCENT << 2)       /**< Shifted mode 80PCENT for CMU_CTRL */
#define CMU_CTRL_HFXOBOOST_DEFAULT                 (_CMU_CTRL_HFXOBOOST_DEFAULT << 2)       /**< Shifted mode DEFAULT for CMU_CTRL */
#define CMU_CTRL_HFXOBOOST_100PCENT                (_CMU_CTRL_HFXOBOOST_100PCENT << 2)      /**< Shifted mode 100PCENT for CMU_CTRL */
#define _CMU_CTRL_HFXOBUFCUR_SHIFT                 5                                        /**< Shift value for CMU_HFXOBUFCUR */
#define _CMU_CTRL_HFXOBUFCUR_MASK                  0x60UL                                   /**< Bit mask for CMU_HFXOBUFCUR */
#define _CMU_CTRL_HFXOBUFCUR_DEFAULT               0x00000001UL                             /**< Mode DEFAULT for CMU_CTRL */
#define CMU_CTRL_HFXOBUFCUR_DEFAULT                (_CMU_CTRL_HFXOBUFCUR_DEFAULT << 5)      /**< Shifted mode DEFAULT for CMU_CTRL */
#define CMU_CTRL_HFXOGLITCHDETEN                   (0x1UL << 7)                             /**< HFXO Glitch Detector Enable */
#define _CMU_CTRL_HFXOGLITCHDETEN_SHIFT            7                                        /**< Shift value for CMU_HFXOGLITCHDETEN */
#define _CMU_CTRL_HFXOGLITCHDETEN_MASK             0x80UL                                   /**< Bit mask for CMU_HFXOGLITCHDETEN */
#define _CMU_CTRL_HFXOGLITCHDETEN_DEFAULT          0x00000000UL                             /**< Mode DEFAULT for CMU_CTRL */
#define CMU_CTRL_HFXOGLITCHDETEN_DEFAULT           (_CMU_CTRL_HFXOGLITCHDETEN_DEFAULT << 7) /**< Shifted mode DEFAULT for CMU_CTRL */
#define _CMU_CTRL_HFXOTIMEOUT_SHIFT                9                                        /**< Shift value for CMU_HFXOTIMEOUT */
#define _CMU_CTRL_HFXOTIMEOUT_MASK                 0x600UL                                  /**< Bit mask for CMU_HFXOTIMEOUT */
#define _CMU_CTRL_HFXOTIMEOUT_8CYCLES              0x00000000UL                             /**< Mode 8CYCLES for CMU_CTRL */
#define _CMU_CTRL_HFXOTIMEOUT_256CYCLES            0x00000001UL                             /**< Mode 256CYCLES for CMU_CTRL */
#define _CMU_CTRL_HFXOTIMEOUT_1KCYCLES             0x00000002UL                             /**< Mode 1KCYCLES for CMU_CTRL */
#define _CMU_CTRL_HFXOTIMEOUT_DEFAULT              0x00000003UL                             /**< Mode DEFAULT for CMU_CTRL */
#define _CMU_CTRL_HFXOTIMEOUT_16KCYCLES            0x00000003UL                             /**< Mode 16KCYCLES for CMU_CTRL */
#define CMU_CTRL_HFXOTIMEOUT_8CYCLES               (_CMU_CTRL_HFXOTIMEOUT_8CYCLES << 9)     /**< Shifted mode 8CYCLES for CMU_CTRL */
#define CMU_CTRL_HFXOTIMEOUT_256CYCLES             (_CMU_CTRL_HFXOTIMEOUT_256CYCLES << 9)   /**< Shifted mode 256CYCLES for CMU_CTRL */
#define CMU_CTRL_HFXOTIMEOUT_1KCYCLES              (_CMU_CTRL_HFXOTIMEOUT_1KCYCLES << 9)    /**< Shifted mode 1KCYCLES for CMU_CTRL */
#define CMU_CTRL_HFXOTIMEOUT_DEFAULT               (_CMU_CTRL_HFXOTIMEOUT_DEFAULT << 9)     /**< Shifted mode DEFAULT for CMU_CTRL */
#define CMU_CTRL_HFXOTIMEOUT_16KCYCLES             (_CMU_CTRL_HFXOTIMEOUT_16KCYCLES << 9)   /**< Shifted mode 16KCYCLES for CMU_CTRL */
#define _CMU_CTRL_LFXOMODE_SHIFT                   11                                       /**< Shift value for CMU_LFXOMODE */
#define _CMU_CTRL_LFXOMODE_MASK                    0x1800UL                                 /**< Bit mask for CMU_LFXOMODE */
#define _CMU_CTRL_LFXOMODE_DEFAULT                 0x00000000UL                             /**< Mode DEFAULT for CMU_CTRL */
#define _CMU_CTRL_LFXOMODE_XTAL                    0x00000000UL                             /**< Mode XTAL for CMU_CTRL */
#define _CMU_CTRL_LFXOMODE_BUFEXTCLK               0x00000001UL                             /**< Mode BUFEXTCLK for CMU_CTRL */
#define _CMU_CTRL_LFXOMODE_DIGEXTCLK               0x00000002UL                             /**< Mode DIGEXTCLK for CMU_CTRL */
#define CMU_CTRL_LFXOMODE_DEFAULT                  (_CMU_CTRL_LFXOMODE_DEFAULT << 11)       /**< Shifted mode DEFAULT for CMU_CTRL */
#define CMU_CTRL_LFXOMODE_XTAL                     (_CMU_CTRL_LFXOMODE_XTAL << 11)          /**< Shifted mode XTAL for CMU_CTRL */
#define CMU_CTRL_LFXOMODE_BUFEXTCLK                (_CMU_CTRL_LFXOMODE_BUFEXTCLK << 11)     /**< Shifted mode BUFEXTCLK for CMU_CTRL */
#define CMU_CTRL_LFXOMODE_DIGEXTCLK                (_CMU_CTRL_LFXOMODE_DIGEXTCLK << 11)     /**< Shifted mode DIGEXTCLK for CMU_CTRL */
#define CMU_CTRL_LFXOBOOST                         (0x1UL << 13)                            /**< LFXO Start-up Boost Current */
#define _CMU_CTRL_LFXOBOOST_SHIFT                  13                                       /**< Shift value for CMU_LFXOBOOST */
#define _CMU_CTRL_LFXOBOOST_MASK                   0x2000UL                                 /**< Bit mask for CMU_LFXOBOOST */
#define _CMU_CTRL_LFXOBOOST_70PCENT                0x00000000UL                             /**< Mode 70PCENT for CMU_CTRL */
#define _CMU_CTRL_LFXOBOOST_DEFAULT                0x00000001UL                             /**< Mode DEFAULT for CMU_CTRL */
#define _CMU_CTRL_LFXOBOOST_100PCENT               0x00000001UL                             /**< Mode 100PCENT for CMU_CTRL */
#define CMU_CTRL_LFXOBOOST_70PCENT                 (_CMU_CTRL_LFXOBOOST_70PCENT << 13)      /**< Shifted mode 70PCENT for CMU_CTRL */
#define CMU_CTRL_LFXOBOOST_DEFAULT                 (_CMU_CTRL_LFXOBOOST_DEFAULT << 13)      /**< Shifted mode DEFAULT for CMU_CTRL */
#define CMU_CTRL_LFXOBOOST_100PCENT                (_CMU_CTRL_LFXOBOOST_100PCENT << 13)     /**< Shifted mode 100PCENT for CMU_CTRL */
#define CMU_CTRL_LFXOBUFCUR                        (0x1UL << 17)                            /**< LFXO Boost Buffer Current */
#define _CMU_CTRL_LFXOBUFCUR_SHIFT                 17                                       /**< Shift value for CMU_LFXOBUFCUR */
#define _CMU_CTRL_LFXOBUFCUR_MASK                  0x20000UL                                /**< Bit mask for CMU_LFXOBUFCUR */
#define _CMU_CTRL_LFXOBUFCUR_DEFAULT               0x00000000UL                             /**< Mode DEFAULT for CMU_CTRL */
#define CMU_CTRL_LFXOBUFCUR_DEFAULT                (_CMU_CTRL_LFXOBUFCUR_DEFAULT << 17)     /**< Shifted mode DEFAULT for CMU_CTRL */
#define _CMU_CTRL_LFXOTIMEOUT_SHIFT                18                                       /**< Shift value for CMU_LFXOTIMEOUT */
#define _CMU_CTRL_LFXOTIMEOUT_MASK                 0xC0000UL                                /**< Bit mask for CMU_LFXOTIMEOUT */
#define _CMU_CTRL_LFXOTIMEOUT_8CYCLES              0x00000000UL                             /**< Mode 8CYCLES for CMU_CTRL */
#define _CMU_CTRL_LFXOTIMEOUT_1KCYCLES             0x00000001UL                             /**< Mode 1KCYCLES for CMU_CTRL */
#define _CMU_CTRL_LFXOTIMEOUT_16KCYCLES            0x00000002UL                             /**< Mode 16KCYCLES for CMU_CTRL */
#define _CMU_CTRL_LFXOTIMEOUT_DEFAULT              0x00000003UL                             /**< Mode DEFAULT for CMU_CTRL */
#define _CMU_CTRL_LFXOTIMEOUT_32KCYCLES            0x00000003UL                             /**< Mode 32KCYCLES for CMU_CTRL */
#define CMU_CTRL_LFXOTIMEOUT_8CYCLES               (_CMU_CTRL_LFXOTIMEOUT_8CYCLES << 18)    /**< Shifted mode 8CYCLES for CMU_CTRL */
#define CMU_CTRL_LFXOTIMEOUT_1KCYCLES              (_CMU_CTRL_LFXOTIMEOUT_1KCYCLES << 18)   /**< Shifted mode 1KCYCLES for CMU_CTRL */
#define CMU_CTRL_LFXOTIMEOUT_16KCYCLES             (_CMU_CTRL_LFXOTIMEOUT_16KCYCLES << 18)  /**< Shifted mode 16KCYCLES for CMU_CTRL */
#define CMU_CTRL_LFXOTIMEOUT_DEFAULT               (_CMU_CTRL_LFXOTIMEOUT_DEFAULT << 18)    /**< Shifted mode DEFAULT for CMU_CTRL */
#define CMU_CTRL_LFXOTIMEOUT_32KCYCLES             (_CMU_CTRL_LFXOTIMEOUT_32KCYCLES << 18)  /**< Shifted mode 32KCYCLES for CMU_CTRL */
#define _CMU_CTRL_CLKOUTSEL0_SHIFT                 20                                       /**< Shift value for CMU_CLKOUTSEL0 */
#define _CMU_CTRL_CLKOUTSEL0_MASK                  0x700000UL                               /**< Bit mask for CMU_CLKOUTSEL0 */
#define _CMU_CTRL_CLKOUTSEL0_DEFAULT               0x00000000UL                             /**< Mode DEFAULT for CMU_CTRL */
#define _CMU_CTRL_CLKOUTSEL0_HFRCO                 0x00000000UL                             /**< Mode HFRCO for CMU_CTRL */
#define _CMU_CTRL_CLKOUTSEL0_HFXO                  0x00000001UL                             /**< Mode HFXO for CMU_CTRL */
#define _CMU_CTRL_CLKOUTSEL0_HFCLK2                0x00000002UL                             /**< Mode HFCLK2 for CMU_CTRL */
#define _CMU_CTRL_CLKOUTSEL0_HFCLK4                0x00000003UL                             /**< Mode HFCLK4 for CMU_CTRL */
#define _CMU_CTRL_CLKOUTSEL0_HFCLK8                0x00000004UL                             /**< Mode HFCLK8 for CMU_CTRL */
#define _CMU_CTRL_CLKOUTSEL0_HFCLK16               0x00000005UL                             /**< Mode HFCLK16 for CMU_CTRL */
#define _CMU_CTRL_CLKOUTSEL0_ULFRCO                0x00000006UL                             /**< Mode ULFRCO for CMU_CTRL */
#define _CMU_CTRL_CLKOUTSEL0_AUXHFRCO              0x00000007UL                             /**< Mode AUXHFRCO for CMU_CTRL */
#define CMU_CTRL_CLKOUTSEL0_DEFAULT                (_CMU_CTRL_CLKOUTSEL0_DEFAULT << 20)     /**< Shifted mode DEFAULT for CMU_CTRL */
#define CMU_CTRL_CLKOUTSEL0_HFRCO                  (_CMU_CTRL_CLKOUTSEL0_HFRCO << 20)       /**< Shifted mode HFRCO for CMU_CTRL */
#define CMU_CTRL_CLKOUTSEL0_HFXO                   (_CMU_CTRL_CLKOUTSEL0_HFXO << 20)        /**< Shifted mode HFXO for CMU_CTRL */
#define CMU_CTRL_CLKOUTSEL0_HFCLK2                 (_CMU_CTRL_CLKOUTSEL0_HFCLK2 << 20)      /**< Shifted mode HFCLK2 for CMU_CTRL */
#define CMU_CTRL_CLKOUTSEL0_HFCLK4                 (_CMU_CTRL_CLKOUTSEL0_HFCLK4 << 20)      /**< Shifted mode HFCLK4 for CMU_CTRL */
#define CMU_CTRL_CLKOUTSEL0_HFCLK8                 (_CMU_CTRL_CLKOUTSEL0_HFCLK8 << 20)      /**< Shifted mode HFCLK8 for CMU_CTRL */
#define CMU_CTRL_CLKOUTSEL0_HFCLK16                (_CMU_CTRL_CLKOUTSEL0_HFCLK16 << 20)     /**< Shifted mode HFCLK16 for CMU_CTRL */
#define CMU_CTRL_CLKOUTSEL0_ULFRCO                 (_CMU_CTRL_CLKOUTSEL0_ULFRCO << 20)      /**< Shifted mode ULFRCO for CMU_CTRL */
#define CMU_CTRL_CLKOUTSEL0_AUXHFRCO               (_CMU_CTRL_CLKOUTSEL0_AUXHFRCO << 20)    /**< Shifted mode AUXHFRCO for CMU_CTRL */
#define _CMU_CTRL_CLKOUTSEL1_SHIFT                 23                                       /**< Shift value for CMU_CLKOUTSEL1 */
#define _CMU_CTRL_CLKOUTSEL1_MASK                  0x3800000UL                              /**< Bit mask for CMU_CLKOUTSEL1 */
#define _CMU_CTRL_CLKOUTSEL1_DEFAULT               0x00000000UL                             /**< Mode DEFAULT for CMU_CTRL */
#define _CMU_CTRL_CLKOUTSEL1_LFRCO                 0x00000000UL                             /**< Mode LFRCO for CMU_CTRL */
#define _CMU_CTRL_CLKOUTSEL1_LFXO                  0x00000001UL                             /**< Mode LFXO for CMU_CTRL */
#define _CMU_CTRL_CLKOUTSEL1_HFCLK                 0x00000002UL                             /**< Mode HFCLK for CMU_CTRL */
#define _CMU_CTRL_CLKOUTSEL1_LFXOQ                 0x00000003UL                             /**< Mode LFXOQ for CMU_CTRL */
#define _CMU_CTRL_CLKOUTSEL1_HFXOQ                 0x00000004UL                             /**< Mode HFXOQ for CMU_CTRL */
#define _CMU_CTRL_CLKOUTSEL1_LFRCOQ                0x00000005UL                             /**< Mode LFRCOQ for CMU_CTRL */
#define _CMU_CTRL_CLKOUTSEL1_HFRCOQ                0x00000006UL                             /**< Mode HFRCOQ for CMU_CTRL */
#define _CMU_CTRL_CLKOUTSEL1_AUXHFRCOQ             0x00000007UL                             /**< Mode AUXHFRCOQ for CMU_CTRL */
#define CMU_CTRL_CLKOUTSEL1_DEFAULT                (_CMU_CTRL_CLKOUTSEL1_DEFAULT << 23)     /**< Shifted mode DEFAULT for CMU_CTRL */
#define CMU_CTRL_CLKOUTSEL1_LFRCO                  (_CMU_CTRL_CLKOUTSEL1_LFRCO << 23)       /**< Shifted mode LFRCO for CMU_CTRL */
#define CMU_CTRL_CLKOUTSEL1_LFXO                   (_CMU_CTRL_CLKOUTSEL1_LFXO << 23)        /**< Shifted mode LFXO for CMU_CTRL */
#define CMU_CTRL_CLKOUTSEL1_HFCLK                  (_CMU_CTRL_CLKOUTSEL1_HFCLK << 23)       /**< Shifted mode HFCLK for CMU_CTRL */
#define CMU_CTRL_CLKOUTSEL1_LFXOQ                  (_CMU_CTRL_CLKOUTSEL1_LFXOQ << 23)       /**< Shifted mode LFXOQ for CMU_CTRL */
#define CMU_CTRL_CLKOUTSEL1_HFXOQ                  (_CMU_CTRL_CLKOUTSEL1_HFXOQ << 23)       /**< Shifted mode HFXOQ for CMU_CTRL */
#define CMU_CTRL_CLKOUTSEL1_LFRCOQ                 (_CMU_CTRL_CLKOUTSEL1_LFRCOQ << 23)      /**< Shifted mode LFRCOQ for CMU_CTRL */
#define CMU_CTRL_CLKOUTSEL1_HFRCOQ                 (_CMU_CTRL_CLKOUTSEL1_HFRCOQ << 23)      /**< Shifted mode HFRCOQ for CMU_CTRL */
#define CMU_CTRL_CLKOUTSEL1_AUXHFRCOQ              (_CMU_CTRL_CLKOUTSEL1_AUXHFRCOQ << 23)   /**< Shifted mode AUXHFRCOQ for CMU_CTRL */
#define CMU_CTRL_DBGCLK                            (0x1UL << 28)                            /**< Debug Clock */
#define _CMU_CTRL_DBGCLK_SHIFT                     28                                       /**< Shift value for CMU_DBGCLK */
#define _CMU_CTRL_DBGCLK_MASK                      0x10000000UL                             /**< Bit mask for CMU_DBGCLK */
#define _CMU_CTRL_DBGCLK_DEFAULT                   0x00000000UL                             /**< Mode DEFAULT for CMU_CTRL */
#define _CMU_CTRL_DBGCLK_AUXHFRCO                  0x00000000UL                             /**< Mode AUXHFRCO for CMU_CTRL */
#define _CMU_CTRL_DBGCLK_HFCLK                     0x00000001UL                             /**< Mode HFCLK for CMU_CTRL */
#define CMU_CTRL_DBGCLK_DEFAULT                    (_CMU_CTRL_DBGCLK_DEFAULT << 28)         /**< Shifted mode DEFAULT for CMU_CTRL */
#define CMU_CTRL_DBGCLK_AUXHFRCO                   (_CMU_CTRL_DBGCLK_AUXHFRCO << 28)        /**< Shifted mode AUXHFRCO for CMU_CTRL */
#define CMU_CTRL_DBGCLK_HFCLK                      (_CMU_CTRL_DBGCLK_HFCLK << 28)           /**< Shifted mode HFCLK for CMU_CTRL */

/* Bit fields for CMU HFCORECLKDIV */
#define _CMU_HFCORECLKDIV_RESETVALUE               0x00000000UL                                   /**< Default value for CMU_HFCORECLKDIV */
#define _CMU_HFCORECLKDIV_MASK                     0x0000000FUL                                   /**< Mask for CMU_HFCORECLKDIV */
#define _CMU_HFCORECLKDIV_HFCORECLKDIV_SHIFT       0                                              /**< Shift value for CMU_HFCORECLKDIV */
#define _CMU_HFCORECLKDIV_HFCORECLKDIV_MASK        0xFUL                                          /**< Bit mask for CMU_HFCORECLKDIV */
#define _CMU_HFCORECLKDIV_HFCORECLKDIV_DEFAULT     0x00000000UL                                   /**< Mode DEFAULT for CMU_HFCORECLKDIV */
#define _CMU_HFCORECLKDIV_HFCORECLKDIV_HFCLK       0x00000000UL                                   /**< Mode HFCLK for CMU_HFCORECLKDIV */
#define _CMU_HFCORECLKDIV_HFCORECLKDIV_HFCLK2      0x00000001UL                                   /**< Mode HFCLK2 for CMU_HFCORECLKDIV */
#define _CMU_HFCORECLKDIV_HFCORECLKDIV_HFCLK4      0x00000002UL                                   /**< Mode HFCLK4 for CMU_HFCORECLKDIV */
#define _CMU_HFCORECLKDIV_HFCORECLKDIV_HFCLK8      0x00000003UL                                   /**< Mode HFCLK8 for CMU_HFCORECLKDIV */
#define _CMU_HFCORECLKDIV_HFCORECLKDIV_HFCLK16     0x00000004UL                                   /**< Mode HFCLK16 for CMU_HFCORECLKDIV */
#define _CMU_HFCORECLKDIV_HFCORECLKDIV_HFCLK32     0x00000005UL                                   /**< Mode HFCLK32 for CMU_HFCORECLKDIV */
#define _CMU_HFCORECLKDIV_HFCORECLKDIV_HFCLK64     0x00000006UL                                   /**< Mode HFCLK64 for CMU_HFCORECLKDIV */
#define _CMU_HFCORECLKDIV_HFCORECLKDIV_HFCLK128    0x00000007UL                                   /**< Mode HFCLK128 for CMU_HFCORECLKDIV */
#define _CMU_HFCORECLKDIV_HFCORECLKDIV_HFCLK256    0x00000008UL                                   /**< Mode HFCLK256 for CMU_HFCORECLKDIV */
#define _CMU_HFCORECLKDIV_HFCORECLKDIV_HFCLK512    0x00000009UL                                   /**< Mode HFCLK512 for CMU_HFCORECLKDIV */
#define CMU_HFCORECLKDIV_HFCORECLKDIV_DEFAULT      (_CMU_HFCORECLKDIV_HFCORECLKDIV_DEFAULT << 0)  /**< Shifted mode DEFAULT for CMU_HFCORECLKDIV */
#define CMU_HFCORECLKDIV_HFCORECLKDIV_HFCLK        (_CMU_HFCORECLKDIV_HFCORECLKDIV_HFCLK << 0)    /**< Shifted mode HFCLK for CMU_HFCORECLKDIV */
#define CMU_HFCORECLKDIV_HFCORECLKDIV_HFCLK2       (_CMU_HFCORECLKDIV_HFCORECLKDIV_HFCLK2 << 0)   /**< Shifted mode HFCLK2 for CMU_HFCORECLKDIV */
#define CMU_HFCORECLKDIV_HFCORECLKDIV_HFCLK4       (_CMU_HFCORECLKDIV_HFCORECLKDIV_HFCLK4 << 0)   /**< Shifted mode HFCLK4 for CMU_HFCORECLKDIV */
#define CMU_HFCORECLKDIV_HFCORECLKDIV_HFCLK8       (_CMU_HFCORECLKDIV_HFCORECLKDIV_HFCLK8 << 0)   /**< Shifted mode HFCLK8 for CMU_HFCORECLKDIV */
#define CMU_HFCORECLKDIV_HFCORECLKDIV_HFCLK16      (_CMU_HFCORECLKDIV_HFCORECLKDIV_HFCLK16 << 0)  /**< Shifted mode HFCLK16 for CMU_HFCORECLKDIV */
#define CMU_HFCORECLKDIV_HFCORECLKDIV_HFCLK32      (_CMU_HFCORECLKDIV_HFCORECLKDIV_HFCLK32 << 0)  /**< Shifted mode HFCLK32 for CMU_HFCORECLKDIV */
#define CMU_HFCORECLKDIV_HFCORECLKDIV_HFCLK64      (_CMU_HFCORECLKDIV_HFCORECLKDIV_HFCLK64 << 0)  /**< Shifted mode HFCLK64 for CMU_HFCORECLKDIV */
#define CMU_HFCORECLKDIV_HFCORECLKDIV_HFCLK128     (_CMU_HFCORECLKDIV_HFCORECLKDIV_HFCLK128 << 0) /**< Shifted mode HFCLK128 for CMU_HFCORECLKDIV */
#define CMU_HFCORECLKDIV_HFCORECLKDIV_HFCLK256     (_CMU_HFCORECLKDIV_HFCORECLKDIV_HFCLK256 << 0) /**< Shifted mode HFCLK256 for CMU_HFCORECLKDIV */
#define CMU_HFCORECLKDIV_HFCORECLKDIV_HFCLK512     (_CMU_HFCORECLKDIV_HFCORECLKDIV_HFCLK512 << 0) /**< Shifted mode HFCLK512 for CMU_HFCORECLKDIV */

/* Bit fields for CMU HFPERCLKDIV */
#define _CMU_HFPERCLKDIV_RESETVALUE                0x00000100UL                                 /**< Default value for CMU_HFPERCLKDIV */
#define _CMU_HFPERCLKDIV_MASK                      0x0000010FUL                                 /**< Mask for CMU_HFPERCLKDIV */
#define _CMU_HFPERCLKDIV_HFPERCLKDIV_SHIFT         0                                            /**< Shift value for CMU_HFPERCLKDIV */
#define _CMU_HFPERCLKDIV_HFPERCLKDIV_MASK          0xFUL                                        /**< Bit mask for CMU_HFPERCLKDIV */
#define _CMU_HFPERCLKDIV_HFPERCLKDIV_DEFAULT       0x00000000UL                                 /**< Mode DEFAULT for CMU_HFPERCLKDIV */
#define _CMU_HFPERCLKDIV_HFPERCLKDIV_HFCLK         0x00000000UL                                 /**< Mode HFCLK for CMU_HFPERCLKDIV */
#define _CMU_HFPERCLKDIV_HFPERCLKDIV_HFCLK2        0x00000001UL                                 /**< Mode HFCLK2 for CMU_HFPERCLKDIV */
#define _CMU_HFPERCLKDIV_HFPERCLKDIV_HFCLK4        0x00000002UL                                 /**< Mode HFCLK4 for CMU_HFPERCLKDIV */
#define _CMU_HFPERCLKDIV_HFPERCLKDIV_HFCLK8        0x00000003UL                                 /**< Mode HFCLK8 for CMU_HFPERCLKDIV */
#define _CMU_HFPERCLKDIV_HFPERCLKDIV_HFCLK16       0x00000004UL                                 /**< Mode HFCLK16 for CMU_HFPERCLKDIV */
#define _CMU_HFPERCLKDIV_HFPERCLKDIV_HFCLK32       0x00000005UL                                 /**< Mode HFCLK32 for CMU_HFPERCLKDIV */
#define _CMU_HFPERCLKDIV_HFPERCLKDIV_HFCLK64       0x00000006UL                                 /**< Mode HFCLK64 for CMU_HFPERCLKDIV */
#define _CMU_HFPERCLKDIV_HFPERCLKDIV_HFCLK128      0x00000007UL                                 /**< Mode HFCLK128 for CMU_HFPERCLKDIV */
#define _CMU_HFPERCLKDIV_HFPERCLKDIV_HFCLK256      0x00000008UL                                 /**< Mode HFCLK256 for CMU_HFPERCLKDIV */
#define _CMU_HFPERCLKDIV_HFPERCLKDIV_HFCLK512      0x00000009UL                                 /**< Mode HFCLK512 for CMU_HFPERCLKDIV */
#define CMU_HFPERCLKDIV_HFPERCLKDIV_DEFAULT        (_CMU_HFPERCLKDIV_HFPERCLKDIV_DEFAULT << 0)  /**< Shifted mode DEFAULT for CMU_HFPERCLKDIV */
#define CMU_HFPERCLKDIV_HFPERCLKDIV_HFCLK          (_CMU_HFPERCLKDIV_HFPERCLKDIV_HFCLK << 0)    /**< Shifted mode HFCLK for CMU_HFPERCLKDIV */
#define CMU_HFPERCLKDIV_HFPERCLKDIV_HFCLK2         (_CMU_HFPERCLKDIV_HFPERCLKDIV_HFCLK2 << 0)   /**< Shifted mode HFCLK2 for CMU_HFPERCLKDIV */
#define CMU_HFPERCLKDIV_HFPERCLKDIV_HFCLK4         (_CMU_HFPERCLKDIV_HFPERCLKDIV_HFCLK4 << 0)   /**< Shifted mode HFCLK4 for CMU_HFPERCLKDIV */
#define CMU_HFPERCLKDIV_HFPERCLKDIV_HFCLK8         (_CMU_HFPERCLKDIV_HFPERCLKDIV_HFCLK8 << 0)   /**< Shifted mode HFCLK8 for CMU_HFPERCLKDIV */
#define CMU_HFPERCLKDIV_HFPERCLKDIV_HFCLK16        (_CMU_HFPERCLKDIV_HFPERCLKDIV_HFCLK16 << 0)  /**< Shifted mode HFCLK16 for CMU_HFPERCLKDIV */
#define CMU_HFPERCLKDIV_HFPERCLKDIV_HFCLK32        (_CMU_HFPERCLKDIV_HFPERCLKDIV_HFCLK32 << 0)  /**< Shifted mode HFCLK32 for CMU_HFPERCLKDIV */
#define CMU_HFPERCLKDIV_HFPERCLKDIV_HFCLK64        (_CMU_HFPERCLKDIV_HFPERCLKDIV_HFCLK64 << 0)  /**< Shifted mode HFCLK64 for CMU_HFPERCLKDIV */
#define CMU_HFPERCLKDIV_HFPERCLKDIV_HFCLK128       (_CMU_HFPERCLKDIV_HFPERCLKDIV_HFCLK128 << 0) /**< Shifted mode HFCLK128 for CMU_HFPERCLKDIV */
#define CMU_HFPERCLKDIV_HFPERCLKDIV_HFCLK256       (_CMU_HFPERCLKDIV_HFPERCLKDIV_HFCLK256 << 0) /**< Shifted mode HFCLK256 for CMU_HFPERCLKDIV */
#define CMU_HFPERCLKDIV_HFPERCLKDIV_HFCLK512       (_CMU_HFPERCLKDIV_HFPERCLKDIV_HFCLK512 << 0) /**< Shifted mode HFCLK512 for CMU_HFPERCLKDIV */
#define CMU_HFPERCLKDIV_HFPERCLKEN                 (0x1UL << 8)                                 /**< HFPERCLK Enable */
#define _CMU_HFPERCLKDIV_HFPERCLKEN_SHIFT          8                                            /**< Shift value for CMU_HFPERCLKEN */
#define _CMU_HFPERCLKDIV_HFPERCLKEN_MASK           0x100UL                                      /**< Bit mask for CMU_HFPERCLKEN */
#define _CMU_HFPERCLKDIV_HFPERCLKEN_DEFAULT        0x00000001UL                                 /**< Mode DEFAULT for CMU_HFPERCLKDIV */
#define CMU_HFPERCLKDIV_HFPERCLKEN_DEFAULT         (_CMU_HFPERCLKDIV_HFPERCLKEN_DEFAULT << 8)   /**< Shifted mode DEFAULT for CMU_HFPERCLKDIV */

/* Bit fields for CMU HFRCOCTRL */
#define _CMU_HFRCOCTRL_RESETVALUE                  0x00000380UL                           /**< Default value for CMU_HFRCOCTRL */
#define _CMU_HFRCOCTRL_MASK                        0x0001F7FFUL                           /**< Mask for CMU_HFRCOCTRL */
#define _CMU_HFRCOCTRL_TUNING_SHIFT                0                                      /**< Shift value for CMU_TUNING */
#define _CMU_HFRCOCTRL_TUNING_MASK                 0xFFUL                                 /**< Bit mask for CMU_TUNING */
#define _CMU_HFRCOCTRL_TUNING_DEFAULT              0x00000080UL                           /**< Mode DEFAULT for CMU_HFRCOCTRL */
#define CMU_HFRCOCTRL_TUNING_DEFAULT               (_CMU_HFRCOCTRL_TUNING_DEFAULT << 0)   /**< Shifted mode DEFAULT for CMU_HFRCOCTRL */
#define _CMU_HFRCOCTRL_BAND_SHIFT                  8                                      /**< Shift value for CMU_BAND */
#define _CMU_HFRCOCTRL_BAND_MASK                   0x700UL                                /**< Bit mask for CMU_BAND */
#define _CMU_HFRCOCTRL_BAND_1MHZ                   0x00000000UL                           /**< Mode 1MHZ for CMU_HFRCOCTRL */
#define _CMU_HFRCOCTRL_BAND_7MHZ                   0x00000001UL                           /**< Mode 7MHZ for CMU_HFRCOCTRL */
#define _CMU_HFRCOCTRL_BAND_11MHZ                  0x00000002UL                           /**< Mode 11MHZ for CMU_HFRCOCTRL */
#define _CMU_HFRCOCTRL_BAND_DEFAULT                0x00000003UL                           /**< Mode DEFAULT for CMU_HFRCOCTRL */
#define _CMU_HFRCOCTRL_BAND_14MHZ                  0x00000003UL                           /**< Mode 14MHZ for CMU_HFRCOCTRL */
#define _CMU_HFRCOCTRL_BAND_21MHZ                  0x00000004UL                           /**< Mode 21MHZ for CMU_HFRCOCTRL */
#define _CMU_HFRCOCTRL_BAND_28MHZ                  0x00000005UL                           /**< Mode 28MHZ for CMU_HFRCOCTRL */
#define CMU_HFRCOCTRL_BAND_1MHZ                    (_CMU_HFRCOCTRL_BAND_1MHZ << 8)        /**< Shifted mode 1MHZ for CMU_HFRCOCTRL */
#define CMU_HFRCOCTRL_BAND_7MHZ                    (_CMU_HFRCOCTRL_BAND_7MHZ << 8)        /**< Shifted mode 7MHZ for CMU_HFRCOCTRL */
#define CMU_HFRCOCTRL_BAND_11MHZ                   (_CMU_HFRCOCTRL_BAND_11MHZ << 8)       /**< Shifted mode 11MHZ for CMU_HFRCOCTRL */
#define CMU_HFRCOCTRL_BAND_DEFAULT                 (_CMU_HFRCOCTRL_BAND_DEFAULT << 8)     /**< Shifted mode DEFAULT for CMU_HFRCOCTRL */
#define CMU_HFRCOCTRL_BAND_14MHZ                   (_CMU_HFRCOCTRL_BAND_14MHZ << 8)       /**< Shifted mode 14MHZ for CMU_HFRCOCTRL */
#define CMU_HFRCOCTRL_BAND_21MHZ                   (_CMU_HFRCOCTRL_BAND_21MHZ << 8)       /**< Shifted mode 21MHZ for CMU_HFRCOCTRL */
#define CMU_HFRCOCTRL_BAND_28MHZ                   (_CMU_HFRCOCTRL_BAND_28MHZ << 8)       /**< Shifted mode 28MHZ for CMU_HFRCOCTRL */
#define _CMU_HFRCOCTRL_SUDELAY_SHIFT               12                                     /**< Shift value for CMU_SUDELAY */
#define _CMU_HFRCOCTRL_SUDELAY_MASK                0x1F000UL                              /**< Bit mask for CMU_SUDELAY */
#define _CMU_HFRCOCTRL_SUDELAY_DEFAULT             0x00000000UL                           /**< Mode DEFAULT for CMU_HFRCOCTRL */
#define CMU_HFRCOCTRL_SUDELAY_DEFAULT              (_CMU_HFRCOCTRL_SUDELAY_DEFAULT << 12) /**< Shifted mode DEFAULT for CMU_HFRCOCTRL */

/* Bit fields for CMU LFRCOCTRL */
#define _CMU_LFRCOCTRL_RESETVALUE                  0x00000040UL                         /**< Default value for CMU_LFRCOCTRL */
#define _CMU_LFRCOCTRL_MASK                        0x0000007FUL                         /**< Mask for CMU_LFRCOCTRL */
#define _CMU_LFRCOCTRL_TUNING_SHIFT                0                                    /**< Shift value for CMU_TUNING */
#define _CMU_LFRCOCTRL_TUNING_MASK                 0x7FUL                               /**< Bit mask for CMU_TUNING */
#define _CMU_LFRCOCTRL_TUNING_DEFAULT              0x00000040UL                         /**< Mode DEFAULT for CMU_LFRCOCTRL */
#define CMU_LFRCOCTRL_TUNING_DEFAULT               (_CMU_LFRCOCTRL_TUNING_DEFAULT << 0) /**< Shifted mode DEFAULT for CMU_LFRCOCTRL */

/* Bit fields for CMU AUXHFRCOCTRL */
#define _CMU_AUXHFRCOCTRL_RESETVALUE               0x00000080UL                            /**< Default value for CMU_AUXHFRCOCTRL */
#define _CMU_AUXHFRCOCTRL_MASK                     0x000007FFUL                            /**< Mask for CMU_AUXHFRCOCTRL */
#define _CMU_AUXHFRCOCTRL_TUNING_SHIFT             0                                       /**< Shift value for CMU_TUNING */
#define _CMU_AUXHFRCOCTRL_TUNING_MASK              0xFFUL                                  /**< Bit mask for CMU_TUNING */
#define _CMU_AUXHFRCOCTRL_TUNING_DEFAULT           0x00000080UL                            /**< Mode DEFAULT for CMU_AUXHFRCOCTRL */
#define CMU_AUXHFRCOCTRL_TUNING_DEFAULT            (_CMU_AUXHFRCOCTRL_TUNING_DEFAULT << 0) /**< Shifted mode DEFAULT for CMU_AUXHFRCOCTRL */
#define _CMU_AUXHFRCOCTRL_BAND_SHIFT               8                                       /**< Shift value for CMU_BAND */
#define _CMU_AUXHFRCOCTRL_BAND_MASK                0x700UL                                 /**< Bit mask for CMU_BAND */
#define _CMU_AUXHFRCOCTRL_BAND_DEFAULT             0x00000000UL                            /**< Mode DEFAULT for CMU_AUXHFRCOCTRL */
#define _CMU_AUXHFRCOCTRL_BAND_14MHZ               0x00000000UL                            /**< Mode 14MHZ for CMU_AUXHFRCOCTRL */
#define _CMU_AUXHFRCOCTRL_BAND_11MHZ               0x00000001UL                            /**< Mode 11MHZ for CMU_AUXHFRCOCTRL */
#define _CMU_AUXHFRCOCTRL_BAND_7MHZ                0x00000002UL                            /**< Mode 7MHZ for CMU_AUXHFRCOCTRL */
#define _CMU_AUXHFRCOCTRL_BAND_1MHZ                0x00000003UL                            /**< Mode 1MHZ for CMU_AUXHFRCOCTRL */
#define _CMU_AUXHFRCOCTRL_BAND_28MHZ               0x00000006UL                            /**< Mode 28MHZ for CMU_AUXHFRCOCTRL */
#define _CMU_AUXHFRCOCTRL_BAND_21MHZ               0x00000007UL                            /**< Mode 21MHZ for CMU_AUXHFRCOCTRL */
#define CMU_AUXHFRCOCTRL_BAND_DEFAULT              (_CMU_AUXHFRCOCTRL_BAND_DEFAULT << 8)   /**< Shifted mode DEFAULT for CMU_AUXHFRCOCTRL */
#define CMU_AUXHFRCOCTRL_BAND_14MHZ                (_CMU_AUXHFRCOCTRL_BAND_14MHZ << 8)     /**< Shifted mode 14MHZ for CMU_AUXHFRCOCTRL */
#define CMU_AUXHFRCOCTRL_BAND_11MHZ                (_CMU_AUXHFRCOCTRL_BAND_11MHZ << 8)     /**< Shifted mode 11MHZ for CMU_AUXHFRCOCTRL */
#define CMU_AUXHFRCOCTRL_BAND_7MHZ                 (_CMU_AUXHFRCOCTRL_BAND_7MHZ << 8)      /**< Shifted mode 7MHZ for CMU_AUXHFRCOCTRL */
#define CMU_AUXHFRCOCTRL_BAND_1MHZ                 (_CMU_AUXHFRCOCTRL_BAND_1MHZ << 8)      /**< Shifted mode 1MHZ for CMU_AUXHFRCOCTRL */
#define CMU_AUXHFRCOCTRL_BAND_28MHZ                (_CMU_AUXHFRCOCTRL_BAND_28MHZ << 8)     /**< Shifted mode 28MHZ for CMU_AUXHFRCOCTRL */
#define CMU_AUXHFRCOCTRL_BAND_21MHZ                (_CMU_AUXHFRCOCTRL_BAND_21MHZ << 8)     /**< Shifted mode 21MHZ for CMU_AUXHFRCOCTRL */

/* Bit fields for CMU CALCTRL */
#define _CMU_CALCTRL_RESETVALUE                    0x00000000UL                         /**< Default value for CMU_CALCTRL */
#define _CMU_CALCTRL_MASK                          0x0000007FUL                         /**< Mask for CMU_CALCTRL */
#define _CMU_CALCTRL_UPSEL_SHIFT                   0                                    /**< Shift value for CMU_UPSEL */
#define _CMU_CALCTRL_UPSEL_MASK                    0x7UL                                /**< Bit mask for CMU_UPSEL */
#define _CMU_CALCTRL_UPSEL_DEFAULT                 0x00000000UL                         /**< Mode DEFAULT for CMU_CALCTRL */
#define _CMU_CALCTRL_UPSEL_HFXO                    0x00000000UL                         /**< Mode HFXO for CMU_CALCTRL */
#define _CMU_CALCTRL_UPSEL_LFXO                    0x00000001UL                         /**< Mode LFXO for CMU_CALCTRL */
#define _CMU_CALCTRL_UPSEL_HFRCO                   0x00000002UL                         /**< Mode HFRCO for CMU_CALCTRL */
#define _CMU_CALCTRL_UPSEL_LFRCO                   0x00000003UL                         /**< Mode LFRCO for CMU_CALCTRL */
#define _CMU_CALCTRL_UPSEL_AUXHFRCO                0x00000004UL                         /**< Mode AUXHFRCO for CMU_CALCTRL */
#define CMU_CALCTRL_UPSEL_DEFAULT                  (_CMU_CALCTRL_UPSEL_DEFAULT << 0)    /**< Shifted mode DEFAULT for CMU_CALCTRL */
#define CMU_CALCTRL_UPSEL_HFXO                     (_CMU_CALCTRL_UPSEL_HFXO << 0)       /**< Shifted mode HFXO for CMU_CALCTRL */
#define CMU_CALCTRL_UPSEL_LFXO                     (_CMU_CALCTRL_UPSEL_LFXO << 0)       /**< Shifted mode LFXO for CMU_CALCTRL */
#define CMU_CALCTRL_UPSEL_HFRCO                    (_CMU_CALCTRL_UPSEL_HFRCO << 0)      /**< Shifted mode HFRCO for CMU_CALCTRL */
#define CMU_CALCTRL_UPSEL_LFRCO                    (_CMU_CALCTRL_UPSEL_LFRCO << 0)      /**< Shifted mode LFRCO for CMU_CALCTRL */
#define CMU_CALCTRL_UPSEL_AUXHFRCO                 (_CMU_CALCTRL_UPSEL_AUXHFRCO << 0)   /**< Shifted mode AUXHFRCO for CMU_CALCTRL */
#define _CMU_CALCTRL_DOWNSEL_SHIFT                 3                                    /**< Shift value for CMU_DOWNSEL */
#define _CMU_CALCTRL_DOWNSEL_MASK                  0x38UL                               /**< Bit mask for CMU_DOWNSEL */
#define _CMU_CALCTRL_DOWNSEL_DEFAULT               0x00000000UL                         /**< Mode DEFAULT for CMU_CALCTRL */
#define _CMU_CALCTRL_DOWNSEL_HFCLK                 0x00000000UL                         /**< Mode HFCLK for CMU_CALCTRL */
#define _CMU_CALCTRL_DOWNSEL_HFXO                  0x00000001UL                         /**< Mode HFXO for CMU_CALCTRL */
#define _CMU_CALCTRL_DOWNSEL_LFXO                  0x00000002UL                         /**< Mode LFXO for CMU_CALCTRL */
#define _CMU_CALCTRL_DOWNSEL_HFRCO                 0x00000003UL                         /**< Mode HFRCO for CMU_CALCTRL */
#define _CMU_CALCTRL_DOWNSEL_LFRCO                 0x00000004UL                         /**< Mode LFRCO for CMU_CALCTRL */
#define _CMU_CALCTRL_DOWNSEL_AUXHFRCO              0x00000005UL                         /**< Mode AUXHFRCO for CMU_CALCTRL */
#define CMU_CALCTRL_DOWNSEL_DEFAULT                (_CMU_CALCTRL_DOWNSEL_DEFAULT << 3)  /**< Shifted mode DEFAULT for CMU_CALCTRL */
#define CMU_CALCTRL_DOWNSEL_HFCLK                  (_CMU_CALCTRL_DOWNSEL_HFCLK << 3)    /**< Shifted mode HFCLK for CMU_CALCTRL */
#define CMU_CALCTRL_DOWNSEL_HFXO                   (_CMU_CALCTRL_DOWNSEL_HFXO << 3)     /**< Shifted mode HFXO for CMU_CALCTRL */
#define CMU_CALCTRL_DOWNSEL_LFXO                   (_CMU_CALCTRL_DOWNSEL_LFXO << 3)     /**< Shifted mode LFXO for CMU_CALCTRL */
#define CMU_CALCTRL_DOWNSEL_HFRCO                  (_CMU_CALCTRL_DOWNSEL_HFRCO << 3)    /**< Shifted mode HFRCO for CMU_CALCTRL */
#define CMU_CALCTRL_DOWNSEL_LFRCO                  (_CMU_CALCTRL_DOWNSEL_LFRCO << 3)    /**< Shifted mode LFRCO for CMU_CALCTRL */
#define CMU_CALCTRL_DOWNSEL_AUXHFRCO               (_CMU_CALCTRL_DOWNSEL_AUXHFRCO << 3) /**< Shifted mode AUXHFRCO for CMU_CALCTRL */
#define CMU_CALCTRL_CONT                           (0x1UL << 6)                         /**< Continuous Calibration */
#define _CMU_CALCTRL_CONT_SHIFT                    6                                    /**< Shift value for CMU_CONT */
#define _CMU_CALCTRL_CONT_MASK                     0x40UL                               /**< Bit mask for CMU_CONT */
#define _CMU_CALCTRL_CONT_DEFAULT                  0x00000000UL                         /**< Mode DEFAULT for CMU_CALCTRL */
#define CMU_CALCTRL_CONT_DEFAULT                   (_CMU_CALCTRL_CONT_DEFAULT << 6)     /**< Shifted mode DEFAULT for CMU_CALCTRL */

/* Bit fields for CMU CALCNT */
#define _CMU_CALCNT_RESETVALUE                     0x00000000UL                      /**< Default value for CMU_CALCNT */
#define _CMU_CALCNT_MASK                           0x000FFFFFUL                      /**< Mask for CMU_CALCNT */
#define _CMU_CALCNT_CALCNT_SHIFT                   0                                 /**< Shift value for CMU_CALCNT */
#define _CMU_CALCNT_CALCNT_MASK                    0xFFFFFUL                         /**< Bit mask for CMU_CALCNT */
#define _CMU_CALCNT_CALCNT_DEFAULT                 0x00000000UL                      /**< Mode DEFAULT for CMU_CALCNT */
#define CMU_CALCNT_CALCNT_DEFAULT                  (_CMU_CALCNT_CALCNT_DEFAULT << 0) /**< Shifted mode DEFAULT for CMU_CALCNT */
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
