maltanar/equine-health-monitor-gdp12/efm32-common/ports_gg332f1024.h

// University of Southampton, 2012
// EMECS Group Design Project

// Port configurations for the Giant Gecko used in the GDP PCB
// (part number GG332F1024)
// automatically included by port_config.h

#ifndef __PORTS_GG332F1024_H
#define __PORTS_GG332F1024_H

#include "uartport.h"
#include "i2cbus.h"

// -------------------------------------------------------------------------
// Section: Peripheral port mappings ---------------------------------------
// -------------------------------------------------------------------------
#define GPS_USART_PORT		USARTManagerPortLEUART0
#define ANT_USART_PORT		USARTManagerPortLEUART1
#define XBEE_USART_PORT		USARTManagerPortUSART0
#define MIC_USART_PORT		USARTManagerPortUSART1
#define SD_USART_PORT		USARTManagerPortUSART2
// -------------------------------------------------------------------------
// End Section: Peripheral port mappings -----------------------------------
// -------------------------------------------------------------------------

// -------------------------------------------------------------------------
// Section: Misc GPIO port config ------------------------------------------
// -------------------------------------------------------------------------
// PE8 controls the transistor that turns on/off the GPS Vcc
#define	GPIO_GPS_VCC_PORT		gpioPortE
#define	GPIO_GPS_VCC_PIN		8
#define GPIO_GPS_VCC			GPIO_GPS_VCC_PORT, GPIO_GPS_VCC_PIN
// PA5 controls the transistor that turns on/off the GPS Vbat
#define	GPIO_GPS_VBAT_PORT		gpioPortA
#define	GPIO_GPS_VBAT_PIN		5
#define GPIO_GPS_VBAT			GPIO_GPS_VBAT_PORT, GPIO_GPS_VBAT_PIN
// PA1 is connected to INT1 pin of ADXL
#define GPIO_ADXL_INT1_PORT 	gpioPortA 
#define GPIO_ADXL_INT1_PIN 		1
#define GPIO_ADXL_INT1			GPIO_ADXL_INT1_PORT, GPIO_ADXL_INT1_PIN
// PA0 is connected to INT2 pin of ADXL
#define GPIO_ADXL_INT2_PORT 	gpioPortA 
#define GPIO_ADXL_INT2_PIN 		0
#define GPIO_ADXL_INT2			GPIO_ADXL_INT2_PORT, GPIO_ADXL_INT2_PIN
// PE9 is connected to DRDY' pin of TMP006
#define GPIO_TMP006_DRDY_PORT 	gpioPortE 
#define GPIO_TMP006_DRDY_PIN 	9
#define GPIO_TMP006_DRDY		GPIO_TMP006_DRDY_PORT, GPIO_TMP006_DRDY_PIN
// PA10 is connected to the transistor that turns on/off the ANT Vcc
#define GPIO_ANT_VCC_PORT 		gpioPortA 
#define GPIO_ANT_VCC_PIN 		10
#define GPIO_ANT_VCC			GPIO_ANT_VCC_PORT, GPIO_ANT_VCC_PIN
// PA4 is connected to the sleep pin of the ANT
#define GPIO_ANT_SLEEP_PORT 	gpioPortA 
#define GPIO_ANT_SLEEP_PIN 		4
#define GPIO_ANT_SLEEP			GPIO_ANT_SLEEP_PORT, GPIO_ANT_SLEEP_PIN
// PA2 is connected to the RTS/SEN pin of the ANT
#define GPIO_ANT_RTS_PORT 		gpioPortA 
#define GPIO_ANT_RTS_PIN 		2
#define GPIO_ANT_RTS			GPIO_ANT_RTS_PORT, GPIO_ANT_RTS_PIN
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
