maltanar/equine-health-monitor-gdp12/(commit log)

2012-11-08 switch to sampleSensor / readSensor approach for sensors
2012-11-09 switch alarm system to RTC-based operation, first example of alarm & sensor integration
2012-11-09 initial commit of GPS sensor prototyping project
2012-11-10 initial commit for I2C bus driver with singleton pattern
2012-11-10 switch to I2C C++ drivers
2012-11-15 add a UART C++ interface draft - just a simple copyover from the C code, needs more work and some design decisions
2012-11-18 add DMAManager class, basic support for LEUART DMA to the UARTPort class (which is more LEUART0Port at the moment)
2012-11-18 rework GPS to use DMA
    [gpssensor.cpp, gpssensor.h, main.cpp]
2012-11-18 cleanup DMAManager, remove unneeded defines, clarify errors a bit more
    [dmamanager.cpp]
2012-11-18 add UARTManager class to implement factory pattern for UART management
2012-11-18 modify UARTPort to work with UARTManager factory pattern
2012-11-18 work with UARTManager
2012-11-18 make GPS DMA configurable, and work with both configs
2012-11-19 add UARTManager-based port of libgbee for Energy Micro Tiny Gecko uC's - this is not suited for going into upstream repos!
2012-11-19 add USART1 support to UART subsystem
2012-11-23 Basic Accelerometer Driver
2012-11-23 reordered structure of include files adopted libgebee-test & integration projects to new structure added uC-version specific headers for uartmanager and i2cmanager
2012-11-23 updated the tmp006 project to use the new directory structure updated the i2cbus class to use the port definition in the i2cmanager header
2012-11-23 increase accelerometer field width to 16 bits
2012-11-23 cleanup and C++ize accelerometer driver with 4-phase power mgmt, compliant with new dir structure/I2C driver model
2012-11-24 updated integration project to compile & run without linker errors
    [integration.cpp]
2012-11-24 start adding sensor class implementations to top level folder
2012-11-24 test GPS module, add sensor folder path and release configuration to project
2012-11-24 add AccelerationSensor to top level sensors folder
2012-11-24 fix I2C on GG devkit
    [i2cbus.cpp]
2012-11-24 add accelerometer to integration project
2012-11-24 add TemperatureSensor to top level sensors folder
2012-11-24 add TemperatureSensor to integration project
2012-11-24 remove part-specific i2cmanager and uartmanager files
2012-11-24 added sleep mode configuration for XBee end devices to XBee::init funcion
2012-11-26 GPIO pins used in the PCB were defined
2012-11-26 Revert "Merge branch 'master' of https://code.google.com/p/equine-health-monitor-gdp12"
    This reverts commit d5fc71657b59b8474b4265b2e5c4f82935b6a18f, reversing
    changes made to bc12302d168c68f397bc7986aad0468b0bf63898.
    [alarm.h, gbee.c, main.cpp, port_config.h, ports_gg332f1024.h]
2012-11-26 added missing include statements for I2C and USART headers
    [ports_tg840f32.h]
2012-11-27 add skeleton code for singleton AlarmManager class, to replace the C-style Alarm module
    [alarmmanager.cpp, alarmmanager.h]
2012-11-27 modify sensors and integration project to work with new message types
2012-11-27 make I2C bus poll sleep mode configureable via I2CBUS_POLL_SLEEP
2012-11-27 state UART port location with regular integers instead of defines
2012-11-28 fix port include files for TG840F32
    [ports_tg840f32.h]
2012-11-28 renaming SensorType to DeviceType
2012-11-28 modify UART to work without buffers if rx hook is set
2012-11-29 add support for new packed messages into Sensor class
2012-11-29 add support for packed messages into GPS class, make DMA more configurable and autonomous
2012-11-29 periodic sampling of peripherals with AlarmManager, GPS now working and serializing data correctly
    [debug_output_control.h, integration.cpp]
2012-11-29 modify temperature sensor implementation to use newest message types and serialization (single sample)
2012-11-29 add periodic sampling output from temperature sensor
2012-11-29 calculate message size in Sensor base class depending on number of samples and configured sample size
2012-11-29 modify accelerometer implementation to store and serialize multiple samples
2012-11-29 add periodic accelerometer data output
2012-11-29 modify timestamp to mark last sample time in seconds
2012-11-29 example for adding timestamps to messages and starting timers simulataneously
2012-11-29 extend USARTManager port declarations to support SPI (no functionality yet)
2012-11-29 move RTC base drivers to efm32-common
2012-11-29 include final PCB mcu (GG332) in port_config.h
2012-11-29 commit folder structure and integration example for final PCB projects
2012-11-30 a correction was made in defines.
    [microsd.c]
2012-12-01 big USART driver cleanup: rename UARTManager to USARTManager, define base USARTPort class and derive UARTPort and LEUARTPort from this
2012-12-01 Unit tests for the accelerometer, GPS and temperature sensor were created.
2012-12-02 introduce controlling #define's for USART interrupt routing
2012-12-02 XBee interface: added de-/serialize functions for MessagePackage objects
2012-12-02 convert remaining non-singleton sensor classes into singletons
2012-12-02 make unit tests / PCB project compile with newest versions
2012-12-02 fix singleton sensor inits
    [integration.cpp]
2012-12-02 make TemperatureSensor configurable between raw and calculated temperature messages
2012-12-02 ANT hard reset implementation
    [alarmmanager.h, anthrmsensor.cpp, anthrmsensor.h, debug_output_control.h, main.cpp]
2012-12-03 Revert "Merge branch 'master' of https://code.google.com/p/equine-health-monitor-gdp12"
    This reverts commit 7633cdd09a8237260c184b4710665ec8916acb0e, reversing
    changes made to 0485a0290e5ad727c390889e1f7108067413d6cd.
    [accelerationsensor.cpp, accelerationsensor.h, alarmmanager.cpp, alarmmanager.h, anthrmsensor.cpp, anthrmsensor.h, debug_output_control.h, integration.cpp]
2012-12-03 messagetypes.h: added relTimestampS to message base class xbee_if.cpp: adepted de-/serialize functions to changes in messagetypes
2012-12-03 take microsd SPI config from our config system, make C++ compiler deal with fatfs sources
2012-12-03 switch to raw temp messages only
2012-12-03 fix port configs a bit
    [ports_gg332f1024.h, ports_gg990f1024.h]
2012-12-04 proof-of-concept for alarms and DPC based advanced power management with TMP006 on the PCB. wheee!
2012-12-04 add calculateTemp as static function that takes raw reading arguments from the sensor (won't really be used, just for readable output if needed)
    [temperaturesensor.cpp, temperaturesensor.h]
2012-12-05 enable timeouts for SD card driver
2012-12-05 stop created disk-op alarms after done, in case they are not needed
2012-12-05 add static functions to configure GPS power pins
2012-12-05 implement power pin configs only if defined
2012-12-05 GPS sleep using Vbat power pin
2012-12-05 add MessageStorage, APM timers for other sensors
2012-12-05 accelerometer: add bitfield values in comments, fix sampling rate config
    [accelerationsensor.cpp]
2012-12-05 output raw SensorMessage + data size
2012-12-06 rework GPS DMA logic, separate signal frame handling from DMA itself
    [dmamanager.cpp, dmamanager.h, gpssensor.cpp, gpssensor.h, leuartport.cpp, leuartport.h]
2012-12-06 make DMA RX part of the USART config
2012-12-06 DMA channel defs for GG DK and TG STK
2012-12-06 increase default sampling period for temperature sensor
2012-12-06 decrease ANT reset time, increase rx buffers, handle all buffers on sampleSensorData
    [anthrmsensor.cpp, anthrmsensor.h]
2012-12-06 zigbee printf
2012-12-07 simple audio sample storage
2012-12-08 fix audio state machine to make pingpong work again
    [audio.cpp, audio_dma.cpp, debug_output_control.h]
2012-12-08 turn power off to everything else in mic unit test
2012-12-10 add macros to configure XBee power and sleep GPIOs
2012-12-10 add static power control functions to ANT
2012-12-10 rework GPS unit test to use 4-phase power management, power off everything else before starting
2012-12-10 add comments to sensor interface
2012-12-10 fix debug message packets
    [integration.cpp]
2012-12-10 Temp unit tests on DVK for monitoring sensor and MCU current consumption
2012-12-10 re-integrate sensors to cleaned up project
2012-12-11 fix ANT unit tests, ANT still uses LEUART+interrupt based receiving
    [anthrmsensor.cpp, anthrmsensor.h]
2012-12-11 allow DMA callbacks while configuring channel
2012-12-11 Report: added part list tables in Appendix
    [partlist_part1.csv, partlist_part2.csv]
2012-12-11 Report: Added PCB layout figures to Appendix
2012-12-11 Report: added references/bibliography
    [partlist_part2.csv]
2012-12-12 Report: added Price List to appendix
    [price_list.csv]
2012-12-13 use variables to access SPI port configuration, in hopes of increasing SD stability
    [microsd.h]
2012-12-13 adjust sensor periods better, handle GPS and ANT in a special way
2012-12-13 Report: More stuff in the appendix, restructured Future Work
    [gut_sound_recordings.csv]
2012-12-13 Report: Added schematics to Appendix
    [price_list.csv]
2012-12-13 Report: synced up to chapter PCB design, restructuring, adding images
2012-12-13 Report: Stuff
    [authorship.csv, authorship2.csv]
